offsideAI/macrodork-docs/docs/actuator-selection.md

# Actuator Selection and Parameters

> 🔌 For the servo-bus protocol comparison (including Feetech STS/SCS and HD-1910 specs) see [Hardware Teardown](hardware-teardown.md).

## The Motor: Dynamixel XL330, 15 of Them

| | |
|---|---|
| Model | **Dynamixel XL330-M288-T** (evidence below) |
| Count | **15** - the `xl330` mesh is referenced 15 times in the full MJCF |
| Under policy control | **14**, in the action space: 5 left leg + 4 neck/head + 5 right leg |
| The 15th | Drives the beak/jaw through a `passive_*` linkage - **not in the action space** |
| Mounting | M2 screws (the servo body has 4× Ø2.0 clearance holes + 8× Ø1.6 tapping holes) |
| Supply | ⚠️ **Rated 3.7–6.0 V; the actual bus is 6.6–8.2 V - run over-voltage.** See below |

## ⚠️ The voltage truth: the XL330 is run over-voltage

> **Correction (2026-09-04)**: this document used to call the XL330 a "7.4 V class servo".
> **That was wrong**, and it propagated into the rejection of the Feetech STS3032 and into the
> torque comparison below.

**Robotis official specification**
([XL330-M288-T e-manual](https://emanual.robotis.com/docs/en/dxl/x/xl330-m288/), checked 2026-09-04):

| Item | Official |
|---|---|
| Input voltage | **3.7 – 6.0 V** |
| Recommended | **5.0 V** |
| Stall torque | 0.42 N·m @3.7 V / **0.52 N·m @5.0 V** / 0.60 N·m @6.0 V |
| Gear ratio | 288.4 : 1 |
| Size / weight | 20 × 34 × 26 mm / 18 g |

**The upstream design actually feeds them 6.6 – 8.2 V.** Three independent points in the source agree:

| Source | Value |
|---|---|
| BAM config in `microduck_constants.py` | `vin_range=(6.5, 8.2)`, `vin_min=6.0` |
| `robotd` voltage adaptation | clamped **6.0 – 9.5 V** |
| Battery | NP-F550 is 2S Li-ion: 7.4 V nominal, 8.4 V full |

#### Hard evidence: the official HAT schematic

People reasonably ask: "the XL330 takes 5 V, where's the over-voltage?" 5 V is the
**value recommended in the ROBOTIS datasheet**, not what the upstream design actually wires up.
The official HAT is open source (`pollen-robotics/elec_RPI_Robot_HAT`, Apache-2.0), and
sheet 4/6 `dynamixel.kicad_sch` spells it out:

| Circuit | Actual connection |
|---|---|
| Dynamixel connectors J11 / J13 / J14 | Power pin ties to **`+BATT`** (raw battery), annotated `3A max`, through TH1 100R thermistor |
| Between `+BATT` and the servos | **No regulation at all** - J13/J14 through a TH1 100R thermistor, J3/J11 direct.<br>(U10 LM5050-1 sits *after* the buck on the `+5V` rail, not at the battery input.) |
| The only converter on the board | **U9 AP63205** + **L4 6.8 µH** (Fsw 1.1 MHz, 2 A) → outputs `+5V` |
| Where `+5V` goes | The **Raspberry Pi 40-way header J4**, the PAM8406D audio amp, the EEPROM - the schematic even carries a Pi power table next to it (Pi 5: 9–10 W / Pi 4B: 6–7.6 W / Pi Zero 2W: 1.5 W) |

**The whole 47-line HAT BOM contains exactly one buck and one inductor.** There is no second
rail. The 5 V is *for the Pi*; the servos hang directly off the battery - and a 2 A AP63205
could not feed 15 XL330s anyway (~1.5 A each at stall).

**So upstream runs the XL330 continuously above its 6.0 V rated maximum, up to about 8.2 V.**

### What that means

- ✅ **More torque than the datasheet figure.** Stall torque rises roughly linearly with voltage, so
  at 8 V it is well above 0.52 N·m. This is likely part of how an 18 g servo carries an 800 g robot.
- ⚠️ **Lifetime and heat are the price.** Over-voltage stresses windings and MOSFETs. Upstream has
  published nothing on this, so **the following is inference**: it may relate to the servo heating
  users report, and to upstream starting to consider selling repair kits (see [Community Intelligence](community-intelligence.md)).
- ⚠️ **You have to make this call yourself.** Copy them and you over-volt too. Play safe with a
  regulator down to 5–6 V and you lose torque - **which may mean retraining the policies**, since
  the official ONNX files were trained under the over-volted condition.

> This also explains the firmware's voltage adaptation: `scale × (7.4 / measured EMA)`. As the
> battery falls from 8.4 V to 6.5 V the same PWM produces very different torque; without
> compensation a policy would behave differently at different states of charge.

---

## Joint Travel

| Joint | Travel | Radians |
|---|---|---|
| `hip_yaw` | −25° … +30° | −0.436 … 0.524 |
| `hip_roll` | ±22° | ±0.384 |
| `hip_pitch` / `knee` / `ankle` / `head_pitch` | ±90° | ±1.571 |
| `neck_pitch` | −90° … +60° | −1.571 … 1.047 |
| `head_yaw` | ±170° | ±2.967 |
| `head_roll` | ±25° | ±0.436 |

> The right leg's `hip_yaw` mirrors the left: −30° … +25°.

## The BAM M6 Actuator Config (what ships)

From `robot/microduck_constants.py`:

```python
_BAM_ACTUATOR_KWARGS = dict(
    motor_name="xl330",
    model="m6",
    target_names_expr=(r"^(?!passive_).*",),   # exclude passive joints
    kp_fw=200.0,             # firmware position-loop stiffness (microduck keeps 200, microban uses 125)
    vin_range=(6.5, 8.2),    # per-env battery voltage sampled at startup
    vin_drop_gain_range=(0.0, 0.2),   # load-dependent sag: V_drop = gain * sum(|tau|)
    vin_min=6.0,             # hard floor on the effective voltage after sag
    delay_min_lag=3,         # command delay, in control steps
    delay_max_lag=6,
)
```

BAM M6 is a **voltage-level** model. It is not a simple PD controller - it simulates the
whole chain from firmware PD → PWM → voltage → current → torque, and adds load-dependent
friction (Coulomb + Stribeck + load term) on top. **This is the core of the sim2real
recipe.**

### Three domain randomisations that matter

| Item | Range | What it models |
|---|---|---|
| `vin_range` | 6.5 – 8.2 V | the pack from full charge to flat |
| `vin_drop_gain_range` | 0.0 – 0.2 | **load-dependent sag** - bus voltage dropping when many servos pull at once |
| `delay_min/max_lag` | 3 – 6 steps | communication + firmware latency between command and execution |

`actuator/friction_dr_bam.py` adds a **per-env `friction_scale`** that multiplies only the
**velocity-independent** friction budget (stiction / gearbox), leaving the viscous term at
nominal - because stiction is where the dominant sim2real uncertainty lives.

### Backlash modelling

`BacklashEncoderBamActuator` reproduces a real detail that is easy to miss:

> On the real servo the magnetic encoder sits on the **output side** of the gear play, so
> the firmware position loop closes on `joint angle + backlash angle`. While the servo
> winds through the dead zone, **the measured position does not change, and neither does
> the PD error.**

The implementation feeds `cmd.pos` as `qpos[main] + qpos[backlash]`. Velocity `cmd.vel` is
deliberately left motor-side - it drives back-EMF and friction, which are rotor physics,
not an encoder-derived signal.

The backlash model lives in `robot_allcollisions_backlash.xml`: each servo gets a
`passive_<joint>_backlash` hinge in series.

## Five Calibrated Native-PD Parameter Sets (fallback)

`joints_properties.xml` keeps five sets, all results of BAM bench identification.
**If you use MuJoCo's built-in PD instead of BAM, copy these numbers directly:**

| class | damping | frictionloss | armature | kp | forcerange (N·m) |
|---|---|---|---|---|---|
| `chosen_actuator` ⭐ | 0.053 | 0.0048 | 0.0018 | 0.55 | ±0.96 |
| `chosen_actuator_antoine` | 0.044 | 0.013 | 0.0017 | 0.43 | ±0.75 |
| `chosen_actuator_old` | 0.048 | 0.006 | 0.002 | 0.52 | ±0.91 |
| `chosen_actuator_new` | 0.041 | 0.032 | 0.002 | 0.386 | ±0.67 |
| `perfect_actuator` | 0.15 | 0.1 | 0.001 | 10.0 | ±20.0 |

⭐ = the current default (commented "marc"). `ctrlrange` is ±10.0 throughout.
`perfect_actuator` is an idealised motor for comparison only - **do not train a policy on
it if that policy is going onto real hardware.**

Passive joints: `passive_wheel` / `passive_joint` - damping 0, frictionloss 0,
armature 0.0001.

## Why the XL330: It All Comes Down to the Mass Budget

The XL330 was not chosen because it is strong. It was chosen because **it fits an entire
drive train into 18 g**:

```
motor + 288:1 gearbox + encoder + driver + position loop + bus interface  =  18 g
```

The whole robot is 737 g; the 15 servos alone are 270 g of it (37 %). Nothing else fits in
that box.

### Where the torque comes from: the gearbox, not the motor

### How the model number was pinned down

Upstream has never named the sub-model publicly - the source carries only
`motor_name="xl330"`, **with no suffix**. One independent evidence chain narrows it to
**M288-T**:

1. `microduck_rl` simulates the servos with the **BAM** actuator model, configured as
   `motor_name="xl330"`, `model="m6"` (`microduck_constants.py`), which loads
   `bam/params/xl330/m6.json`
2. BAM is [`Rhoban/bam`](https://github.com/Rhoban/bam), whose README lists its library of
   **identified models**, and the entry for this servo reads
   **`Dynamixel XL330-M288-T`**
3. So the friction model the policies are trained against was **identified on a physical
   XL330-M288-T on a test bench**

Corroboration: on 2026-09-03 the Korean robotics observer
[@Allyakutaku](https://x.com/Allyakutaku/status/2095331280233926948) reported identifying the
motor as XL330-M288-T from official video footage.

> ⚠️ Strictly, this proves the servo **the simulation was calibrated against** is an M288-T.
> That the physical robot uses the same part is a very strong inference, but **not a
> statement from upstream**.

The **288** in the model number is the gear ratio: **288.35:1** (the same family also has
the M077 at 77.9:1).

The coreless motor inside produces only a few **milli**newton-metres on its own; the
288:1 reduction multiplies that to the **±0.96 N·m** (~9.8 kg·cm) calibrated in the MJCF.

**The cost of that is written directly into the model:** the higher the ratio, the more
backlash - which is why `robot_allcollisions_backlash.xml` puts a `passive_*_backlash`
hinge in series with every joint, modelling **±1.0°** of gear play.

---

## Why Closed-Loop Steppers Do Not Work Here

It is a natural idea, and for **static positioning** (CNC, 3D printers) it is the right
one. For a legged robot there are several hard problems:

### 1. Mass - this alone settles it

| | Unit mass | What that includes |
|---|---|---|
| **XL330** | **18 g** | motor + gearbox + encoder + driver + control loop + bus, **all of it** |
| NEMA 8 stepper | ~60 g | **bare motor** - no encoder, no driver, no gearbox |

Fifteen bare NEMA 8s is 900 g - **the motors alone exceed the entire robot's mass (737 g)**,
before anything else is added.

### 2. Holding current

A stepper **must draw rated current to hold position**. A standing biped needs holding
torque at all 15 joints continuously, and the pack is 2600 mAh 2S with about an hour of
runtime.

A servo closes a position loop, so **current approaches zero when the error is small and
the load is light**. Standing still costs almost nothing.

There is a thermal consequence too: fifteen steppers pulling rated current inside a sealed
25 cm plastic body have nowhere to dump the heat.

### 3. ⭐ Backdrivability - the critical one, and the easiest to overlook

A legged robot **has to absorb impacts.** Look at `limp_fall` in the official
`robotd.toml`:

> When a fall is detected, the gain drops from 200 to **`gain_limp = 50`** so the joints
> "give way rather than fight the floor"; after a soft landing the pose is ramped back to
> standing over 600 ms.

**A stepper cannot do this.** It has two states - energised and locked, or unpowered and
free-spinning (and even then it has detent torque). **There is no adjustable impedance in
between.**

A closed-loop stepper corrects lost steps, but that is **recovery after the fact**, not
**compliance in the moment**. What a footfall impact needs is to yield, not a correction
transient.

The entire sim2real recipe - the BAM model, `kp_fw=200`, gain ramping, the soft landing -
rests on the premise that **the servo is a spring with adjustable stiffness**. A stepper is
not a spring. It is a position lock.

### 4. Wiring

15 servos = **one 3-wire daisy chain.**
15 steppers = 15 × 4 phase wires + 15 encoder cables + 15 driver boards.
Inside a 25 cm body, with a neck that has to rotate - it does not fit.

### 5. The part does not exist

18 g, a 288:1 gearbox, integrated encoder and driver, bus daisy chain - **nothing on the
market matches that.**

---

## What Swapping to a Feetech STS3215 Actually Costs

The STS3215 (Feetech, Shenzhen) sells for roughly **¥60–70** - about **a fifth** of the
XL330 (~¥299) - and it is **stronger** (1.86 N·m vs 0.96 N·m). It looks like the obvious
way to cut cost.

**But it is three times heavier (~55–60 g vs 18 g).** Here is what that does, measured.

### Hard data: same architecture, different servo, different robot

Both are 15-rigid-body bipedal robot ducks. Total mass from their MJCFs:

| | Servo | **Total mass** | Height |
|---|---|---|---|
| **Macrodork** | XL330 | **737.2 g** | 25 cm |
| **Open Duck Mini v2** | STS3215 | **2107.1 g** | 42 cm |

**2.86×.**

> 💡 **Open Duck Mini v2 *is* the STS3215 answer.** Same engineer (Antoine Pirrone,
> upstream R&D), same bipedal-duck architecture - swap the servo and the robot can only be
> built at 42 cm and 2.1 kg.

### Actuator parameters: every one differs by an order of magnitude

| Parameter | XL330 (`chosen_actuator`) | STS3215 (`sts3215`) | Ratio |
|---|---|---|---|
| **kp** | 0.55 | **17.8** | **32×** |
| **forcerange** | ±0.96 N·m | **±3.35 N·m** | **3.5×** |
| **damping** | 0.053 | **0.60** | **11×** |
| **frictionloss** | 0.0048 | **0.052** | **11×** |
| **armature** | 0.0018 | **0.028** | **15.5×** |
| modelled backlash | **±1.0°** | ±0.5° | - |

> Sources: `microduck_rl/.../joints_properties.xml` and
> `Open_Duck_Playground/playground/open_duck_mini_v2/xmls/joints_properties.xml`
>
> 📌 A counter-intuitive detail: **the XL330 is modelled with *more* backlash** (±1° vs
> ±0.5°). That may be a difference in how the two projects model it, or it may be the
> price of the 288:1 reduction.

**This is not a re-tune. These are two entirely different actuators.**

### Can you swap without changing the mechanics? No.

| Constraint | Why |
|---|---|
| **Size** | The XL330 measures **29 × 20 × 34 mm** (from `xl330.stl`). The servo cavities in the printed parts are cut to that; the STS3215 is a visibly larger class and does not fit |
| **Mounting** | Horn bolt circle, output-shaft spec and case mounting holes all differ - the M2 pattern this repository reverse-engineered (Ø2.2 clearance + Ø4.4 counterbore) is the XL330's |
| **Mass budget** | 15 × (57−18) ≈ **585 g extra**, before thickening any structure to carry it. Adding 585 g to a 737 g robot invalidates the centre of mass, the joint torque requirements and the structural design |

**This is not "swapping a servo." It is building a different robot.**

### What breaks / what survives

| Breaks | Survives |
|---|---|
| ❌ All nine official ONNX policies | ✅ **The 61-D observation contract and 14-D action space** |
| ❌ The BAM M6 calibration (identified on the XL330) | ✅ The training frameworks (microduck_rl / Playground) |
| ❌ The five `chosen_actuator` sets above | ✅ The sim2real methodology (BAM identification, domain randomisation, backlash modelling) |
| ❌ The backlash model (needs re-measuring) | |
| ❌ MJCF masses and inertias (all recomputed) | |
| ❌ The wire protocol (Feetech SCS/STS, not Dynamixel V2) | |

> **One piece of good news on the protocol:** Open Duck Mini uses
> `rustypot.feetech(port, 1000000)` - **the same `rustypot` crate, just a different
> protocol module**, at the same 1 Mbps. So replacing `Xl330Controller` in the Rust
> runtime is feasible without rewriting the communication layer.

**What changes is the robot model and the actuator model - not the algorithm.**

---

## Same-Class Servos: Why the Gap Is Still Open

"Is there a cheaper XL330?" is the most common question. The answer: **parts in the same
weight class do exist, but none of them satisfies torque and voltage at the same time.**

| Model | Mass | Size (mm) | Stall torque | Voltage | Encoder | Ratio |
|---|---|---|---|---|---|---|
| **Dynamixel XL330-M288-T** ⭐ | **18 g** | **20 × 34 × 26** | **0.52 N·m @5 V**<br>0.60 @6 V / 0.42 @3.7 V | **3.7–6.0 V**<br>5 V recommended | 12-bit | 288.4:1 |
| **Feetech STS3032** | 20 g | **23.2 × 12.1 × 28.5** | 0.44 N·m<br>(4.5 kg·cm @6V) | **4.8–6 V** | 12-bit | - |
| **Feetech SCS0009** | **11 g** | - | 0.23 N·m<br>(2.3 kg·cm) | 6 V | 10-bit | 1:416 metal gears |
| Feetech STS3215 | ~55–60 g | larger class | 1.86 N·m<br>(19 kg·cm) | 7.4 V | 12-bit | - |
| Dynamixel XL330-M077 | 18 g | same as M288 | low (high-speed variant) | same as M288 | 12-bit | 77.9:1 |
| **Unitree S288** ⭐ | **19.5 g** | **34 × 20 × 23** | **unclear (see below)** | **12.6 V** | **15-bit dual<br>+ output-side** | **288.35:1** |
| Unitree J288 | 35 g | 34 × 20 × 23 | unclear (metal-gear version) | 25.2 V | same as S288 | 288.35:1 |

> **This table uses vendor stall-torque figures throughout** (checked against each
> manufacturer's site on 2026-09-04), so the rows are comparable.
>
> The `forcerange = ±0.96` in this repository's MJCF is a **MuJoCo simulation force limit, not a
> vendor figure**, and has been removed from the table - earlier versions compared it directly
> against other vendors' stall torques, which was wrong.
>
> XL330 dimensions are Robotis' official 20 × 34 × 26 mm; the 29 × 20 × 34 measured from
> `xl330.stl` includes the horn and cable socket.
> Everything else is vendor-published data. **Prices vary enormously by region and are not
> listed here** - the same STS3032 retails imported in India at about ₹3,451, and at an
> entirely different price level in China.

### ⭐ Unitree S288: the only part that matches the XL330 across the board

A 2026 arrival. **Its mechanical parameters line up almost item for item** - right down to
the "288" in the model number:

| | XL330-M288 | Unitree S288 | |
|---|---|---|---|
| Mass | 18 g | **19.5 g** | ✅ |
| Size | 20 × 34 × 26 mm | **34 × 20 × 23 mm** | ✅ |
| **Gear ratio** | **288.35:1** | **288.35:1** | ✅ **identical** |
| Mounting screws | M2 | **M2** | ✅ |
| Bus physical layer | single-wire half-duplex TTL | **single-wire half-duplex TTL (1-Wire)** | ✅ |
| Baud rate | 1 Mbps | **6 Mbps** | ⬆️ 6× |
| Motor | brushed coreless | **brushless, FOC** | ⬆️ |
| Encoder | 12-bit, rotor side | **15-bit dual + output-side** | ⬆️⬆️ |
| Control mode | position loop + kp | **torque feedforward + adjustable stiffness/damping** | ⬆️⬆️ |
| **Voltage** | ~7.4 V (2S) in practice - rated 3.7–6.0 V, **run at 6.6–8.2 V** | **12.6 V (3S)** | ⚠️ **incompatible** |
| **Bus capacity** | 253 addresses | **15 (0–14; 15 is broadcast)** | ⚠️ |
| Torque | **0.96 N·m** | **unclear** | ⚠️ |

> Dimensions, connector, protocol and control law come from the official
> [J288/S288 brushless digital servo user manual](https://www.unitree.com/images/%E6%97%A0%E5%88%B7%E6%95%B0%E5%AD%97%E8%88%B5%E6%9C%BAJ288S288%E4%BD%BF%E7%94%A8%E6%89%8B%E5%86%8C.pdf)
> (11 pages, read in full); mass, voltage and encoder resolution from the
> [product page](https://www.unitree.com/cn/DigitalServo/).

#### Two substantive upgrades

**1. Impedance control, not a position servo**

The manual gives the hybrid control law:

```
tau = tau_ff + k_p * (p_des - p) + k_d * (w_des - w)
```

**Torque feedforward plus adjustable stiffness and damping**, over an FOC inner loop.

Upstream's `limp_fall` buys compliance by dropping kp from 200 to 50; with an S288 you
would **command the torque directly** - cleaner, and exactly the joint-level force control
a legged robot actually wants.

**2. An output-side encoder - which eliminates the backlash problem outright**

The return packet carries `uint16_t OutPos : 13` (output-side sensor, 2^13 per revolution).

The XL330's encoder is on the **rotor side** and cannot see gear play - which is precisely
why `microduck_rl` has to add `passive_*_backlash` hinges and simulate the "firmware
position loop reads through the backlash" behaviour (see `BacklashEncoderBamActuator`
above).

**The S288 measures the true joint angle directly, and all of that complexity goes away.**

Its telemetry also includes case temperature, winding temperature, servo-side voltage,
rotor torque/speed/position, and a 22-bit fault code (over-current, over-voltage,
under-voltage, chip/MOSFET/case/winding over-temperature, errors on each of the three
encoders, and so on). Far richer than the XL330's.

#### Three hard constraints

**① Voltage: 12.6 V vs 7.4 V**
This robot is 2S (NP-F550); the S288 wants **3S**. Battery, power distribution and the HAT
all have to be redesigned.

**② The bus holds only 15 servos**
The address space is **0–14** (15 is broadcast). The robot has exactly 15 servos - **the
space is exactly full** - but its bus also carries the **IMU board at ID 200**.
**Under an S288 design the IMU must move to SPI or I²C.**

> This agrees with the recommendation in [Hardware Teardown](hardware-teardown.md):
> moving the IMU off the servo bus onto the host's SPI is better for reliability anyway.

**③ ⚠️ The torque specification is ambiguous - and unresolved**

The product page lists the S288 stall torque as "same direction **0.07 N·m** / reverse
**0.2 N·m**", but the manual states plainly:

> "All parameters in the protocol are **rotor-side** data. The reduction ratio is 288.35;
> to convert rotor-side data to output-side, multiply or divide by that ratio."

Neither reading works:

| Reading | Output torque | Verdict |
|---|---|---|
| Those figures are **rotor-side** | 20 / 58 N·m | ❌ impossible for a 19.5 g servo |
| Those figures are **output-side** | 0.2 N·m | ❌ one fifth of the XL330's (0.96) - not a drop-in |

**This has to be confirmed with Unitree, or measured.** Four questions worth asking:

1. Is the quoted stall torque **rotor-side or output-side**?
2. What exactly do "same direction / reverse" mean - forward vs reverse rotation, or
   driving vs backdriving?
3. What are the **output-side** continuous and peak torques?
4. Is 12.6 V nominal or a maximum? Can it run at 7.4 V, and how much torque is lost?

> For extrapolation: the J288 is the 35 g metal-gear version, listed at 0.5 / 1.5 N·m. If
> 1.5 is output-side, that is plausible for 35 g of brushless at 288:1 and beats the
> XL330. Scaling down suggests the S288 might land near 0.5 N·m output-side - **but this
> is speculation and not a basis for a decision.**

#### Verdict: mechanically a drop-in, electrically and protocol-wise not

| | |
|---|---|
| ✅ **Mechanical** | Size, mass, gear ratio and M2 pattern all correspond; the printed parts may need little or no change |
| ⚠️ **Electrical** | 12.6 V vs 7.4 V - battery and power system must be redesigned |
| ❌ **Protocol** | Unitree's own 20-byte command / 26-byte reply with CRC32 at 6 Mbps, nothing like Dynamixel Protocol V2; `rustypot` does not support it, so the communication layer must be rewritten |
| ❌ **Policies** | All nine official ONNX policies become invalid - both the torque characteristics and the control mode change |
| ✅ **What you gain** | Joint force control, an output-side encoder, a 6 Mbps bus, rich thermal and fault telemetry |

**If the torque question resolves favourably, this is currently the only XL330 alternative
worth evaluating seriously.**

### STS3032: right size, wrong torque and voltage

The closest of the Feetech parts: **smaller than the XL330** (23.2 × 12.1 × 28.5 vs
29 × 20 × 34), nearly the same mass (20 g vs 18 g), the same 12-bit encoder class, the same
half-duplex bus architecture.

**Two problems - and note that this document previously overstated both:**

1. **Torque is about 85 %, not 46 %** - on a same-voltage basis, 0.44 N·m @6 V vs the
   XL330's 0.52 N·m @5 V. The earlier "46 %" compared 0.44 against the simulation force
   limit 0.96; the two are not comparable.
2. **The voltage ceiling is 6 V - but the XL330's ceiling is also 6 V.**
   The difference is not in the servo specs; it is that **upstream chose to run over-voltage**
   (see the section above). To copy the design with an STS3032 you either over-volt it
   the same way (at your own risk) or add a regulator stage down to 5 V.

### Could you mix servo types?

| Joint group | Count | Torque demand | STS3032 enough? |
|---|---|---|---|
| Legs (hip yaw/roll/pitch, knee, ankle) | 10 | High - carries 737 g and absorbs landing impacts | ❌ **no** |
| Neck / head (pitch, yaw, roll) | 4 | Medium - drives a 189 g head assembly | ⚠️ possibly |
| Mouth | 1 | Low | ✅ yes |

**Mixing is theoretically possible; a full swap is not.** But mixing means solving the
7.4 V → 6 V step-down, and the two servo types have different BAM parameters, backlash and
response delay - training would need per-group actuator models, which adds considerable
complexity.

### A telling data point: upstream uses Feetech themselves

**The SCS0009 is used in upstream's own
[Amazing Hand](https://github.com/pollen-robotics/AmazingHand) and HopeJR.**

They are not unaware of the cheap option - **these legs genuinely need that
torque.** 0.23 N·m is enough for a finger joint and not enough for a biped's knee.

### Where the gap is

```
Wanted:  18-20 g  .  >=0.5 N.m at rated voltage  .  tolerates direct 2S supply or carries its own regulator  .  bus daisy chain  .  integrated encoder + driver
Today:   Robotis XL330     meets all of it, but must be over-volted to 6.6-8.2 V to do so
         Unitree S288      meets mass/size/ratio/bus; the 12.6 V (3S) rating is the only obstacle
         Feetech STS3032   meets mass/size, torque ~85 %, shares the XL330's 6 V ceiling
```

**The gap is being squeezed - the Unitree S288 has closed most of it.** What still blocks
it is the voltage class (3S vs 2S) and the unresolved torque labelling. If Unitree ships a
2S variant, or the torque is confirmed at the 0.9 N·m level, the slot is filled.

Feetech's line is heading the same way - **SCS0009 (11 g) → STS3032 (20 g) is a clear
"smaller and bus-connected" trajectory**; the housing is already there, what is missing is
raising the ratio or the voltage class to lift the torque into the 0.9 N·m range.

Two market signals reinforce this:

- The **LeRobot ecosystem** (Hugging Face) has already made the STS3215 a de facto standard for arms
- **The upstream robot passed $1 M in sales within seven hours of launch**, proving real demand at the 18–20 g scale

> ⚠️ **This is a read of the trend, not a prediction.** As of 2026-08-31 no vendor has
> announced such a part. But the gap is well defined, the housings exist, and the demand is
> demonstrated - it is plausible that this slot gets filled.

**If such a part does appear**, this repository becomes more valuable, not less: the
mechanical geometry, the assembly relationships, the electronics design and the actuator
parameters are all already understood, so adapting is a matter of days rather than starting
from zero.

---

## Conclusion: There Is No Middle Path

| Route | Outcome |
|---|---|
| **Keep the XL330** | Use this repository's CAD directly, run the official policies as they are. Servos cost about **¥4,500** |
| **Switch to the STS3215** | Servo cost drops to about **¥1,000**, but every mechanical part is redesigned and every policy retrained - **which is, in effect, building [Open Duck Mini v2](https://github.com/apirrone/Open_Duck_Mini)** (fully open: BOM, Onshape CAD, 36 STLs, assembly guide, working walk policy) |
| **Switch to the Unitree S288** | Mechanically almost a match (19.5 g / 34×20×23 / 288.35:1 / M2), and brings joint force control plus an output-side encoder. Needs a 3S pack, a rewritten communication layer and retrained policies - **and the torque spec is ambiguous and must be confirmed first** - see the dedicated section above |
| **Wait** | The gap is closing. If a 2S variant appears, or the torque is confirmed, this repository's mechanical and electronics work carries straight over |

**Within this weight class, only Robotis currently offers enough torque.** The Feetech
STS3032 is smaller and about the same mass, but delivers about **85 %** of the torque
(0.44 N·m @6 V vs the XL330's 0.52 N·m @5 V, same-voltage basis) with a 6 V ceiling; the
SCS0009 is lighter (11 g) but only 0.23 N·m. See the side-by-side comparison in the
previous section.

## A Note on Cost

The XL330-M288-T varies enormously by channel (checked 2026-09-04): **$23.90** at ROBOTIS
international, **$27.49** at ROBOTIS US, **€40.20** inc-VAT at Generation Robots, **€41.95** at
MyBotShop - that is **$359 / $412 / €603 / €629** for
fifteen - and around ¥299 each domestically in China, about **¥4,500** for fifteen. Either
way that exceeds the **$399** retail price of the finished robot. $399 is a volume price an
individual cannot reach.
