offsideAI/macrodork-docs/assets/hw/macrodork-hardware-diagrams.pdf

M A C R O D O R K · E L E C T R O N I C S

# Macrodork hardware diagrams

### Five modules, two home-made boards, one bus. Every pin, address and register is taken from the official open-source hardware project and the runtime

source code; none of it has been verified on real hardware.

Servo bus · half-duplex TTL 1 Mbps | +BATT 6.6–8.2 V | +5V / +3V3 | I²C · 400 kHz | MIPI CSI | I²S audio

Bus devices
16

15 servos + 1 IMU board

Control cycle

# 20 ms

50 Hz, one read, one write

Home-made boards
2

HAT is open source / IMU board must be drawn

Policy network

# 775 KiB

×9 ONNX files

# Where things live

The easiest thing to get wrong: the main board is not in the trunk, it is in the head. Camera, main board and HAT all belong to the same MJCF body, jaw_soft ; the camera sits about 13 mm from the centre of the main board with no joint in between. The trunk cavity is almost entirely filled by the two hip-yaw servos, and the battery hangs outside, below the rear of the body.

How to read: grey dashed boxes are physical regions, solid boxes are modules, a red dashed box means mounted outside the shell. Orange is the servo bus (top to bottom), red is battery power (bottom to top). The camera is only ~13 mm from the main board and shares its rigid body, so buy the shortest MIPI ribbon you can; what actually has to pass through the 3-DoF neck is the servo bus and the power wiring, and those two bundles are the flex-fatigue points. Source: robot_walk.xml:235 (HAT), :247 (main board), both inside the jaw_soft body.

READ THIS BEFORE BUYING
Because the main board lives in the head and the slot is only 65 × 30 mm, no larger board will fit - the LCSC Taishan Pi is 70 × 45 mm, the same RK3566 but it does not go in, and a HAT still has to sit on top of it.

01

Head · MJCF body jaw_soft

IMX219 camera

### 8 MP · MIPI CSI

Mounted rotated 90°

MIPI CSI

~13 mm · no joint

Radxa Zero 3W main board

RK3566 · 65 × 30 mm · NPU 0.8 TOPS

40-pin header

RPI Robot HAT

65.0 × 30.9 mm · 4-layer · 113 SMD parts

I²S

i2c3 · 0x29

Speaker 5 W + microphone

Wago terminals · on-board MEMS

ToF module

VL53L5CX / L8CX · 8×8

Neck · 3 DoF Only these two bundles cross the neck

Servo bus ↓
3 wires: V+ / GND / DATA

+BATT supply ↑
Battery in the trunk, HAT in the head

Trunk · trunk_base shell 80.9 × 64.0 × 41.8 mm

Hip-yaw servos ×2

XL330 · ID 10 / 20
These two fill most of the cavity No room for a main board

imu_to_dxl

ID 200 · 16th device on the bus

STM32G031 + LSM6DSV16X
The only board drawn from scratch

Remaining servos ×13

ID 11–14 · 21–24
ID 30–34
legs / neck / head / jaw

NP-F550 battery

2S · 6.6–8.2 V
38.6 × 20.6 × 70.8 mm
Hangs outside, rear-bottom of the body ~40 mm hangs outside the shell

Dashed box = mounted outside the shell

The bus is a 3-wire daisy chain (V+ / GND / DATA): power and data share one cable. The solid dots at the three tap points mean they all join the same bus.

# The battery feeds two rails; the servos run on raw battery voltage

This is the most counter-intuitive thing on the whole HAT: the servos are wired to raw battery voltage, with no step-down at all. The XL330 is officially rated 3.7–6.0 V, recommended 5.0 V, yet here it gets 6.6–8.2 V. That is not a typo; it is a deliberate upstream choice - more stall torque, paid for in heat and lifetime.

Key evidence: in the HAT's 47-line BOM there is only one inductor (L4) and one buck (U9); FB1/FB2/FB3 are ferrite beads, not energy-storage inductors. So that 5 V rail can only be for the main board - a 2 A AP63205 could not drive 15 XL330s anyway (about 1.5 A each at stall).

## Supply, charging and over-voltage protection

02

NP-F550

6.6 – 8.2 V
2S Li-ion

+BATT

J13 / J14 TTL 3P
JST EH 2.5 mm · the XL330s use these two

TH1 100R

J3 / J11 RS-485 4P

Direct +BATT · U8 SIT3088E driver

Servos - no step-down anywhere, marked 3 A max

C19
10µF/63V

U9 AP63205 + L4

### 6.8 µH · 2 A · 1.1 MHz

The only switching regulator on the board

Q2 · U10 LM5050
Ideal diode + shutdown detect

+5V

Main-board 40-pin header

PAM8406D amplifier

XC6206 → +1V8
audio codec

+3V3 goes the other way: the main board feeds it to the HAT over the 40-pin header; the HAT does not generate it itself.

How to read: above the axis are the voltages that will actually occur, below it are the voltage ratings of each part. Whenever a line below falls inside a range above, that part is the bottleneck. Common 3.3 V LDOs all land inside the battery range - they simply burn. ⚠ The back-EMF magnitude is illustrative, not measured - it depends on cable inductance and commutation speed; put a scope on it once the parts arrive.

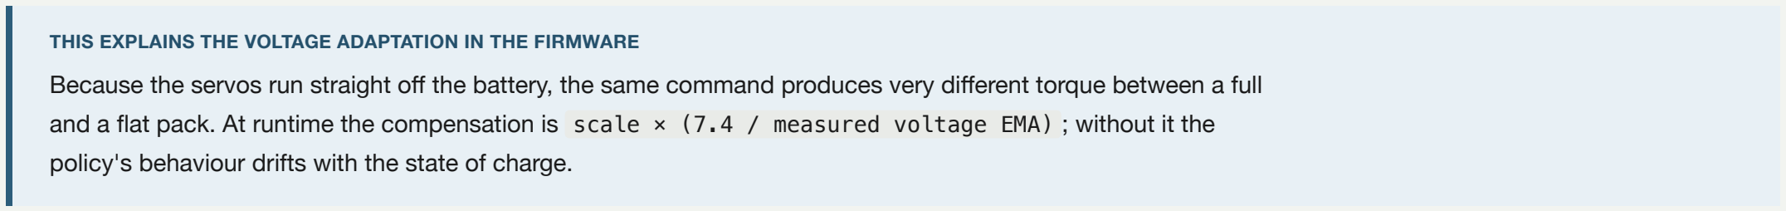
[picture p4: figure]

THIS EXPLAINS THE VOLTAGE ADAPTATION IN THE FIRMWARE
Because the servos run straight off the battery, the same command produces very different torque between a full and a flat pack. At runtime the compensation is scale × (7.4 / measured voltage EMA) ; without it the policy's behaviour drifts with the state of charge.

Charging - there is no charging circuit on the board

External cradle charger
The battery comes off to charge

NP-F550

2S · 6.6 – 8.4 V

⚠ The stock HAT has no charging IC and no USB-C receptacle
Plugging in USB-C will not charge the robot - checked against the full BOM

+BATT

15 × servos

via TH1 100R · 3A max

AP63205 → +5V

Main board → feeds +3V3 back to the HAT

imu_to_dxl
Same rail as the servos ↓

imu_to_dxl input protection chain - it shares the bus with the servos and will see back-EMF

3P connector into the board
6.6 – 8.4 V

PPTC 100 mA
A shorted board does not drag the bus down
(to be added)

TVS SMAJ12A
Clamps at 19.9 V · next to the connector
(to be added)

C6 10µF/25V
+ 100nF at the input pin

HT7533-1
30 V operating / 33 V absolute max → +3V3

Voltage window - the bottleneck at a glance Battery 6.6–8.4 V
Servo back-EMF can lift the bus into this range

Depends on cable inductance and commutation speed - must be measured

0 | 5 | 10 | 15 | 20 | 25 | 30 | 35 V
⚠ XL330 rated max 6.0 V (the stock design runs it over) | C7 10 V (on the 3.3 V output side - sufficient) | C6 25 V ✓

✕ Common 3.3 V LDOs all top out here (shaded band, 5.5–6.5 V)
- inside the battery range, they simply burn
| | | | | TVS clamp 19.9 V ← spikes are held here
⚠ Feetech HD-1910 max 8.4 V - exactly a full charge, zero margin | HT7533-1 operating 30 V ✓ margin 3.5×

Three lines of defence: a wide-input LDO (chosen) blocks sustained over-voltage · a TVS (to be added) clamps transient spikes · a PPTC (to be added) keeps a fault on this board from taking the whole bus down. A series diode guards against reverse polarity; it does nothing for forward over-voltage.

# Sixteen devices on one bus

This is the central argument of the whole design: 15 servos are daisy-chained on one three-wire bus, and the IMU also masquerades as a device on that bus. So the main board issues a single sync_read per cycle and gets body attitude and all 15 joint angles back together - timestamps aligned by construction, with no software juggling of jitter between two separate data paths.

Why not ordinary servos: PWM servos are open-loop and cannot report their real angle, and the policy must know where every joint is right now. Bus servos have a built-in encoder and driver, and one UART handles all 15. Source: JOINT_IDS and IMU_DXL_ID in duck-control/src/model.rs .

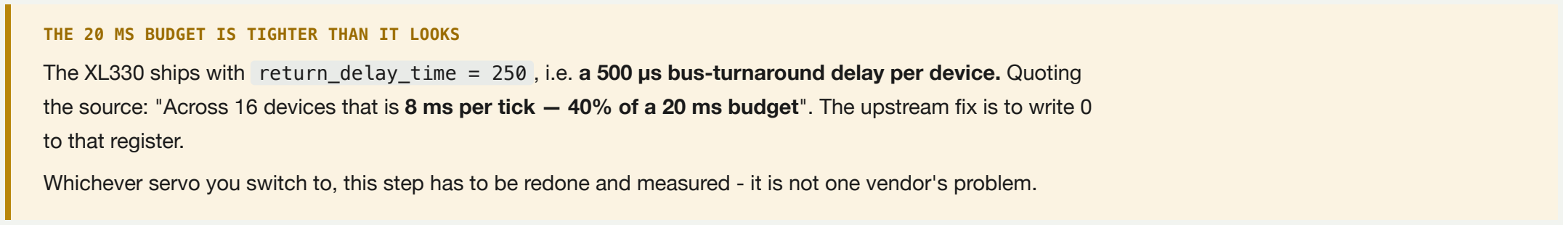
[picture p5: figure]
to that register.

THE 20 MS BUDGET IS TIGHTER THAN IT LOOKS
The XL330 ships with return_delay_time = 250 , i.e. a 500 µs bus-turnaround delay per device. Quoting the source: "Across 16 devices that is 8 ms per tick — 40% of a 20 ms budget". The upstream fix is to write 0

Whichever servo you switch to, this step has to be redone and measured - it is not one vendor's problem.

03

Main-board UART

/dev/ttyS2
GPIO14 Tx · GPIO15 Rx

Tx

Rx

Half-duplex direction switch

U5 74LVC1G08 (AND gate)
U6 1G125 · U7 1G126 (tri-state) Direction derived automatically from Tx

### 1 Mbps

single-wire half-duplex · 3-wire daisy chain

Right leg
ID 10 – 14
hip yaw / hip roll / hip pitch knee / ankle

Left leg
ID 20 – 24

Mirror of the right leg

Neck · head · jaw
ID 30 – 34

The jaw is not in the policy action space

imu_to_dxl
ID 200

Disguised as the 16th "servo" register 124 · 12 bytes

15 servos + 1 IMU board = 16 devices, all read back in a single sync_read.

# One cycle, 20 milliseconds

The control loop has only five steps, and they happen in this order. The numbers here are the real sequence, not typographic decoration.

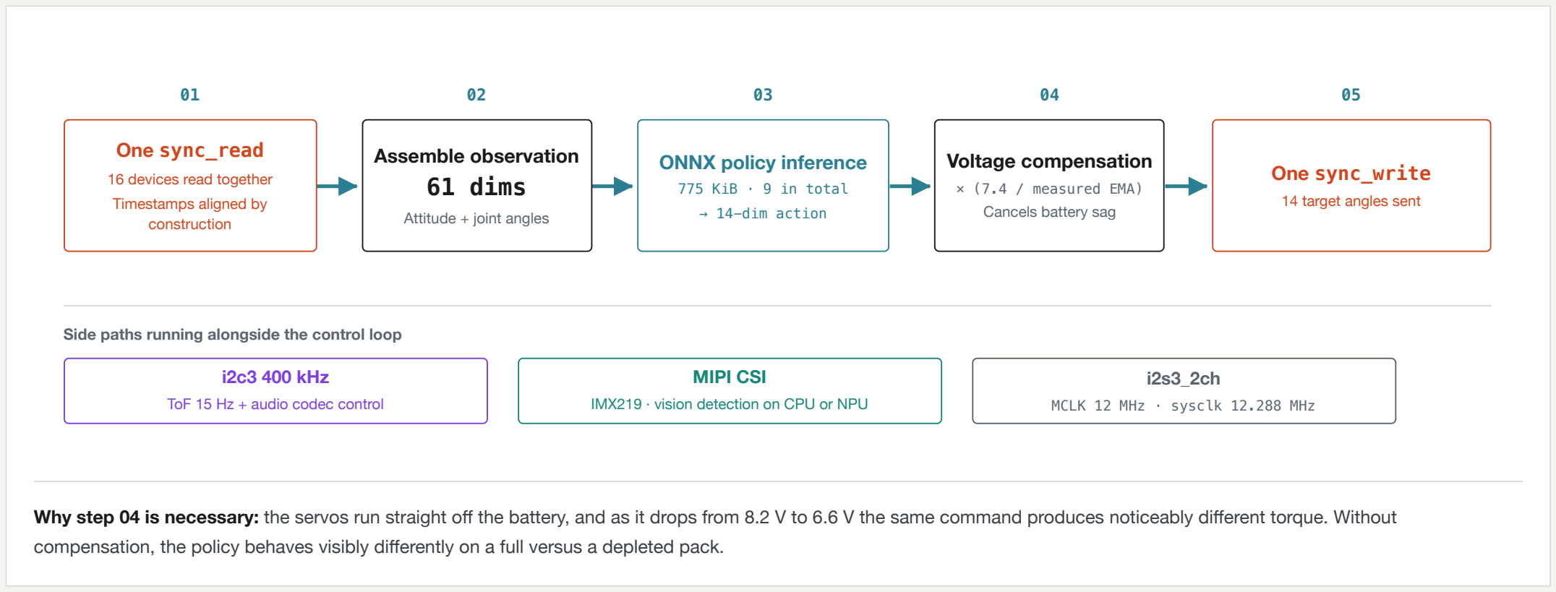
[picture p6: figure]
One sync_read; 16 devices read together Timestamps aligned by construction; Assemble observation 61 dims; Attitude + joint angles; ONNX policy inference; 775 KiB · 9 in total; → 14-dim action; Voltage compensation; × (7.4 / measured EMA) Cancels battery sag; One sync_write; 14 target angles sent; i2c3 400 kHz; ToF 15 Hz + audio codec control; MIPI CSI; IMX219 · vision detection on CPU or NPU; MCLK 12 MHz · sysclk 12.288 MHz

Why step 04 is necessary: the servos run straight off the battery, and as it drops from 8.2 V to 6.6 V the same command produces noticeably different torque. Without compensation, the policy behaves visibly differently on a full versus a depleted pack.

04

Side paths running alongside the control loop

# The board you have to draw yourself

Its entire job is three things: read the IMU, pack the data into 12 bytes, and hand those 12 bytes over when the host issues a sync_read . Upstream has not open-sourced this board, but the protocol and register layout can be reconstructed in full from the runtime source - the code is the spec.

Why the detour is worth it: if the IMU were wired straight to the main board over I²C or SPI, attitude and joint angles would arrive over two different data paths, their sample instants would not line up, and a few milliseconds of jitter would contaminate the 61-dimensional observation directly. As a bus device, the problem does not exist at the hardware level.

WORKS WITH BOTH FEETECH AND THE STOCK SERVOS: NO HARDWARE CHANGE
The physical layers of the two protocols are identical - half-duplex single-wire TTL, 1 Mbps, three wires, 2.5 mm pitch connector. They differ only in packet format: Dynamixel V2 is FF FF FD 00 + CRC-16, Feetech STS/SCS is FF FF + inverted checksum.
So draw the hardware once and give the firmware two parsers; it can even listen on the bus at power-up and check whether the third byte is FD to detect the protocol automatically - plug in and go.

05

LSM6DSV16X
ST 6-axis IMU
SFLP fusion block
Quaternion straight out of the chip

SPI

pins 12/13/14

STM32G031F8P6

Only moves and packs data
It does not compute the quaternion It only frames the reply

Half-duplex buffer

SN74LVC1G125
3-wire connector, 2.5 mm pitch

Servo bus
ID 200 · 1 Mbps

### 12 bytes starting at register 124

gyro X
int16 LE

gyro Y
int16 LE

gyro Z
int16 LE

quat X
fp16

quat Y
fp16

quat Z
fp16
0 | 2 | 4 | 6 | 8 | 10 | 12

Gyro range ±500 dps, 17.5 mdps/LSB.

Only x / y / z of the quaternion are sent - the host recovers w from the unit-quaternion constraint: w = √(1 − x² − y² − z²), saving 2 bytes.

Note: pins 12 / 13 / 14 in the diagram are CS / SCL / SDA, from ST DS13510 Rev 1 Table 1 (page 10).

# 40-pin usage and key addresses

PIN / BUS | PURPOSE | LINUX DEVICE | SOURCE
GPIO14 / GPIO15 | Servo bus Tx / Rx | /dev/ttyS2 @ 1 Mbps | robotd.toml
GPIO02 / GPIO03 | I²C - IMU, audio codec, Stemma | i2c3 @ 400 kHz | i2c3-pihat.dts
GPIO18 / 19 / 20 / 21 | Audio PCM clock / frame sync / in / out | i2s3_2ch | aic3104-i2c3.dts
GPIO06 | Shutdown detect | — | HAT schematic
GPIO22 | Interrupt pin of the BMI088 on the HAT - unused by software | — | i2c3-pihat.dts
MIPI CSI | IMX219 camera, mounted rotated 90° | radxa-zero3-rpi-camera-v2 | setup-board.sh
i2c3 · 0x18 | Audio codec TLV320AIC3104 | — | i2c3-pihat.dts
i2c3 · 0x29 / 0x52 | ToF, both addresses are tried | — | tof/src/main.rs
i2c3 · 0x19 / 0x68 | BMI088 - populated but marked dormant in software | — | i2c3-pihat.dts
Bus ID 200 | imu_to_dxl, register 124, 12 bytes long | — | duck- control/model.rs

THIS TABLE IS THE CHECKLIST
The upstream Microduck software is open source, so every address on the hardware has a counterpart in the code. If they don't match, one side is wrong - that is the cheapest verification step when replicating.

06

# Two routes: stock XL330 versus Feetech STS

The "IMU as the 16th device on the bus" architecture holds on Feetech too - because Feetech STS/SCS has its own bulk-read instruction, SYNC READ ( 0x82 ), used exactly the same way as on Dynamixel.

And the reply mechanism is the same on both sides. Protocol V2 does have a fast sync read ( 0x8A ) that merges every reply into one packet, but the official runtime does not use it - a repo-wide search for
fast_sync_read / 0x8A returns nothing, and duck-control/src/bus.rs:236 calls the plain sync_read_raw_data . This is also consistent with the "500 µs per device × 16 devices = 8 ms" in the source - if the replies were merged into one packet, the per-device delay would not be multiplied by 16.

Source: the Feetech side is read from scservo_sdk/group_sync_read.py (replies split packet by packet on [0xFF, 0xFF, scs_id] ) and register 7 of the STS memory map; the stock side from duck-control/src/bus.rs:236 and model.rs:84-86 . ⚠ Packet counts and spacing in both rows are drawn from the protocol as an illustration, not measured waveforms - measure with an FE-URT-1 once the parts arrive.

UNEXPECTED FINDING: OUT OF THE BOX, FEETECH IS ACTUALLY AHEAD
Register 7 (0x07) of the STS memory map, Return Delay Time: default 0, with the note "Not functional on STS".
The XL330 ships at 250 , i.e. 500 µs per device - quoting the upstream source: "Across 16 devices that is 8 ms per tick — 40% of a 20 ms budget" - and it has to be written to 0 by hand.
Since the reply mechanism is the same on both sides, this becomes the only substantive difference in the factory state - and it favours Feetech. Of course, writing a 0 on the XL330 side erases it, so this is not "Feetech is faster", it is "Feetech has one trap fewer".

07

Stock XL330 · sync_read (factory Return Delay = 250)

Host instruction packet

Dashed block = 500 µs idle wait per device (factory default; write 0 to remove it)

Feetech STS/SCS · sync_read 0x82 (Return Delay default 0)

Host instruction packet

16 independent status packets, back to back

Cumulative idle wait

### 8 ms / cycle

Cumulative idle wait
0

Both rows use the same reply mechanism - the official runtime uses the plain sync_read, not V2's packet-merging fast sync read (a repo-wide search for 0x8A finds nothing). The difference is in the factory defaults.

## Protocol differences at a glance

ITEM | DYNAMIXEL V2 · XL330 | FEETECH STS/SCS
Physical layer | Identical - half-duplex single-wire TTL, 3 wires (V+ / GND / DATA), 1 Mbps
Connector pitch | JST EH 2.5 mm | 5264, also 2.5 mm
Header | FF FF FD 00 | FF FF
Checksum | CRC-16 | ~sum (inverted sum)
Bulk read | sync read (what upstream actually uses) also fast sync read 0x8A, unused | sync read 0x82
Reply scheme | Same - one independent status packet per device
Bus turnarounds / cycle | 17 ⚠ | 17 ⚠

⚠ The turnaround count is inferred from the protocol (1 instruction + 16 replies), not measured

Factory return delay | 250 = 500 µs / device, must be written to 0 | Default 0, and not functional on STS
ID range | 0 – 252 | 0 – 253 (register 5)
Baud-rate setting | register baud_rate = 3 | register 6, 0 = 1M

ONE MORE REGISTER WORTH TUNING ON THE FEETECH SIDE
Register 8 (0x08) of the STS memory map, Response Level, default 1 - "reply to every command". Set it to 0 and only read and ping return a packet; ordinary write instructions no longer take up bus time.
This is the same kind of move as upstream writing 0 to return_delay_time on the XL330: the factory defaults are for general use; a high-rate control loop has to tune them itself.

## What switching to Feetech does to each module

MODULE | IMPACT | NOTES
Main board | Unchanged | Independent of the servo protocol
Camera / ToF | Unchanged | Each uses its own separate interface
HAT | No change at all | Feetech and XL330 have identical physical layers - 3-wire half-duplex TTL, 1 Mbps, 2.5 mm pitch connector. J13 / J14 on the HAT are TTL 3P ports; Feetech servos plug straight in, not a single wire needs to move
imu_to_dxl | Hardware architecture unchanged | Same physical layer, so one hardware revision is enough; the firmware detects the protocol from whether the third header byte is FD , with two parsing branches. Standardise the connector on 2.5 mm pitch and it works with both
Policy | Almost certainly needs retraining
Changing servos changes both the torque curve and the mass; the nine upstream ONNX files cannot be reused as they are. This is the single biggest piece of work on the whole route, and it has nothing to do with the protocol

ANOTHER QUESTION: DOES THIS HAT NEED TO BE BUILT AT ALL?
This is independent of which servo you pick; it is purely a cost call. The HAT is a 4-layer board with SMD assembly - prototyping starts at a few hundred yuan with a minimum order quantity - and roughly half the circuitry on it is audio (codec, amplifier, on-board microphone, speaker terminals).
If you are not doing voice features, that half of the board is wasted - in which case a bus adapter board costing twenty-odd yuan plus a buck module covers the two functions that are actually essential, "servo bus" and "power distribution", with the ToF hanging directly off i2c3. The price is losing on-board audio and Pi HAT+ identification.

DO THIS BEFORE DRAWING THE BOARD
The turnaround counts above are protocol facts, but converting them to milliseconds is an estimate. The real number depends on the tri-state buffer switching speed, the inter-packet gaps and the actual register length being read - only a measurement on real hardware will tell.
First thing once the servos arrive: connect a debug board, run both read methods, and time one full round of 16 devices. Until that number exists, the architectural decisions on the board are spinning in the void.

Derived from the publicly released MJCF model, STL meshes, open-source hardware project ( elec_RPI_Robot_HAT , Apache-2.0) and runtime source; not verified on real hardware. Every pin, address, register and reference designator in these diagrams can be cross-checked against those sources.
