offsideAI/macrodork-docs/_design-inspiration/menlo-asimov-1-desktop.png

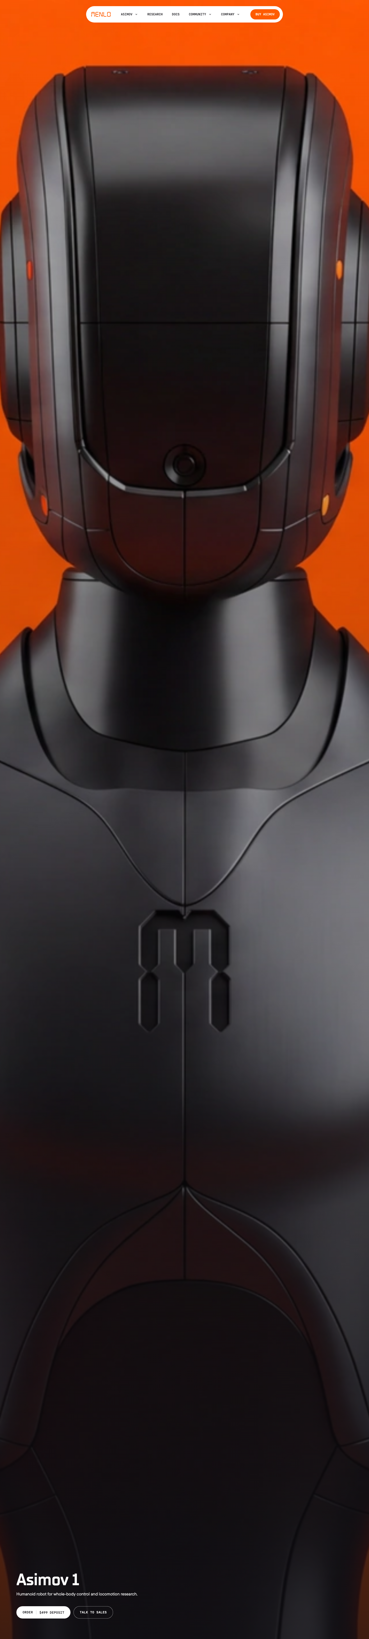
_design-inspiration/menlo-asimov-1-desktop.png
