offsideAI/macrodork-docs/_design-inspiration/menlo-asimov-1-fullpage.png

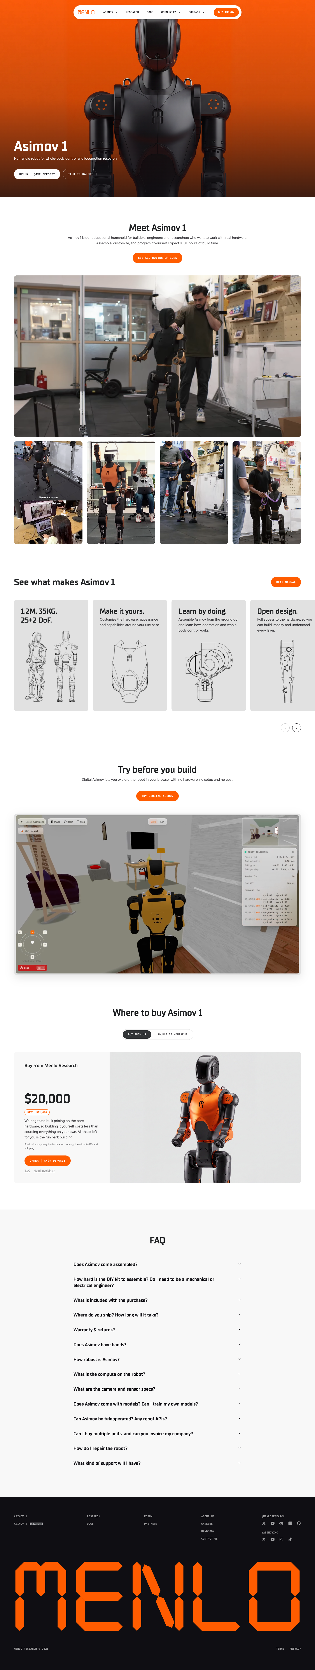
_design-inspiration/menlo-asimov-1-fullpage.png
