offsideAI/macrodork-docs/_design-inspiration/menlo-asimov-1-scroll-00.png

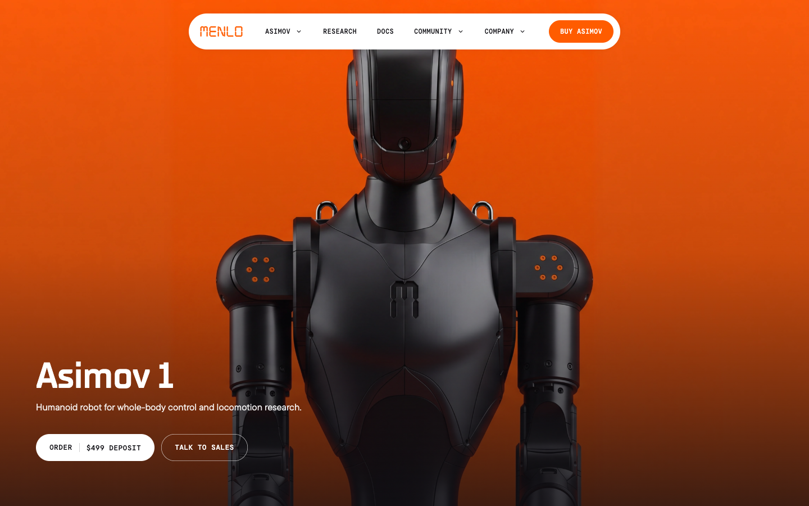
_design-inspiration/menlo-asimov-1-scroll-00.png
