offsideAI/macrodork-docs/_design-inspiration/menlo-asimov-1-scroll-03.png

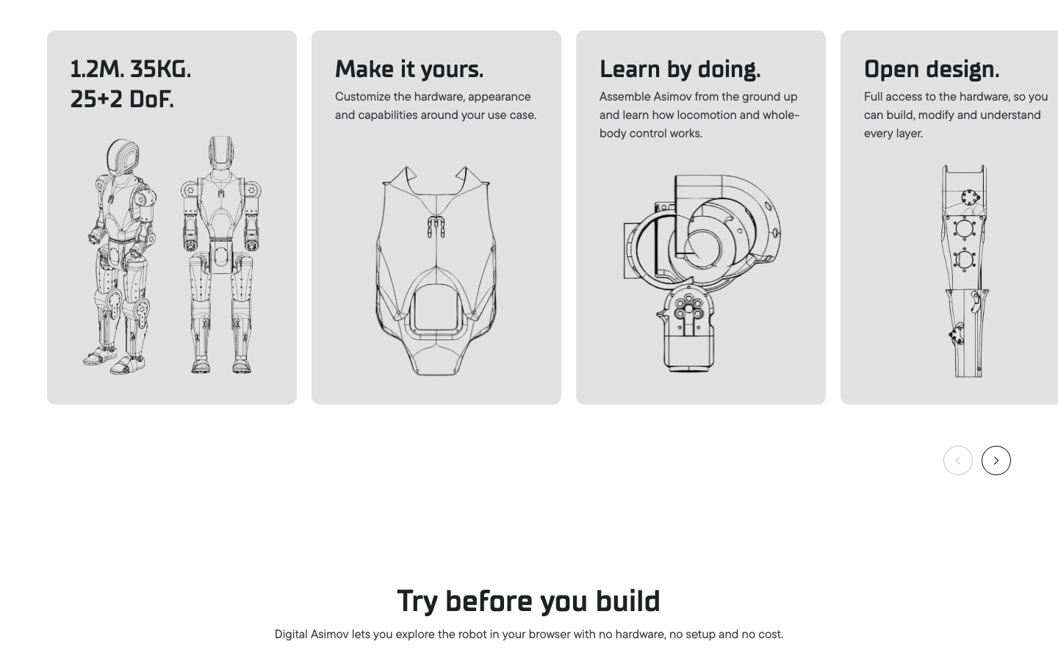
_design-inspiration/menlo-asimov-1-scroll-03.png
