offsideAI/macrodork-docs/_design-inspiration/menlo-asimov-1-scroll-05.png

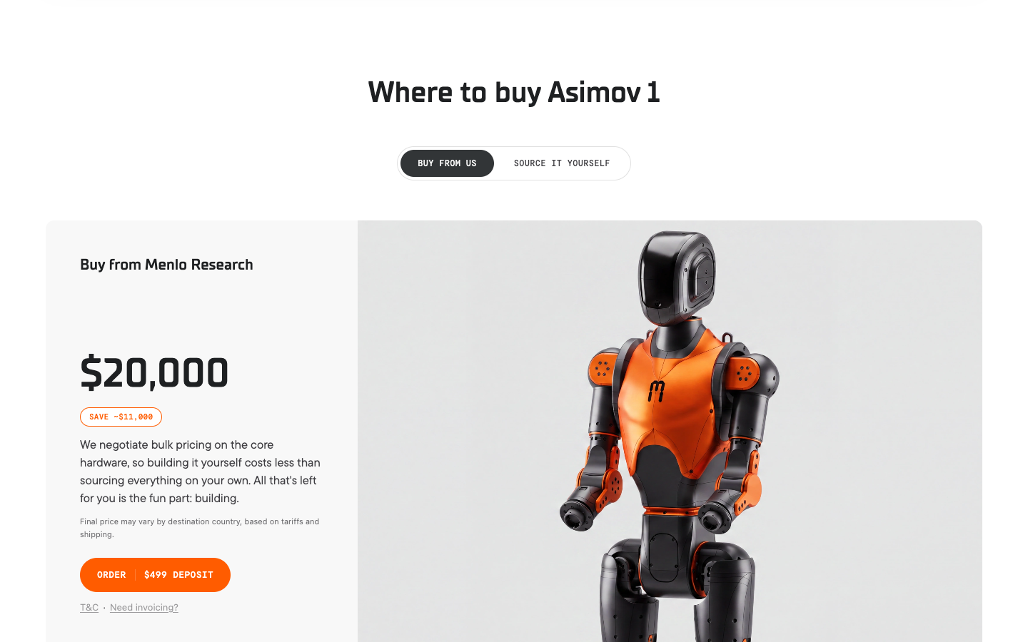
_design-inspiration/menlo-asimov-1-scroll-05.png
