offsideAI/macrodork-docs/_design-inspiration/menlo-asimov-1-scroll-07.png

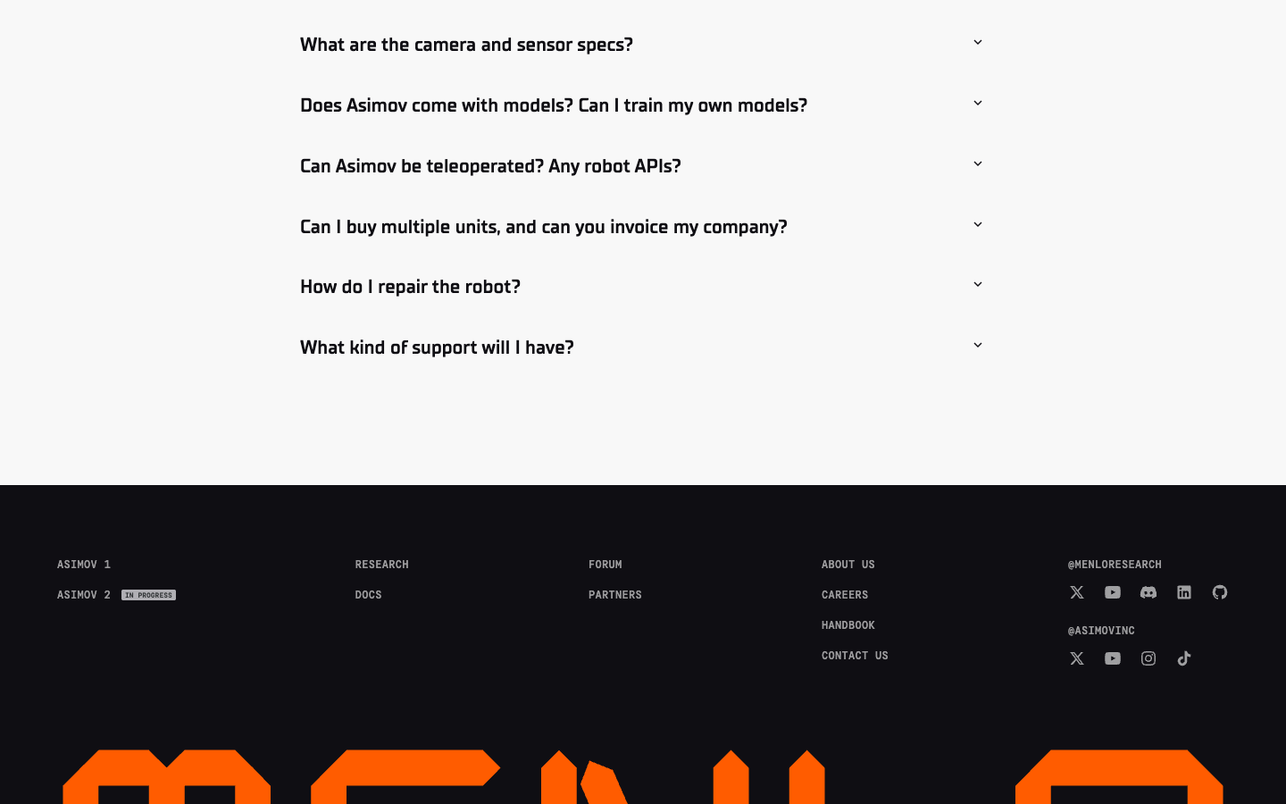
_design-inspiration/menlo-asimov-1-scroll-07.png
