offsideAI/macrodork-docs/_design-inspiration/menlo-company-desktop.png

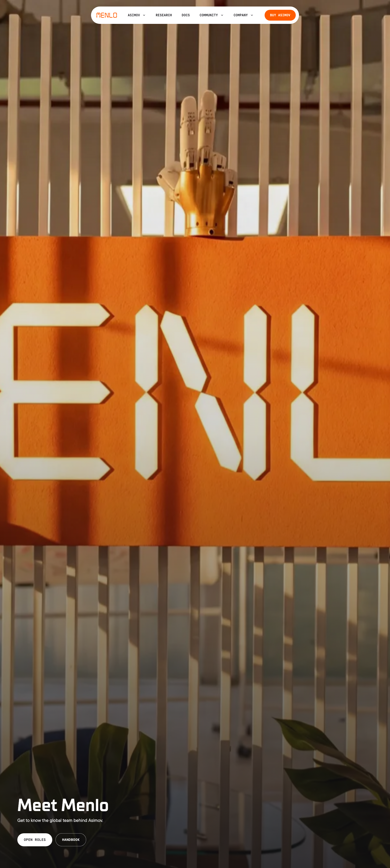
_design-inspiration/menlo-company-desktop.png
