offsideAI/macrodork-docs/_design-inspiration/menlo-docs-desktop.png

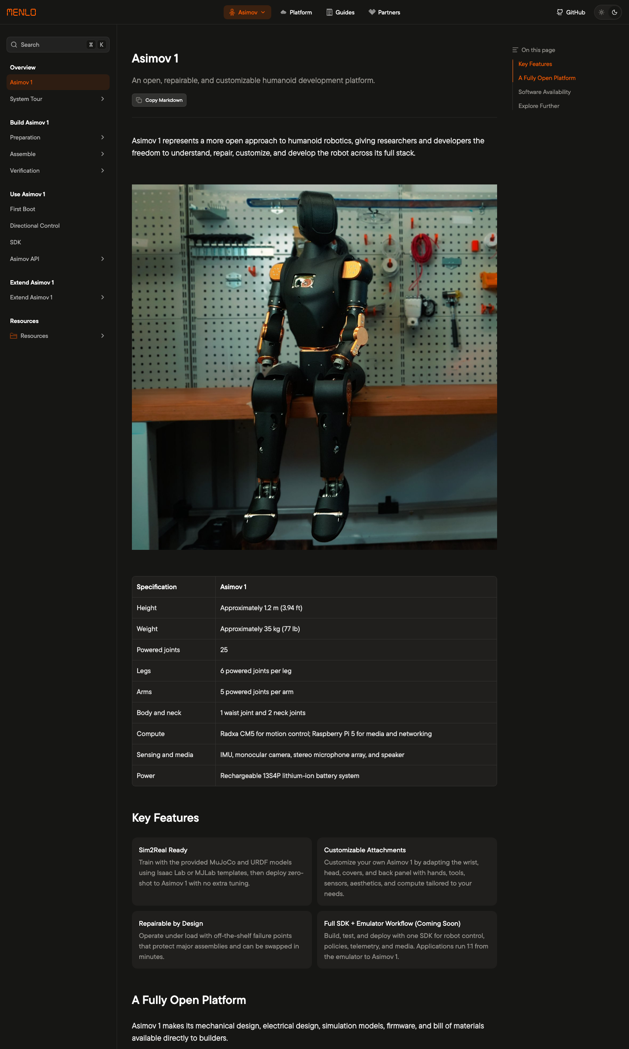
_design-inspiration/menlo-docs-desktop.png
