offsideAI/macrodork-docs/_design-inspiration/menlo-home-desktop-fold.png

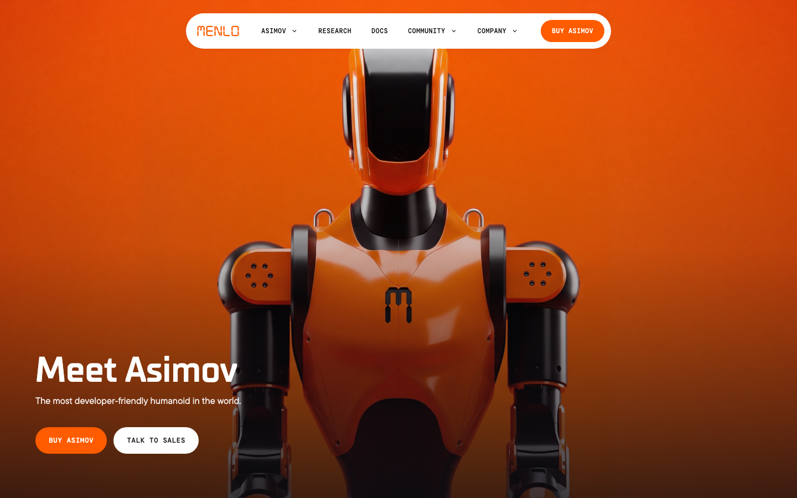
_design-inspiration/menlo-home-desktop-fold.png
