offsideAI/macrodork-docs/_design-inspiration/menlo-home-desktop.png

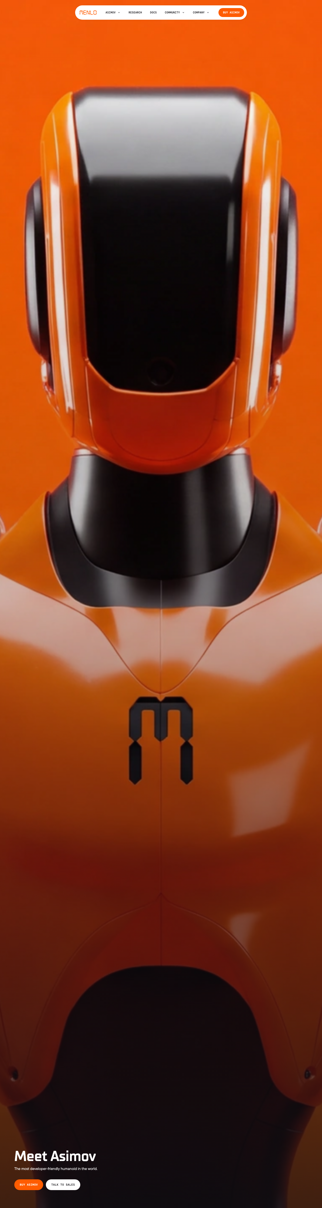
_design-inspiration/menlo-home-desktop.png
