offsideAI/macrodork-docs/_design-inspiration/menlo-home-fullpage.png

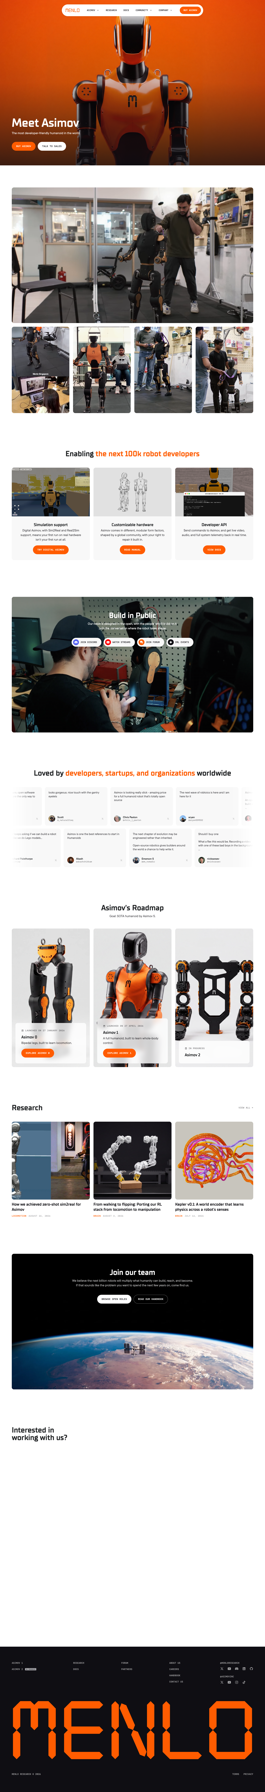
_design-inspiration/menlo-home-fullpage.png
