offsideAI/macrodork-docs/_design-inspiration/menlo-home-mobile.png

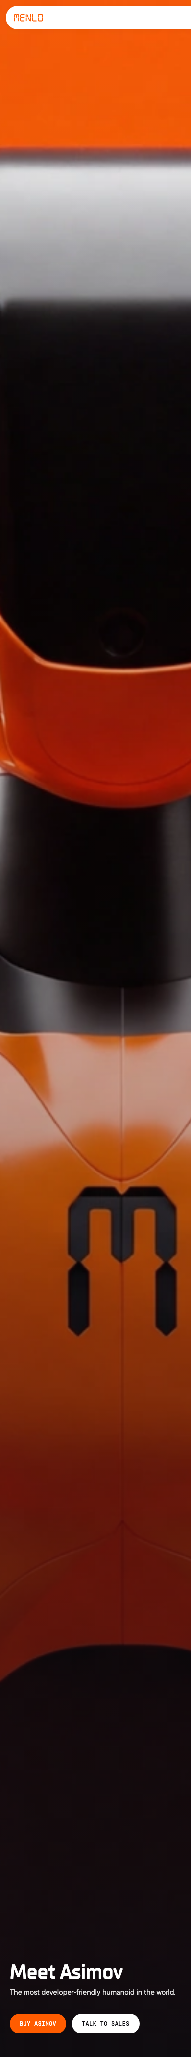
_design-inspiration/menlo-home-mobile.png
