offsideAI/macrodork-docs/_design-inspiration/menlo-home-scroll-01.png

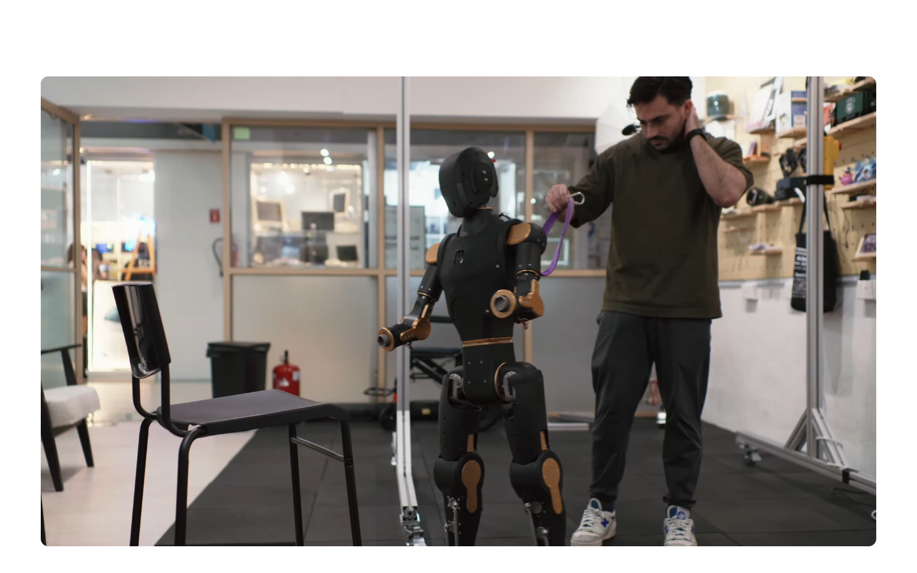
_design-inspiration/menlo-home-scroll-01.png
