offsideAI/macrodork-docs/_design-inspiration/menlo-home-scroll-02.png

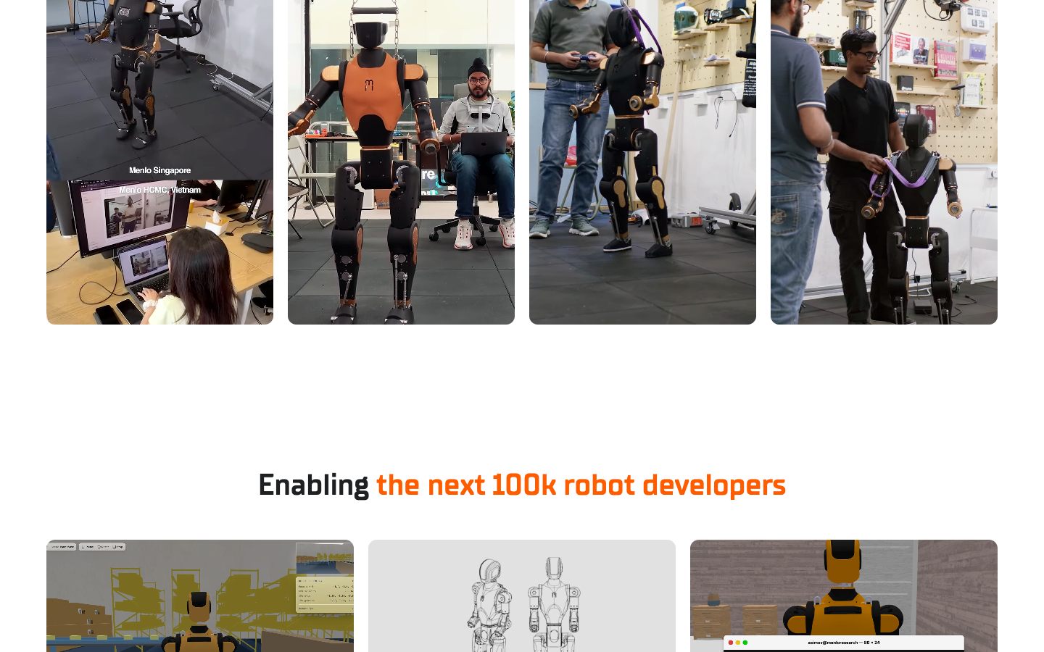
_design-inspiration/menlo-home-scroll-02.png
