offsideAI/macrodork-docs/_design-inspiration/menlo-home-scroll-03.png

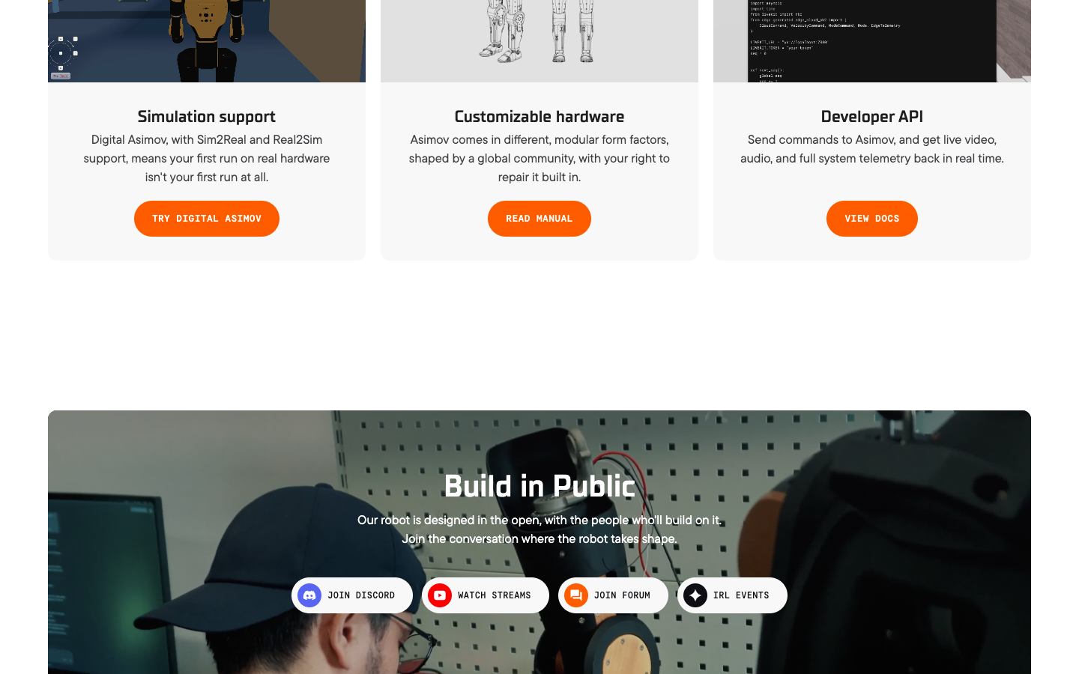
_design-inspiration/menlo-home-scroll-03.png
