offsideAI/macrodork-docs/_design-inspiration/menlo-home-scroll-04.png

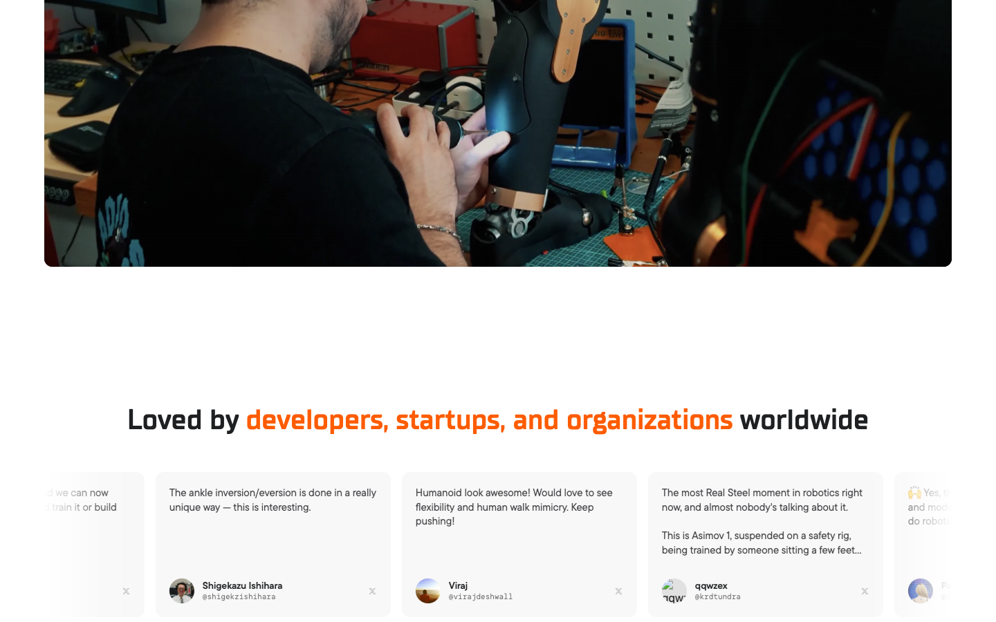
_design-inspiration/menlo-home-scroll-04.png
