offsideAI/macrodork-docs/_design-inspiration/menlo-home-scroll-05.png

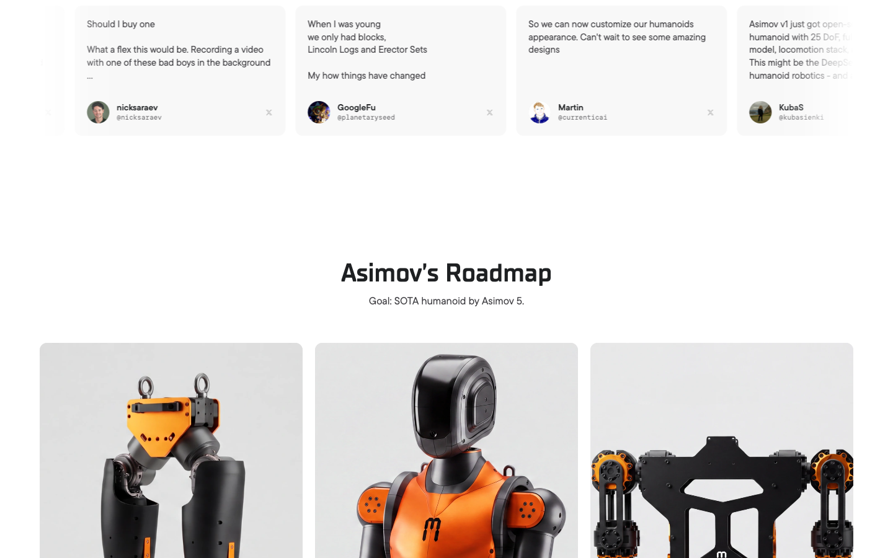
_design-inspiration/menlo-home-scroll-05.png
