offsideAI/macrodork-docs/_design-inspiration/menlo-home-scroll-06.png

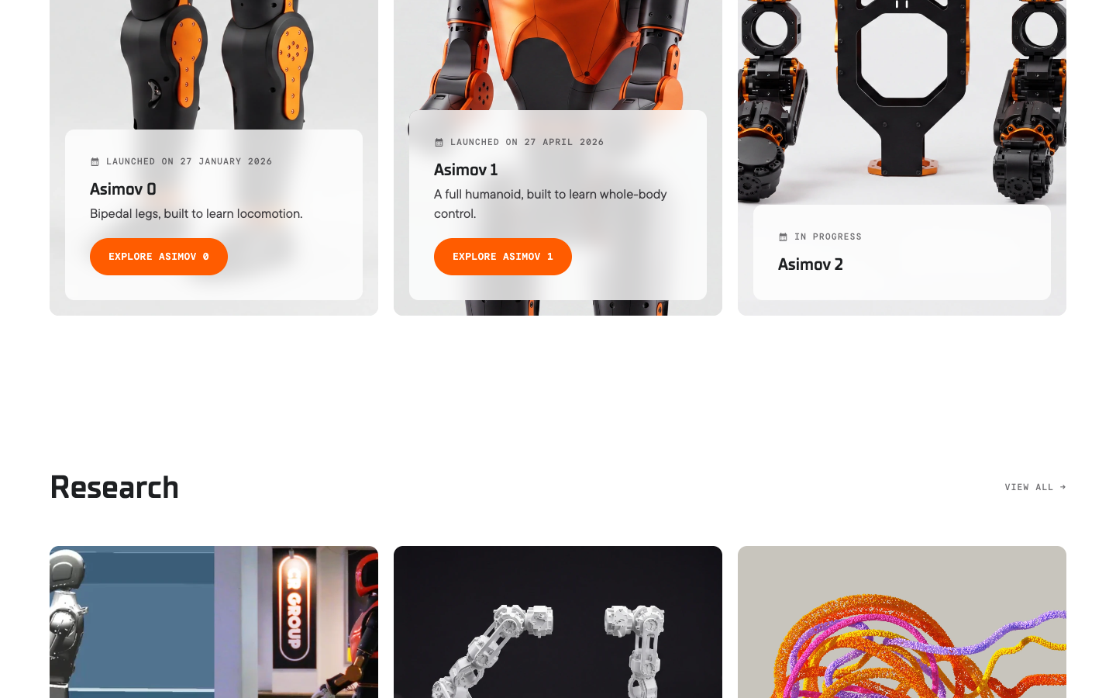
_design-inspiration/menlo-home-scroll-06.png
