offsideAI/macrodork-docs/_design-inspiration/menlo-home-scroll-07.png

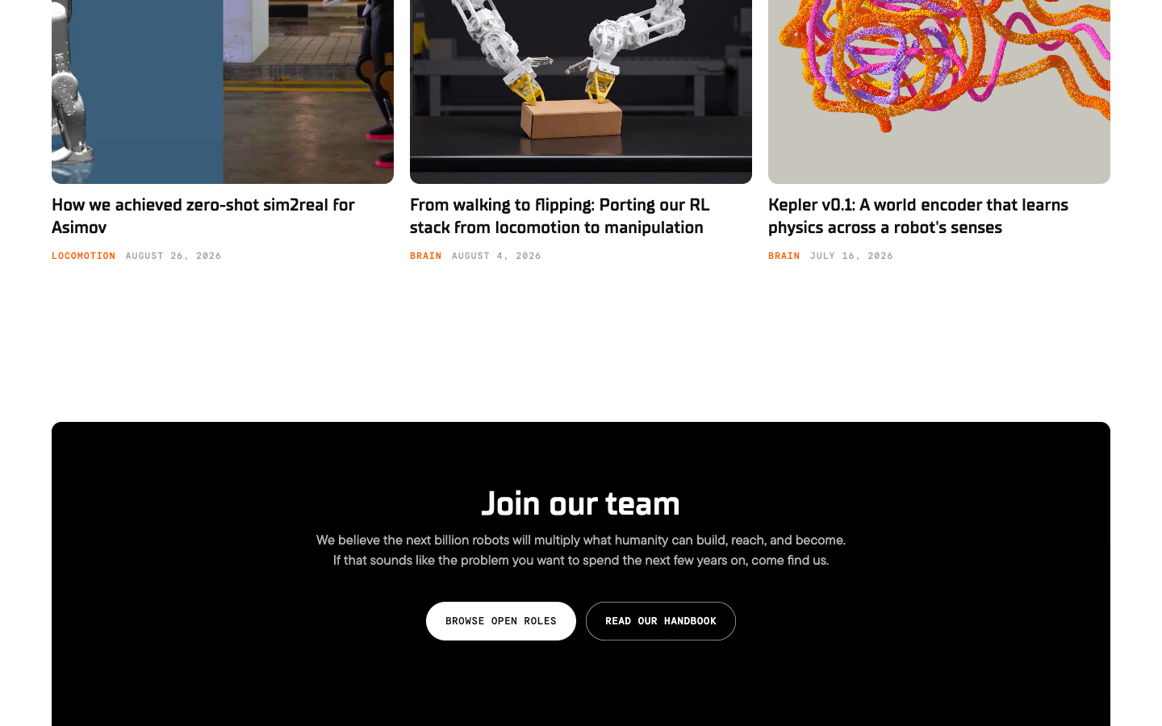
_design-inspiration/menlo-home-scroll-07.png
