offsideAI/macrodork-docs/_design-inspiration/menlo-home-scroll-08.png

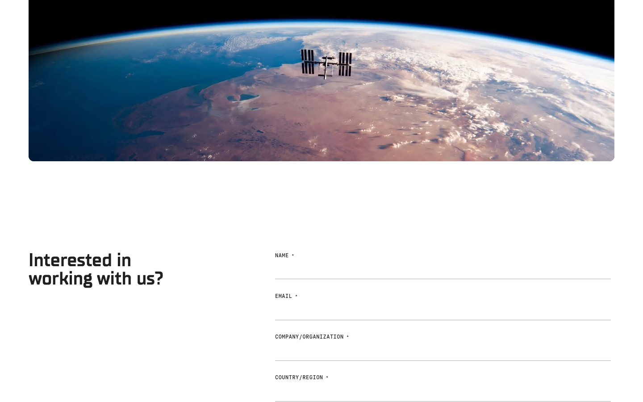
_design-inspiration/menlo-home-scroll-08.png
