offsideAI/macrodork-docs/_design-inspiration/menlo-home-scroll-09.png

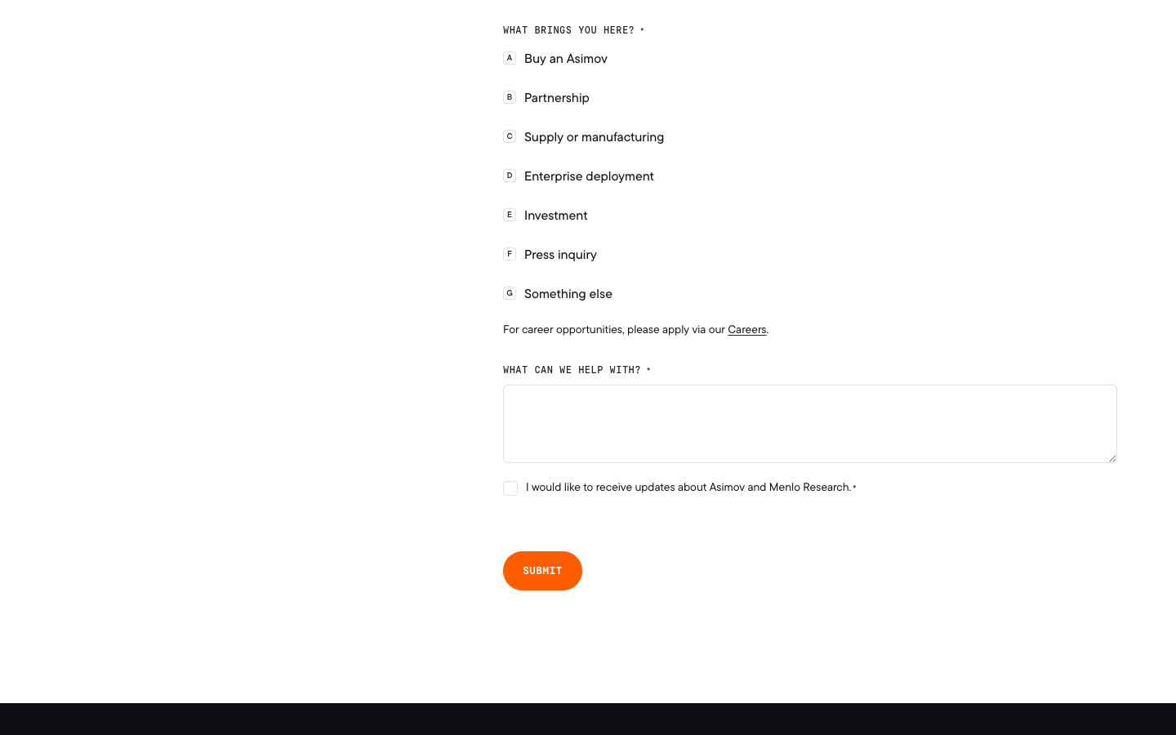
_design-inspiration/menlo-home-scroll-09.png
