offsideAI/macrodork-docs/_design-inspiration/menlo-research-desktop.png

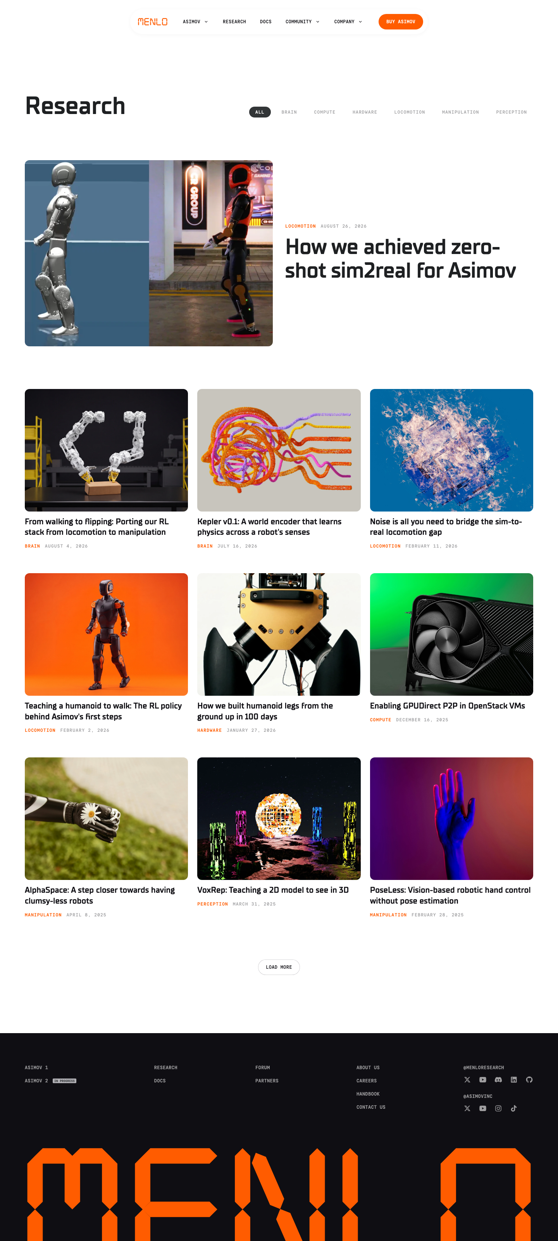
_design-inspiration/menlo-research-desktop.png
