offsideAI/macrodork-docs/Mark-I-Build/renders/mark-i-r001-head-concepts.png

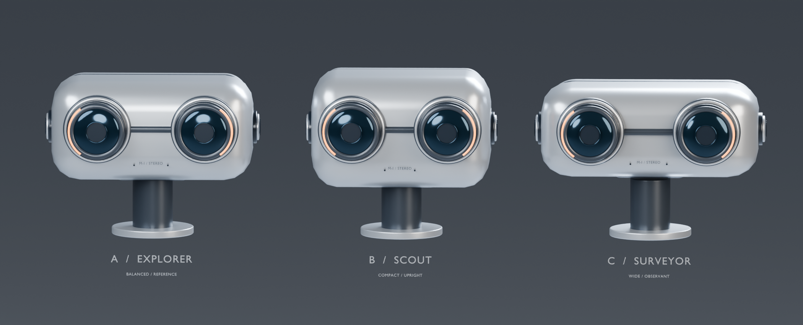
Mark-I-Build/renders/mark-i-r001-head-concepts.png
