offsideAI/macrodork-docs/Mark-I-Build/specification-mocks/mock_1.png

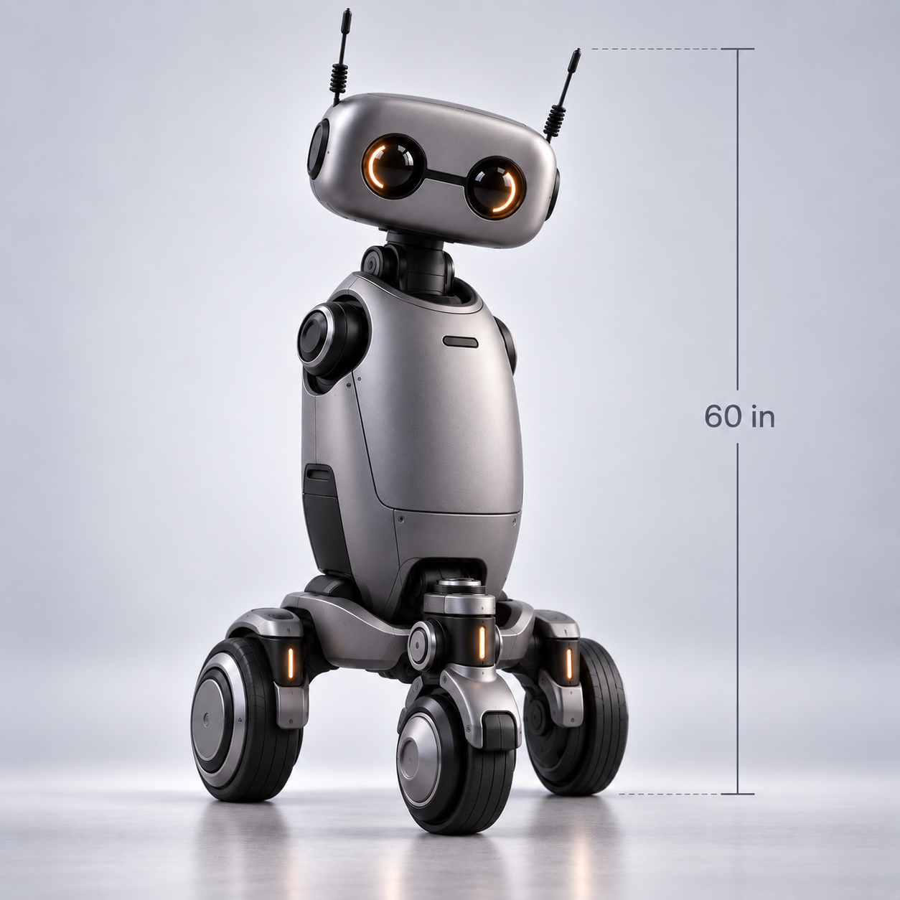
Mark-I-Build/specification-mocks/mock_1.png
