offsideAI/macrodork-docs/Mark-I-Build/specification/spec_1.png

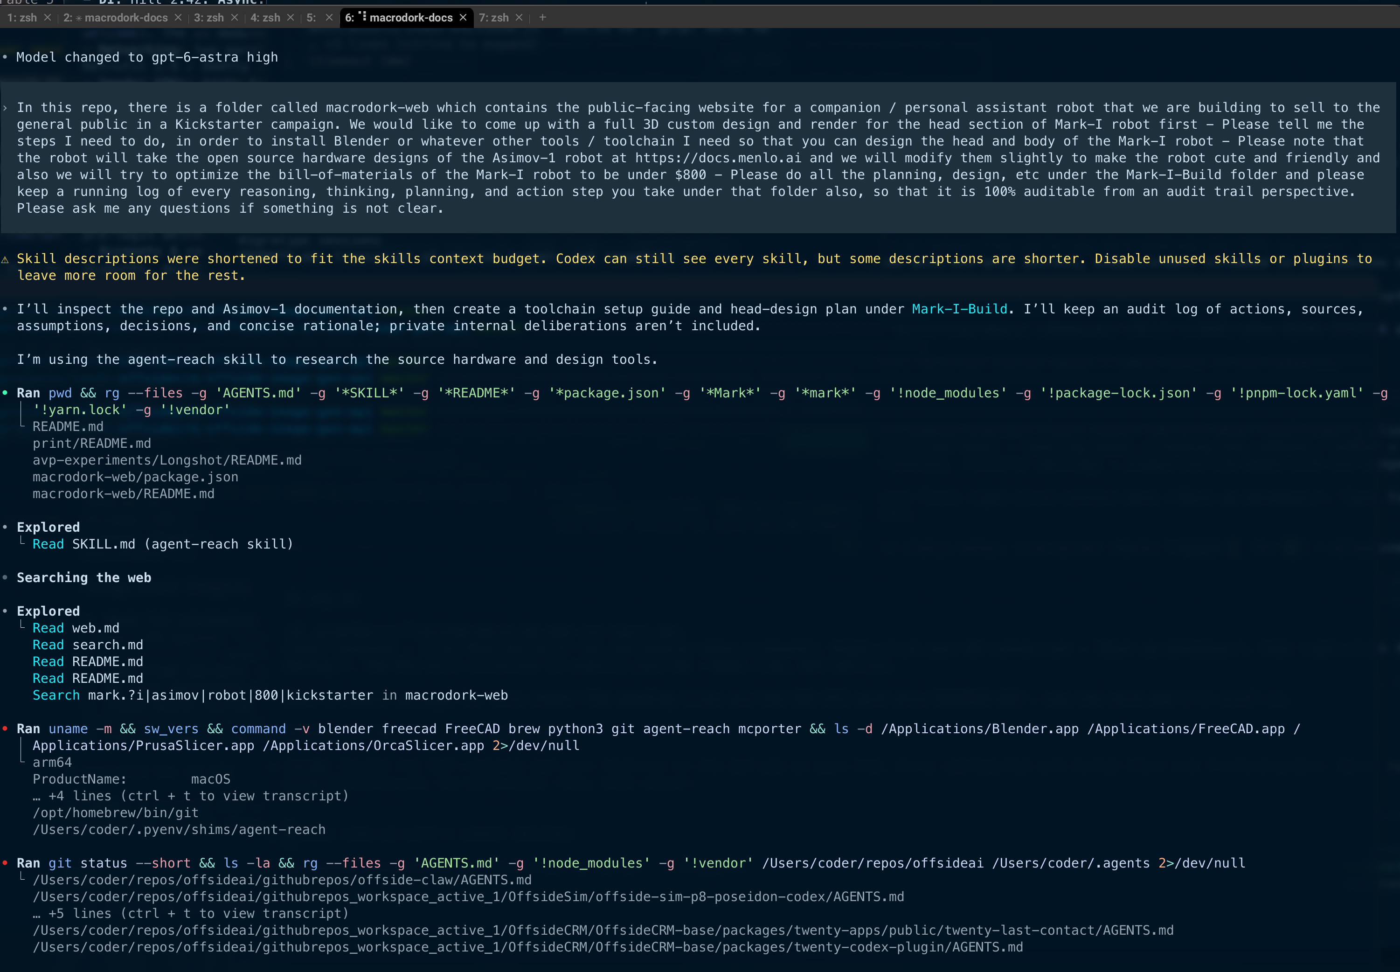
Mark-I-Build/specification/spec_1.png
