offsideAI/macrodork-docs/Mark-I-Build/specification/spec_2.png

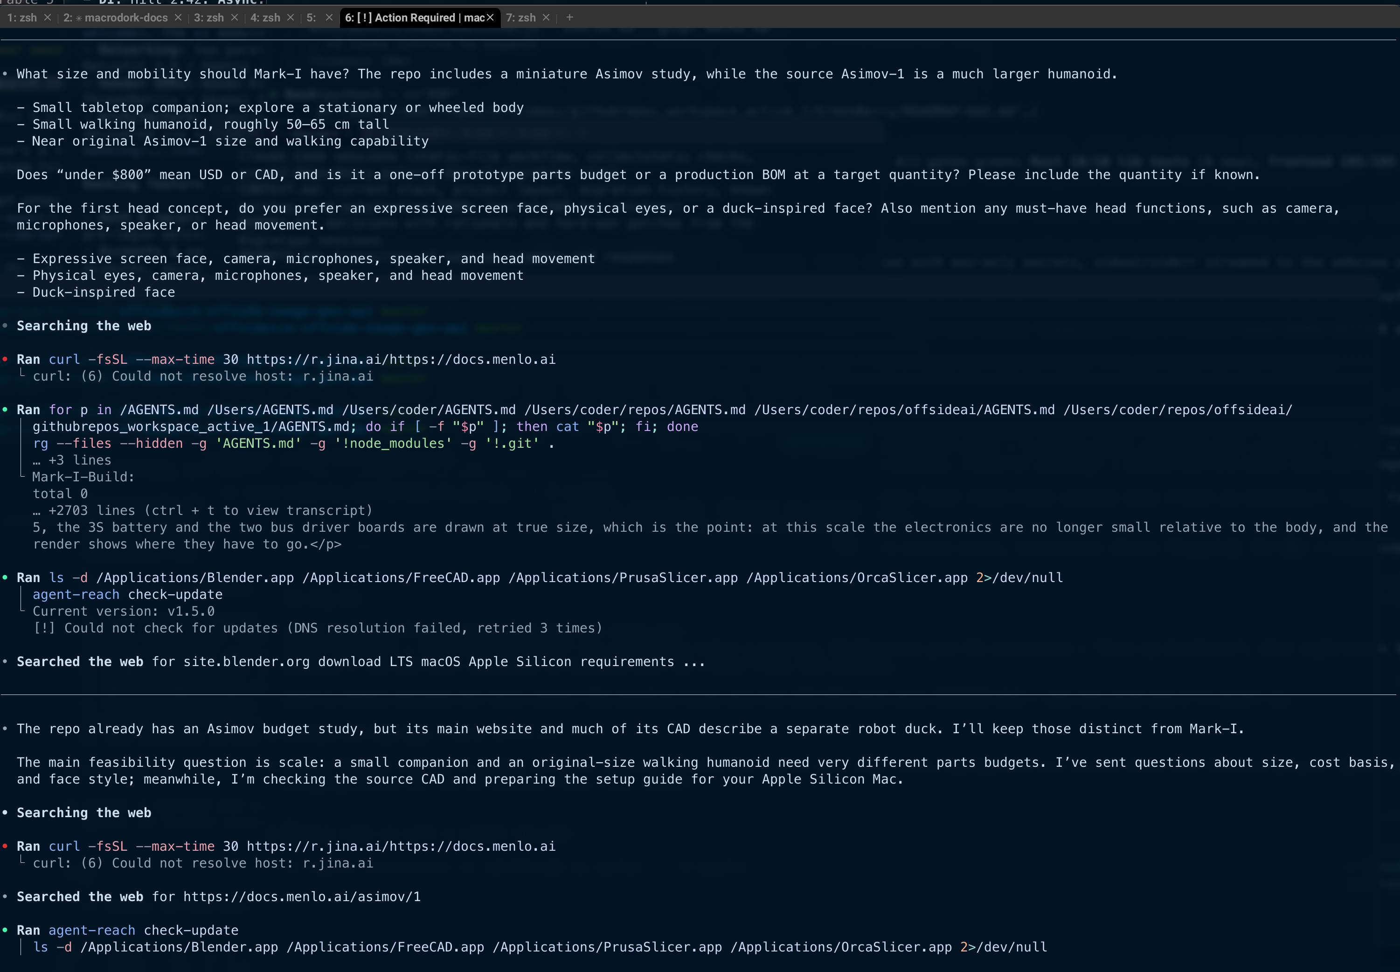
Mark-I-Build/specification/spec_2.png
