offsideAI/macrodork-docs/Mark-I-Build/specification/spec_3.png

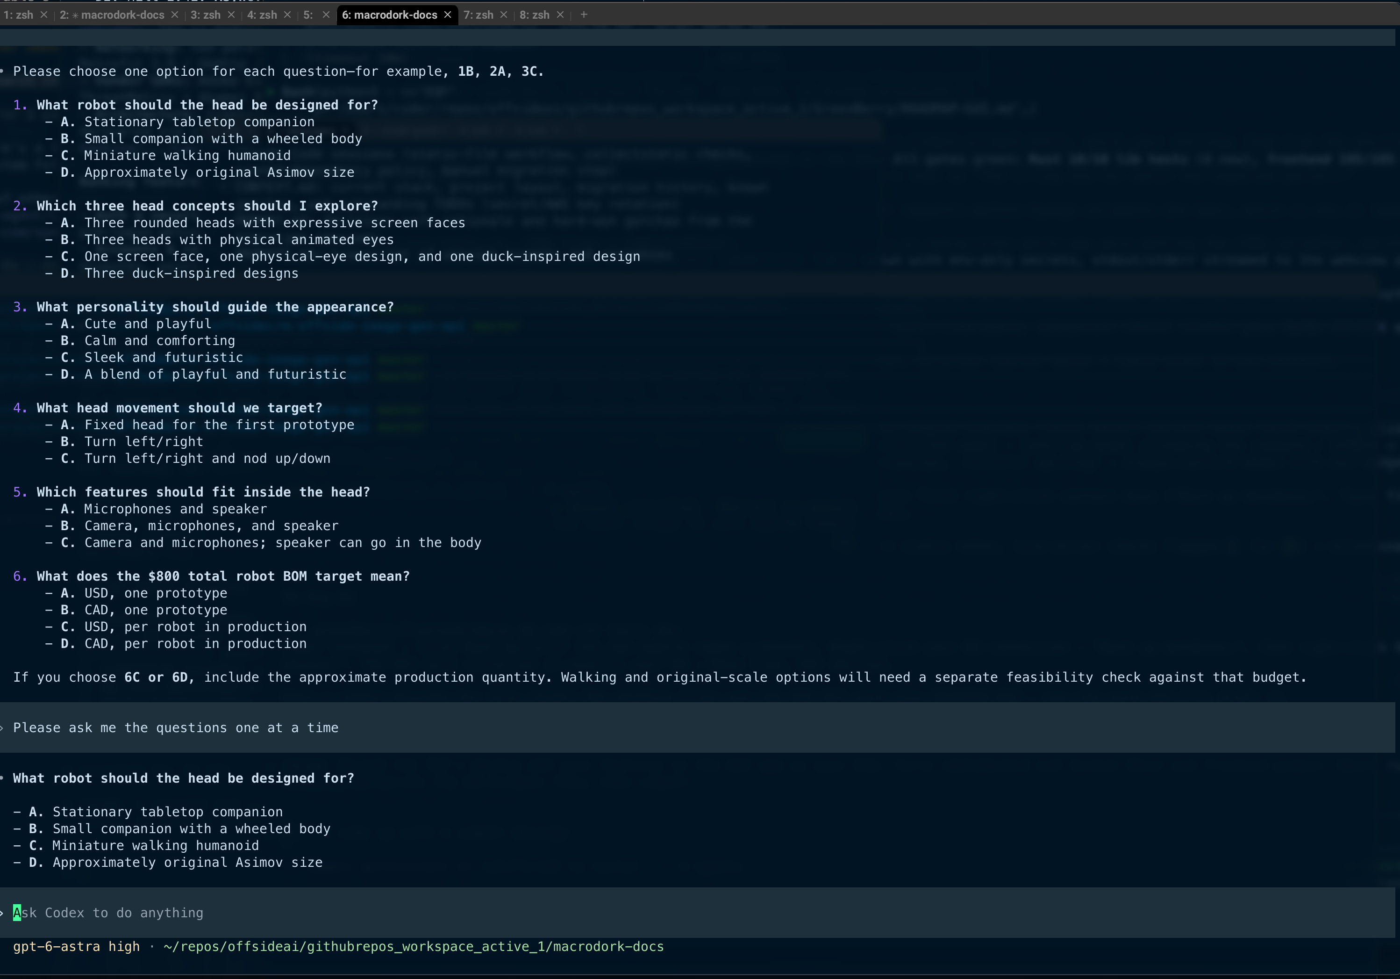
Mark-I-Build/specification/spec_3.png
