offsideAI/macrodork-docs/Mark-I-Build/specification/spec_4.png

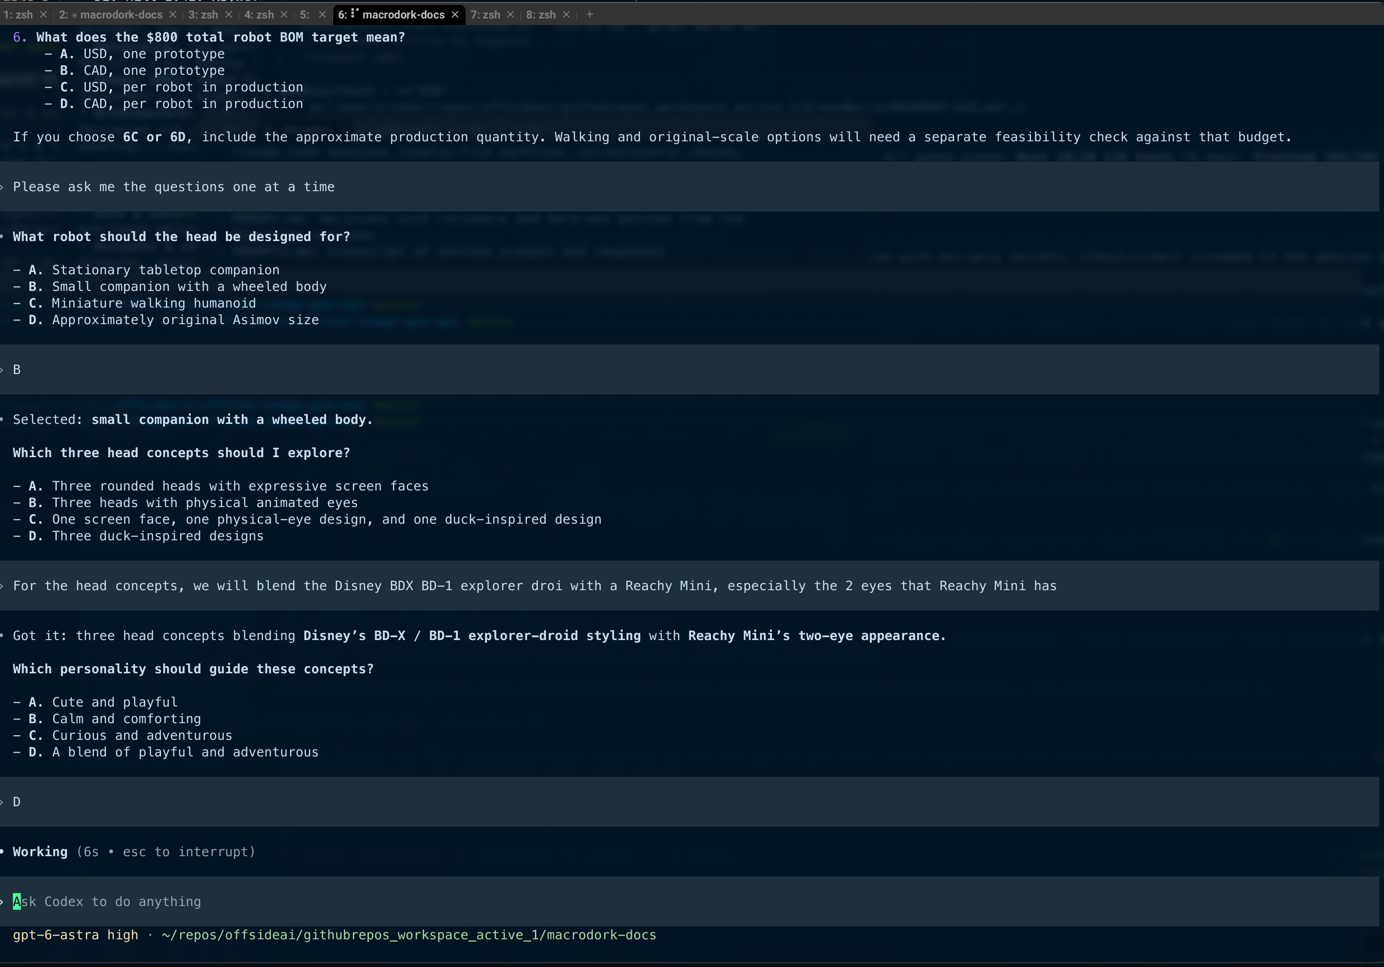
Mark-I-Build/specification/spec_4.png
