offsideAI/macrodork-docs/Mark-I-Build/specification/spec_5.png

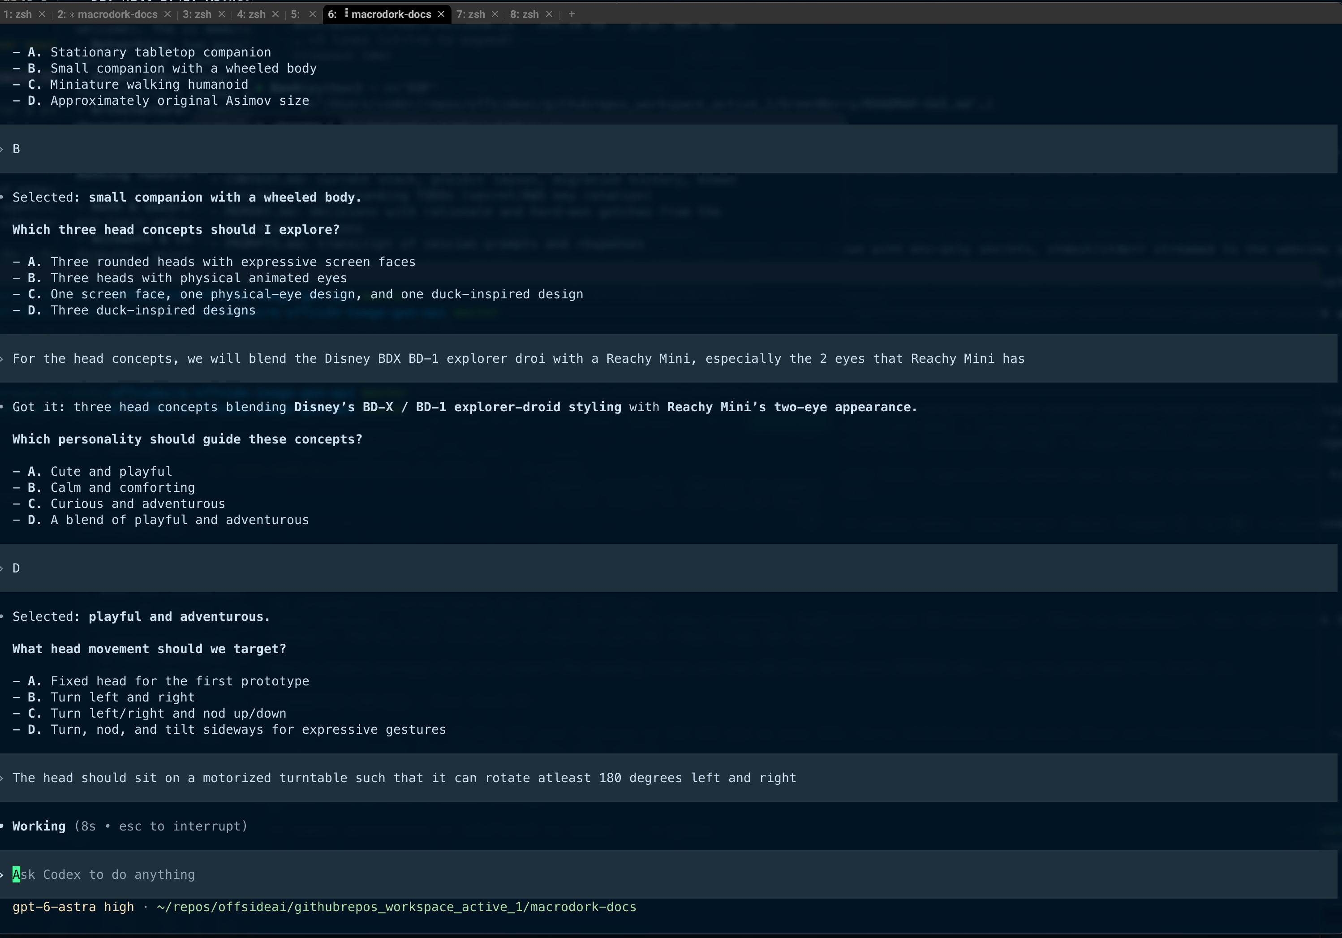
Mark-I-Build/specification/spec_5.png
