offsideAI/macrodork-docs/Mark-I-Build/specification/spec_6.png

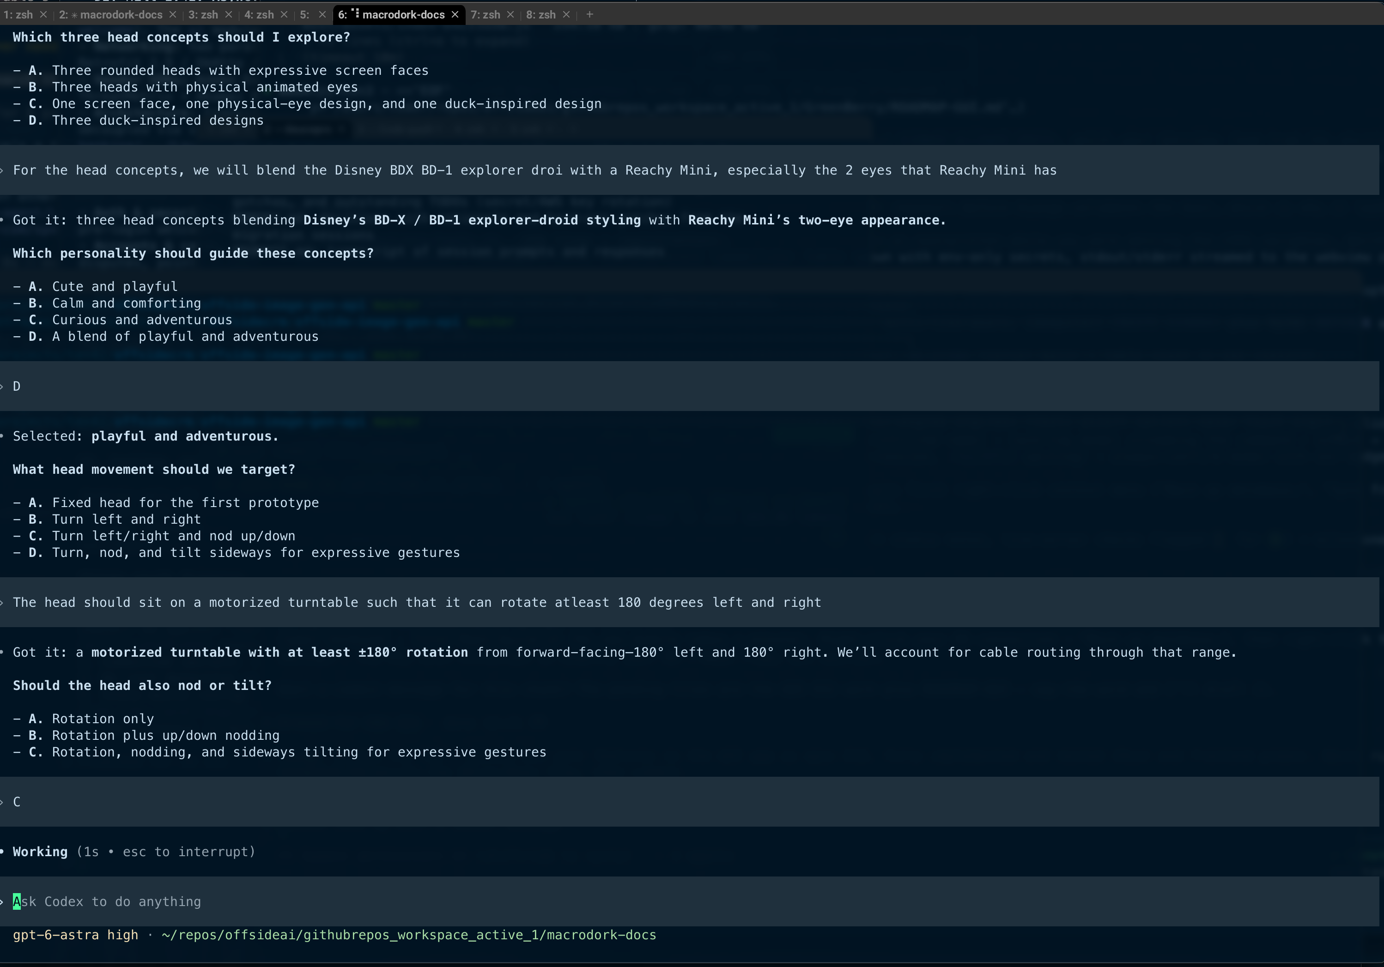
Mark-I-Build/specification/spec_6.png
