offsideAI/macrodork-docs/Mark-I-Build/specification/spec_7.png

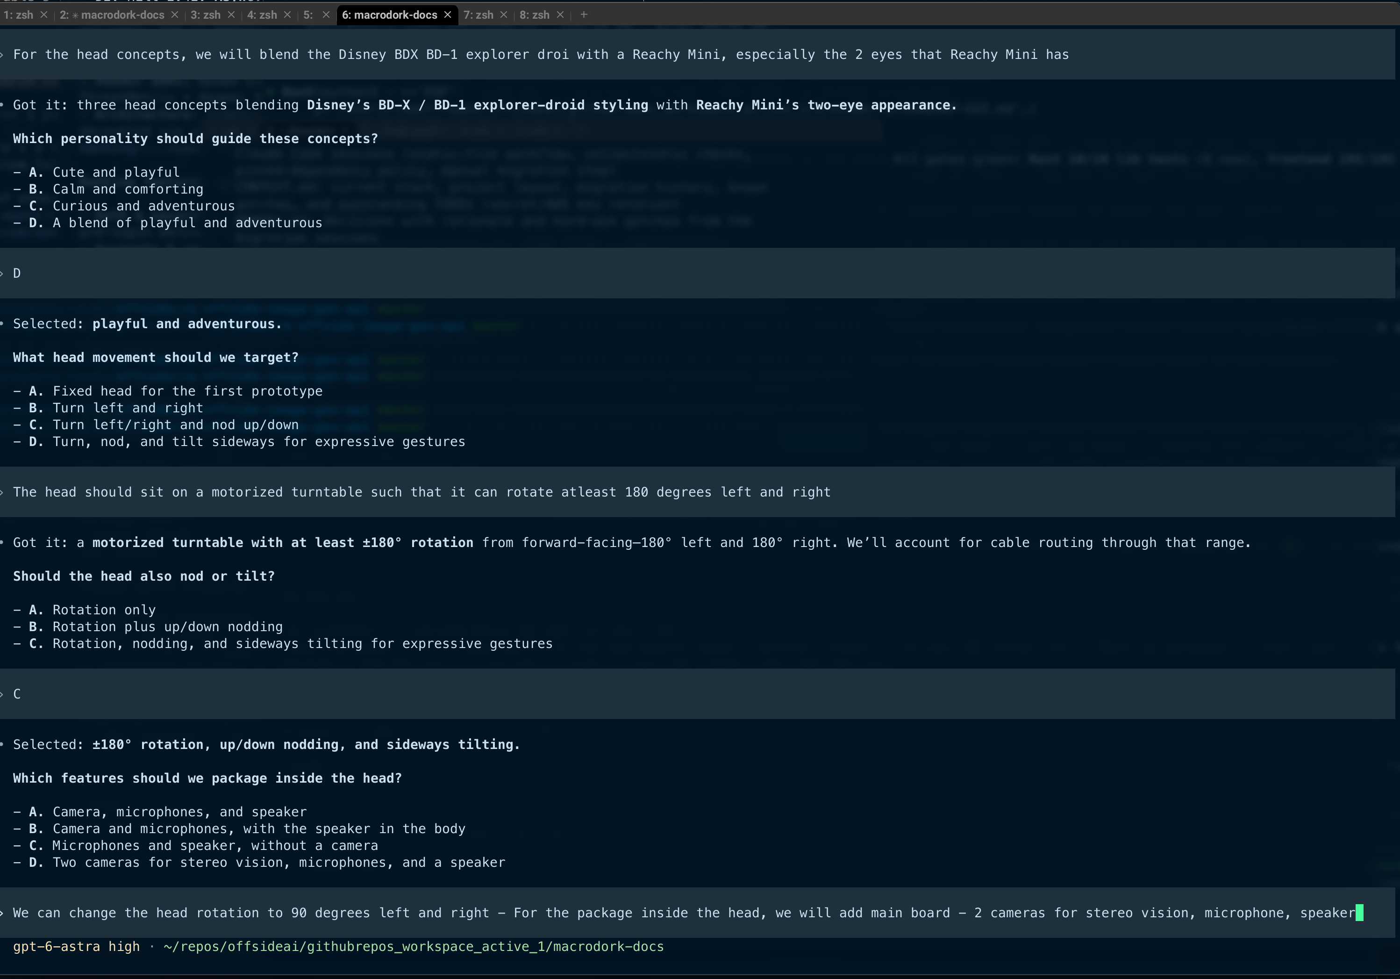
Mark-I-Build/specification/spec_7.png
