offsideAI/macrodork-docs/Mark-I-Build/specification/spec_8.png

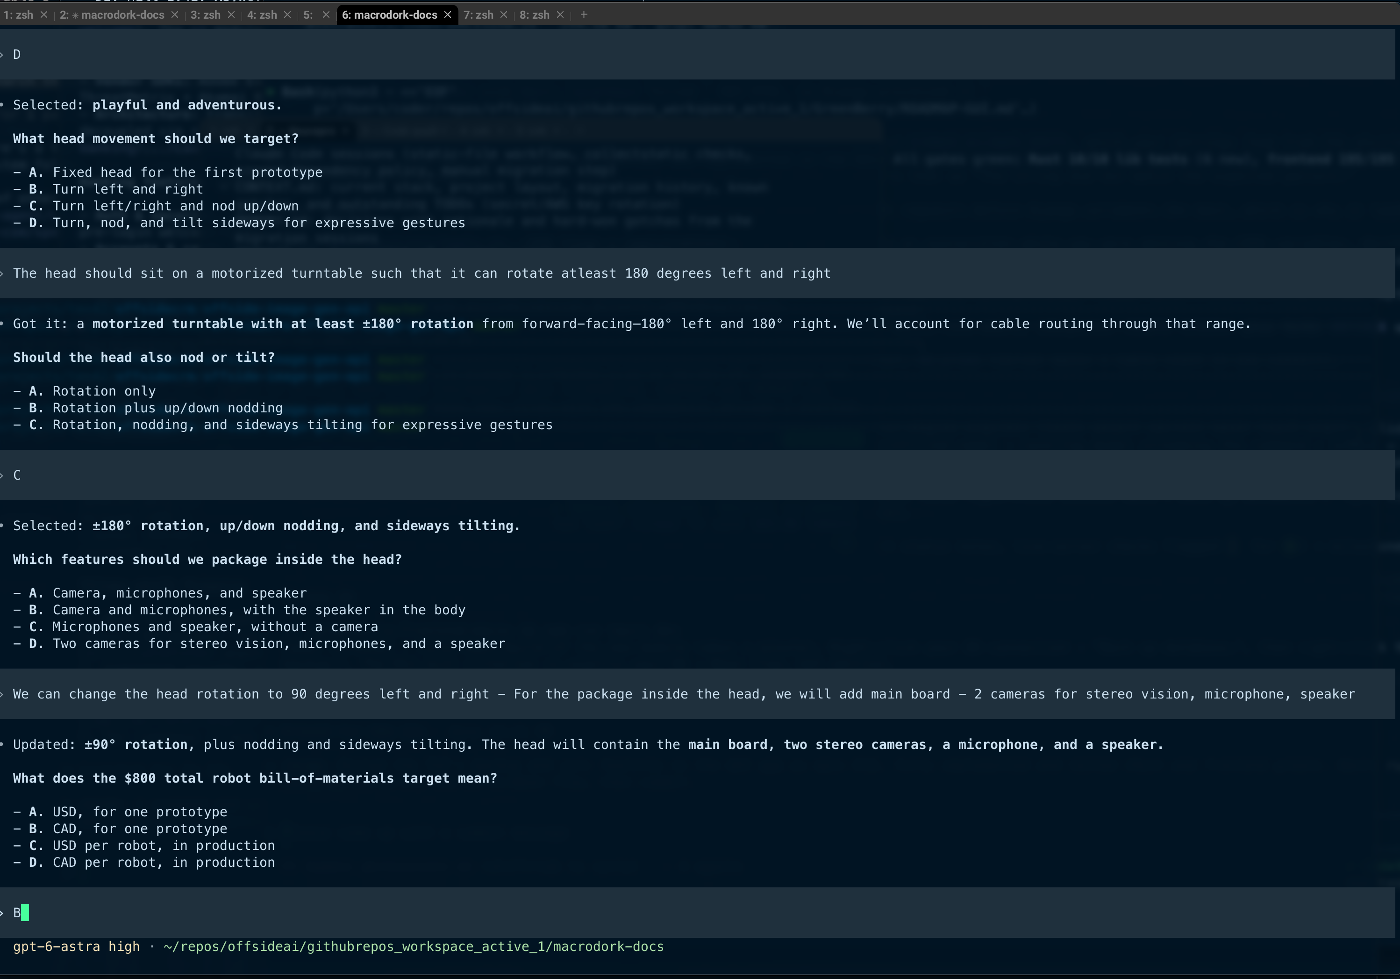
Mark-I-Build/specification/spec_8.png
