offsideAI/macrodork-docs/Mark-I-Build/specification/spec_9.png

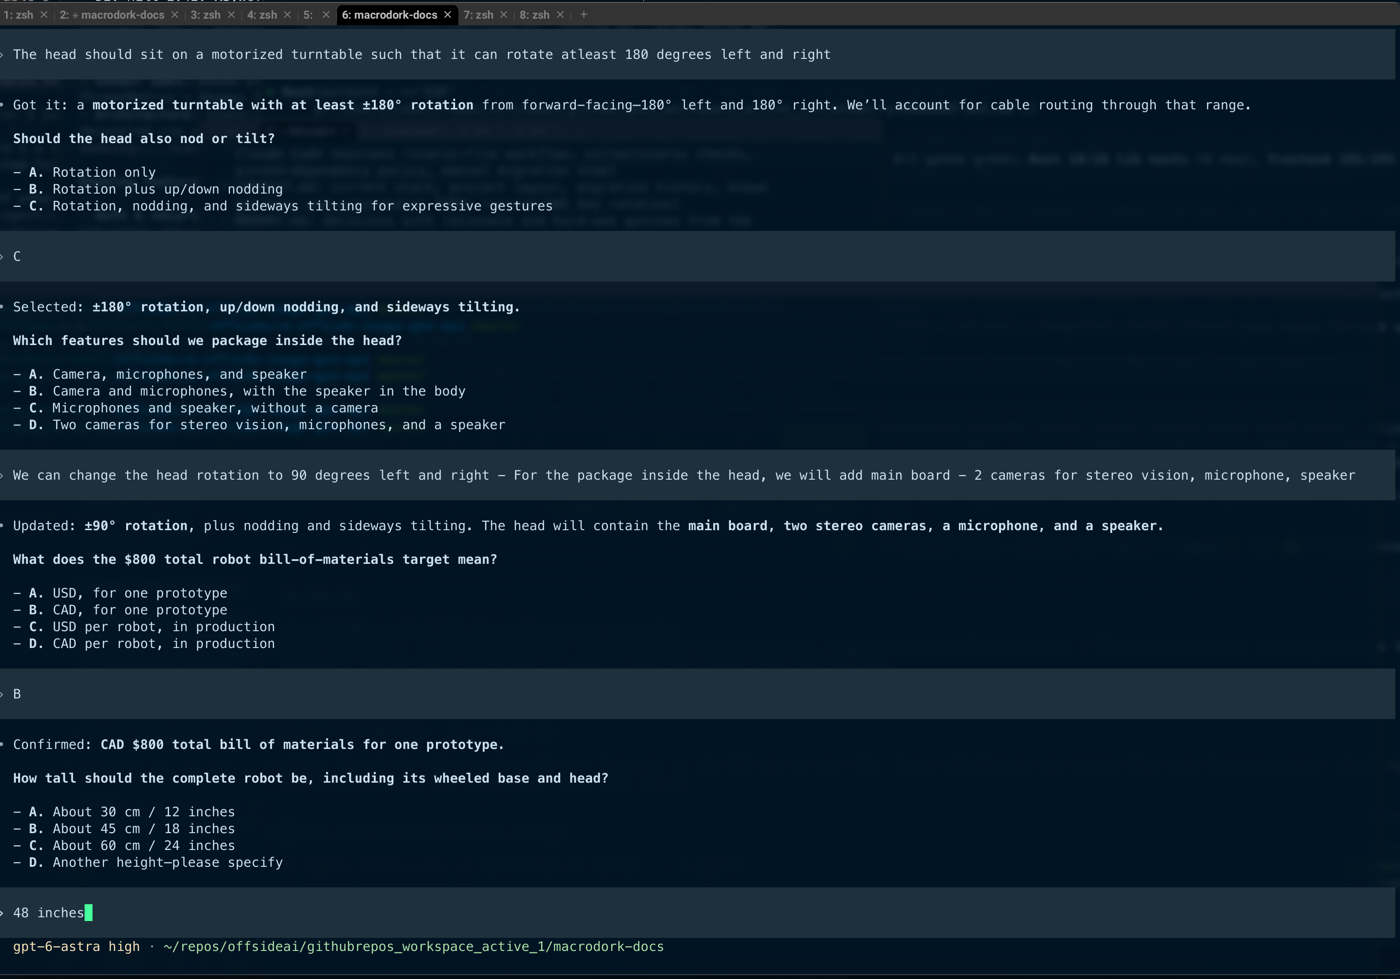
Mark-I-Build/specification/spec_9.png
