offsideAI/macrodork-docs/Mark-I-Build/specification/spec_10.png

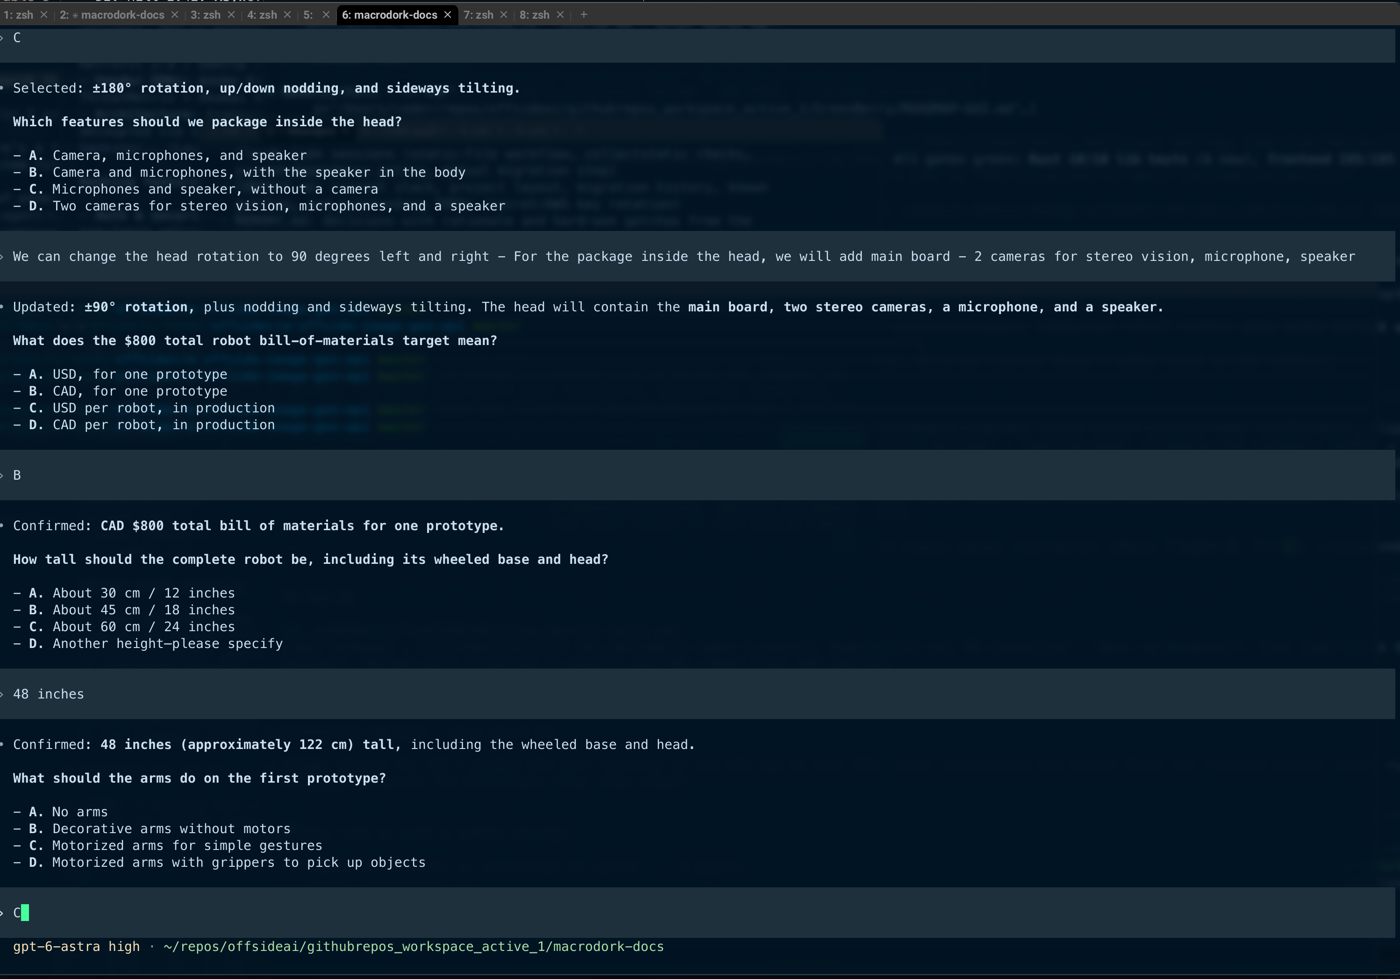
Mark-I-Build/specification/spec_10.png
