offsideAI/macrodork-docs/Mark-I-Build/specification/spec_11.png

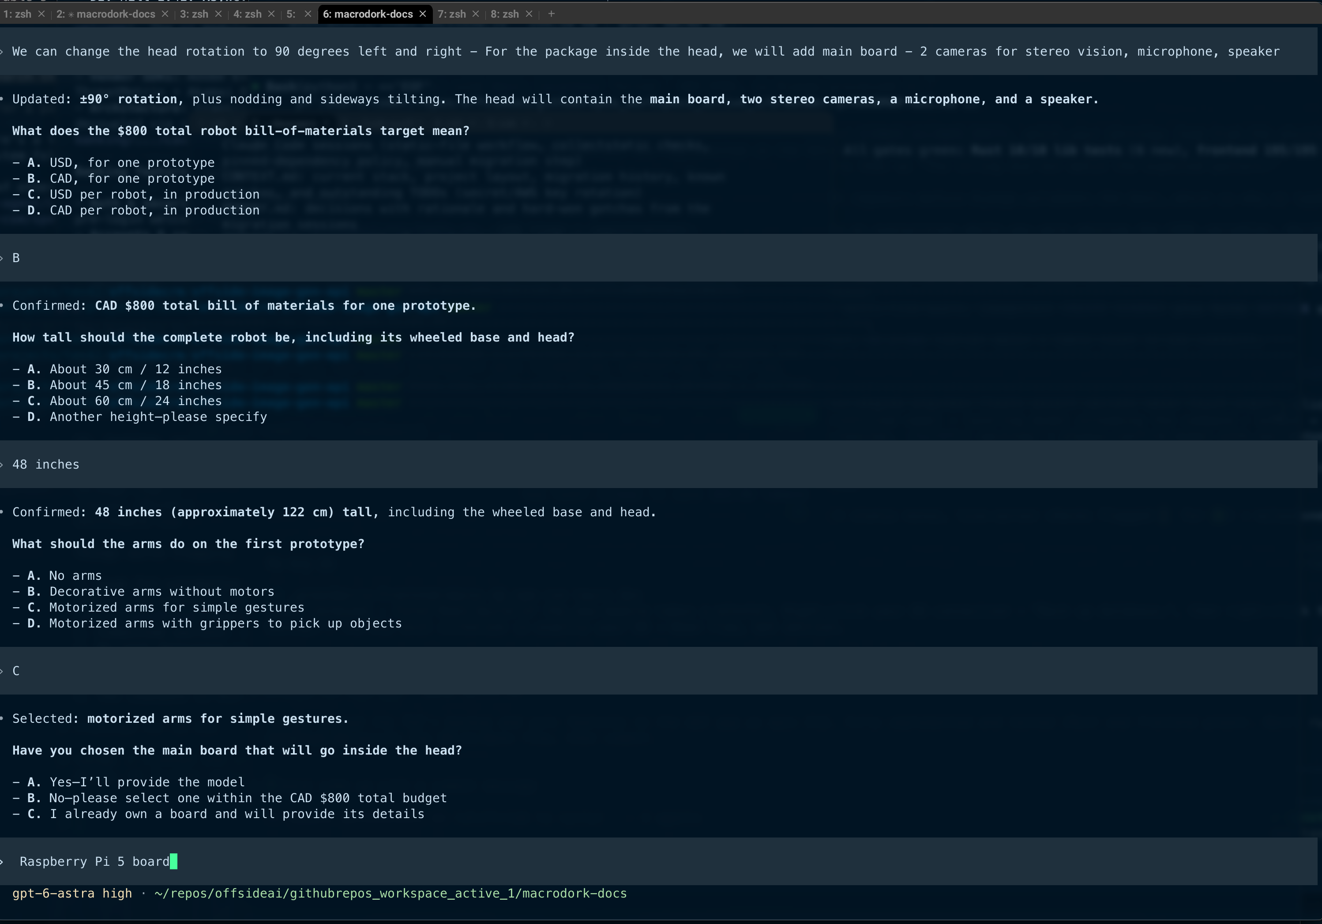
Mark-I-Build/specification/spec_11.png
