offsideAI/macrodork-docs/Mark-I-Build/specification/spec_12.png

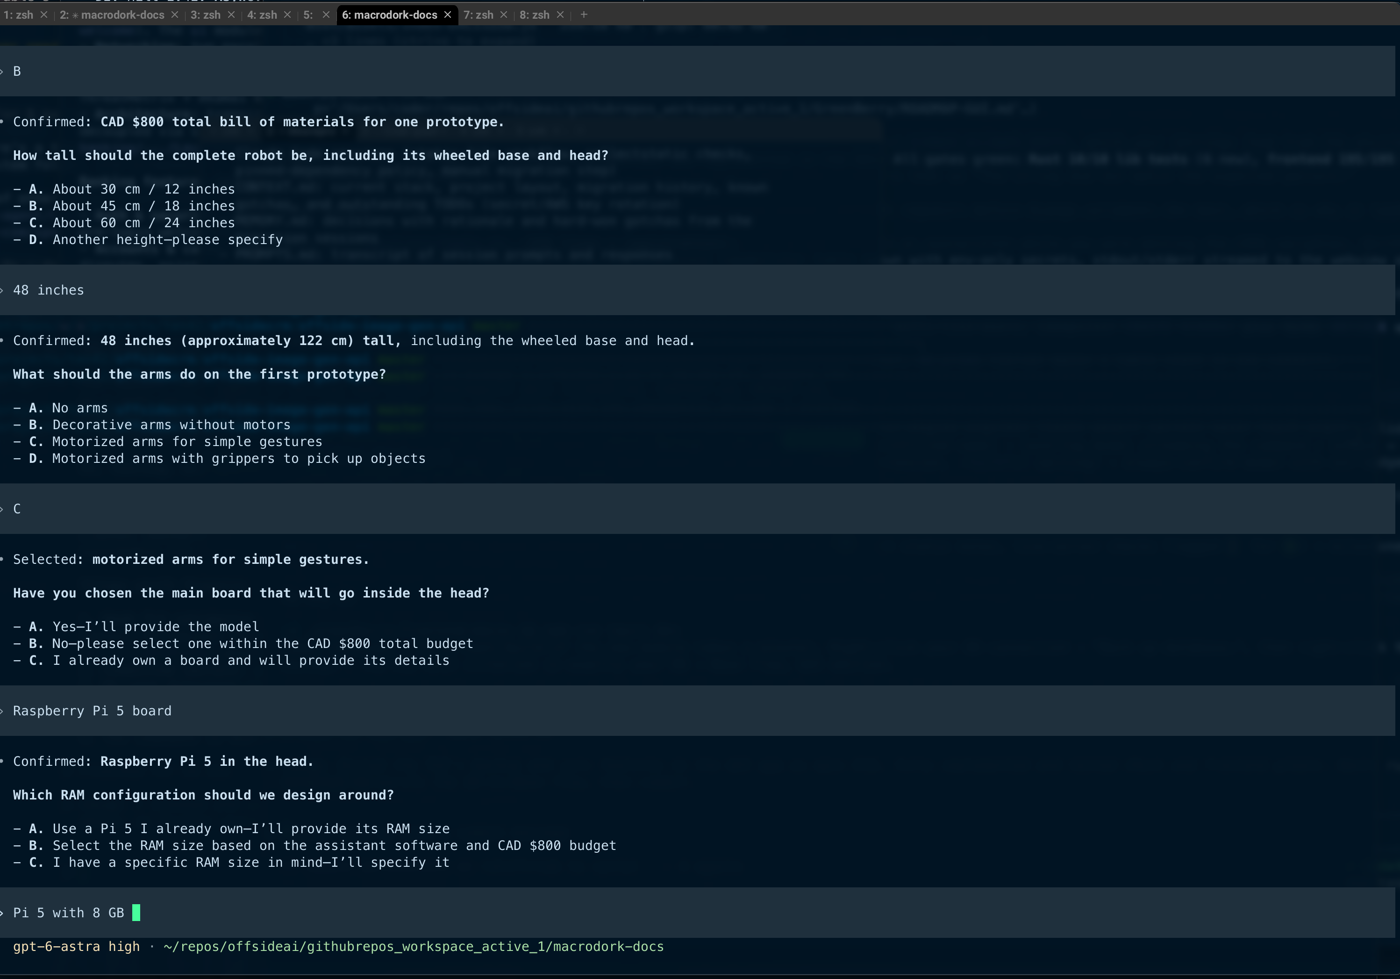
Mark-I-Build/specification/spec_12.png
