offsideAI/macrodork-docs/Mark-I-Build/specification/spec_13.png

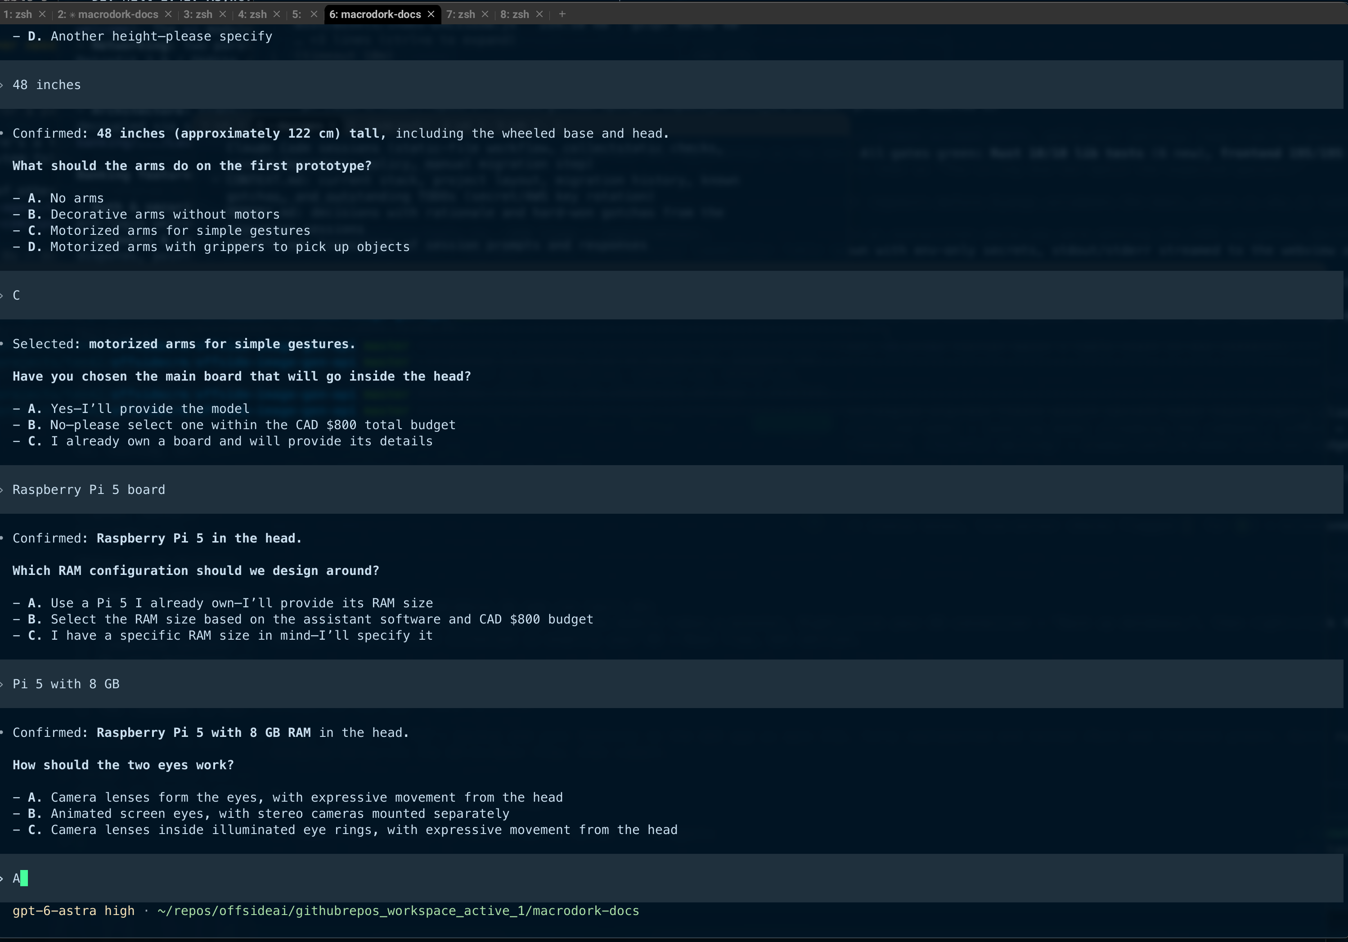
Mark-I-Build/specification/spec_13.png
