offsideAI/macrodork-docs/Mark-I-Build/specification/spec_14.png

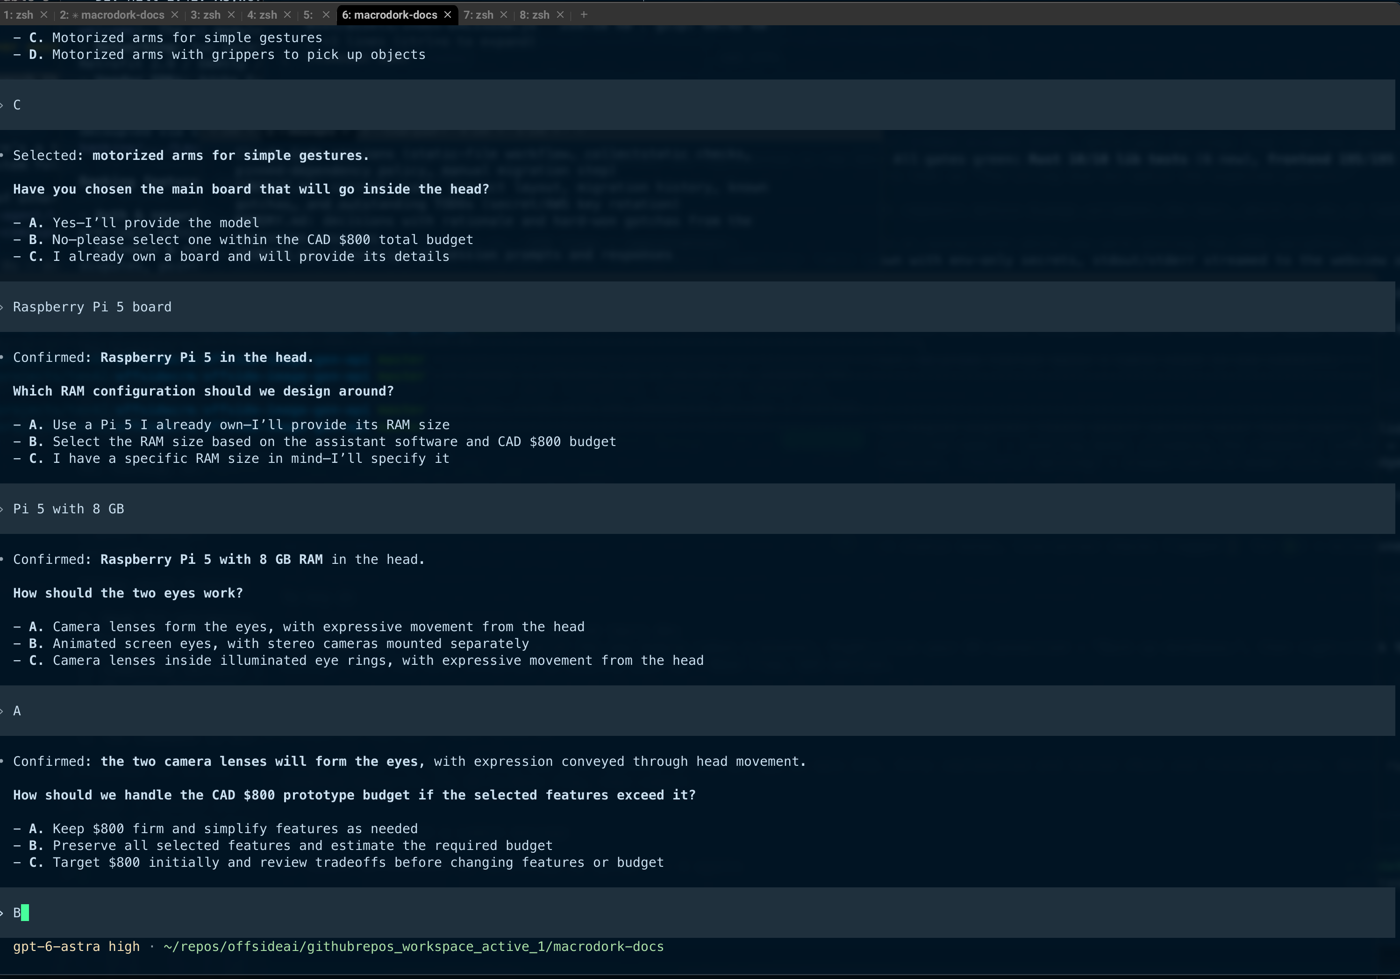
Mark-I-Build/specification/spec_14.png
