offsideAI/macrodork-docs/Mark-I-Build/specification/spec_16.png

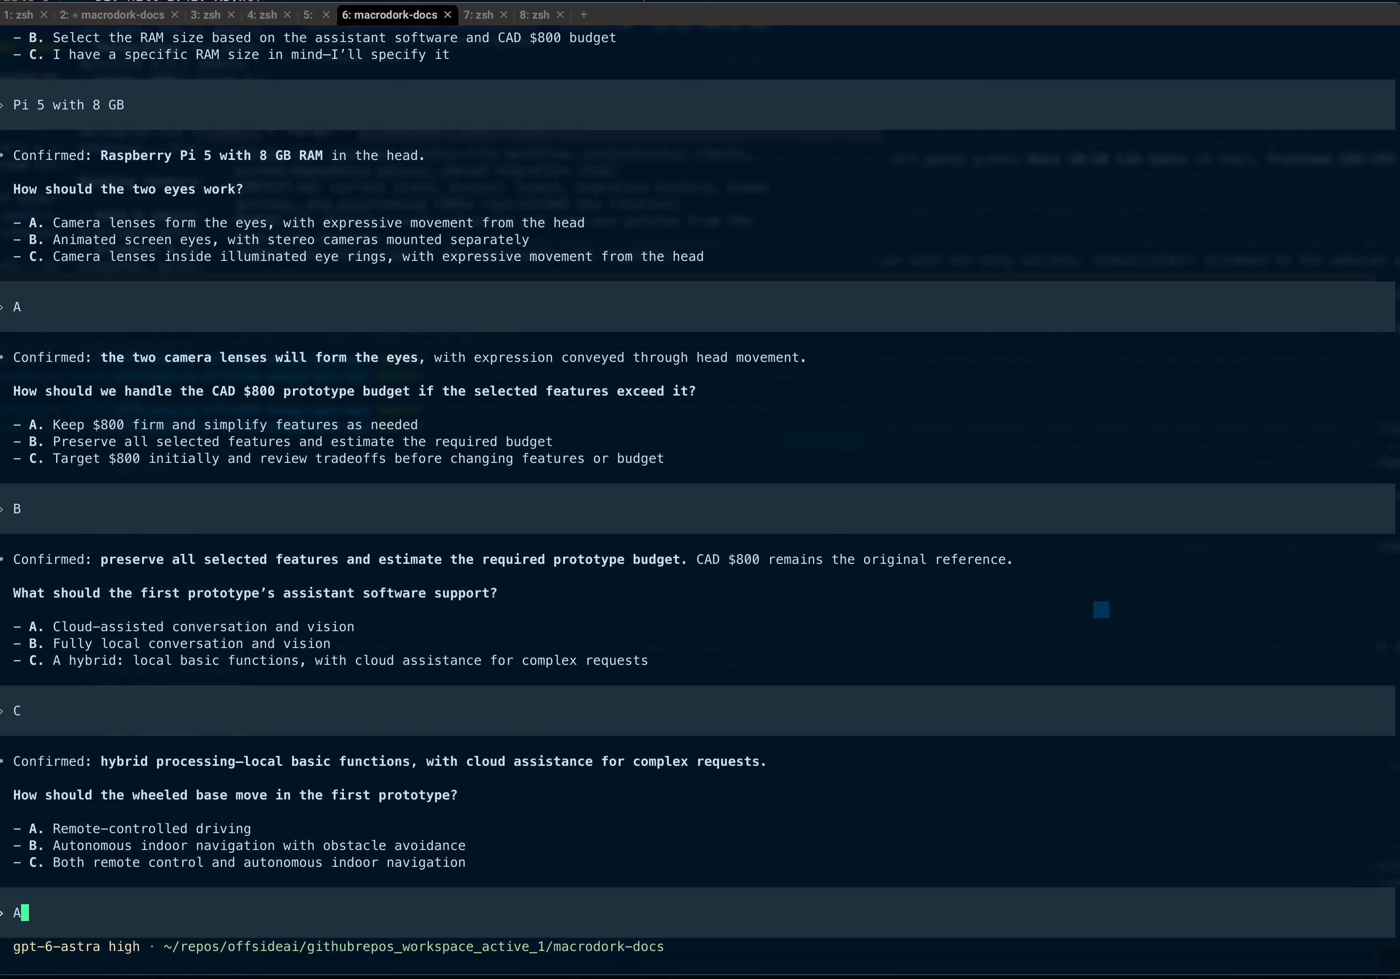
Mark-I-Build/specification/spec_16.png
