offsideAI/macrodork-docs/Mark-I-Build/specification/spec_20.png

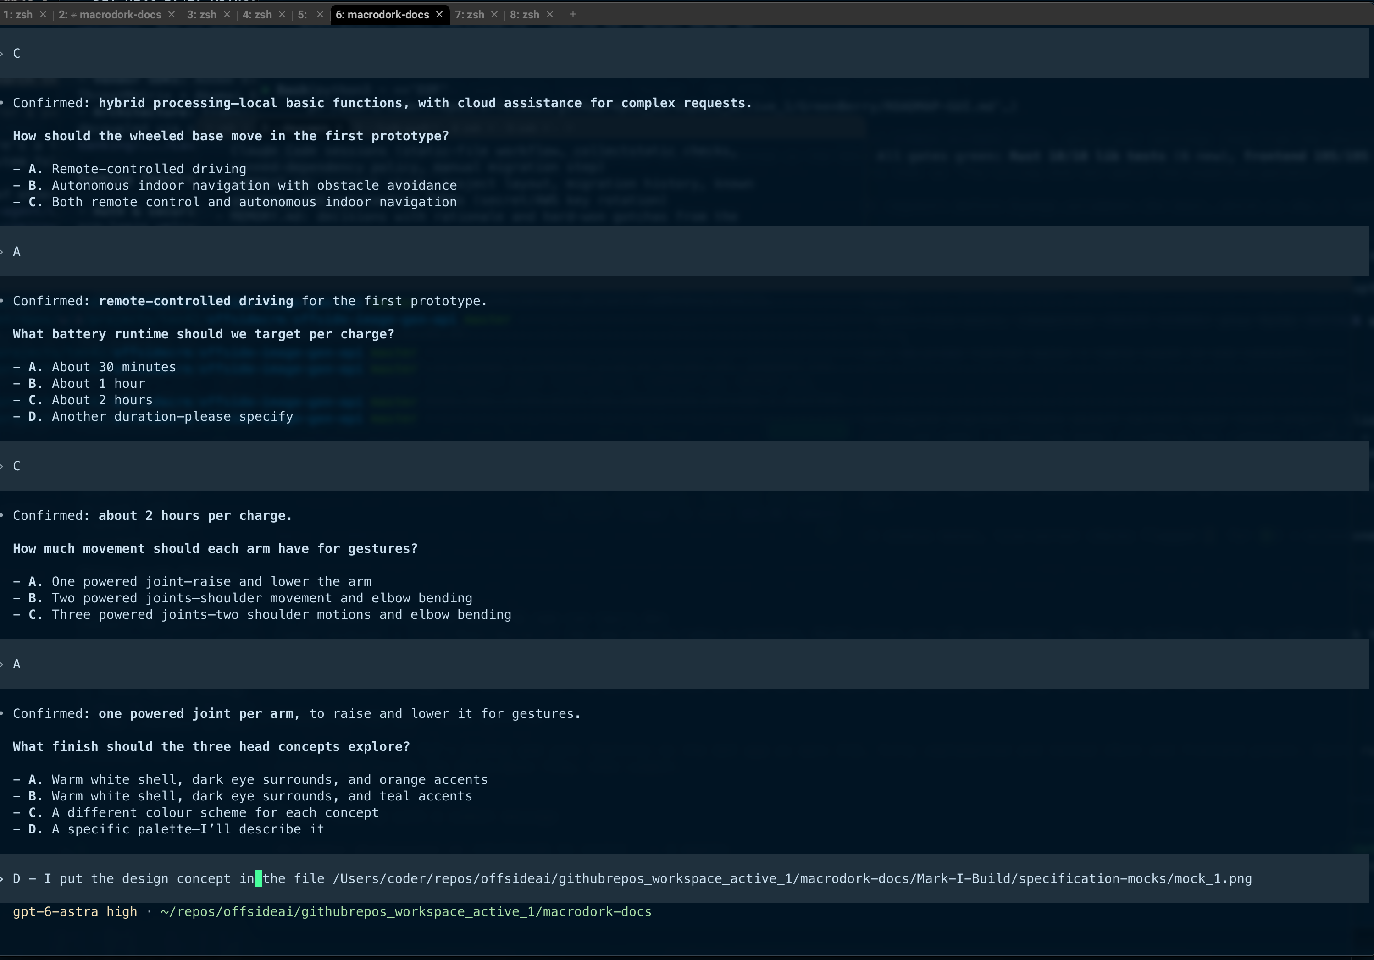
Mark-I-Build/specification/spec_20.png
