offsideAI/macrodork-docs/Mark-I-Build/specification/spec_21.png

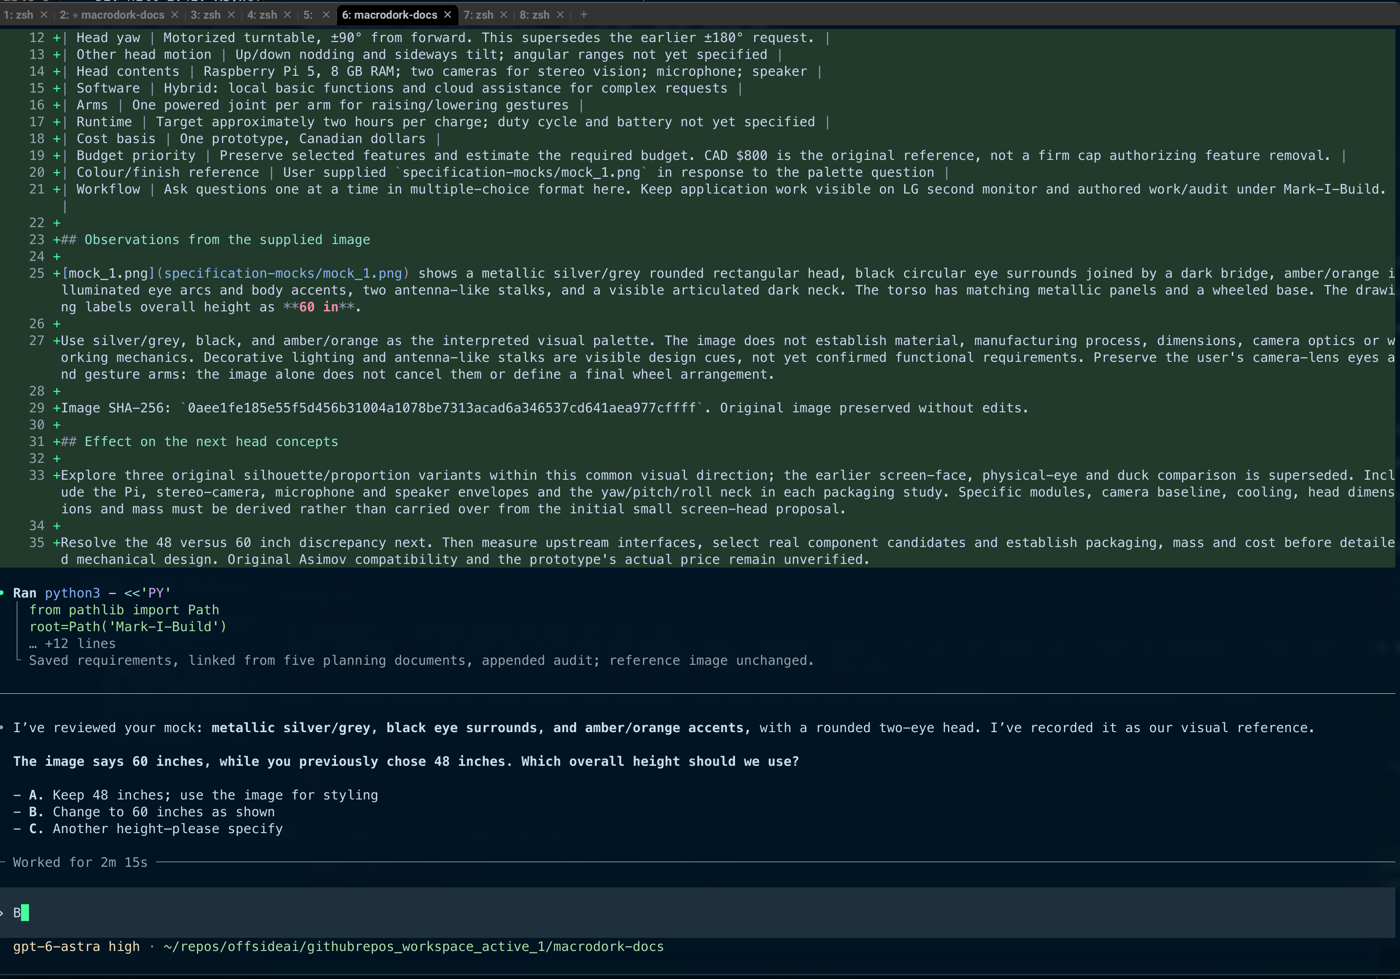
Mark-I-Build/specification/spec_21.png
