offsideAI/macrodork-docs/Mark-I-Build/specification/spec_22.png

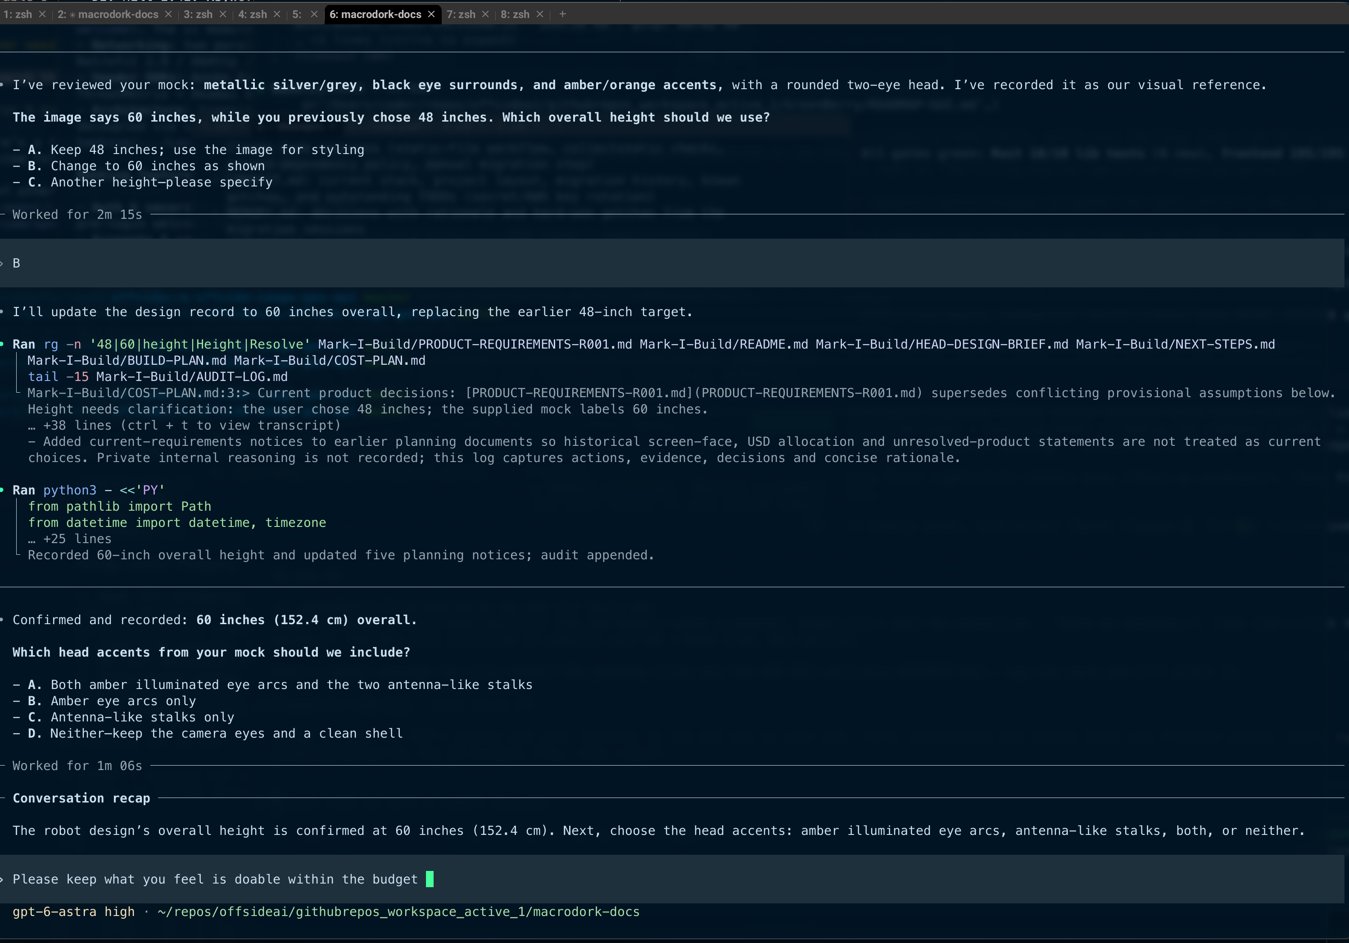
Mark-I-Build/specification/spec_22.png
