offsideAI/macrodork-docs/cad/10_head_assembly.stl

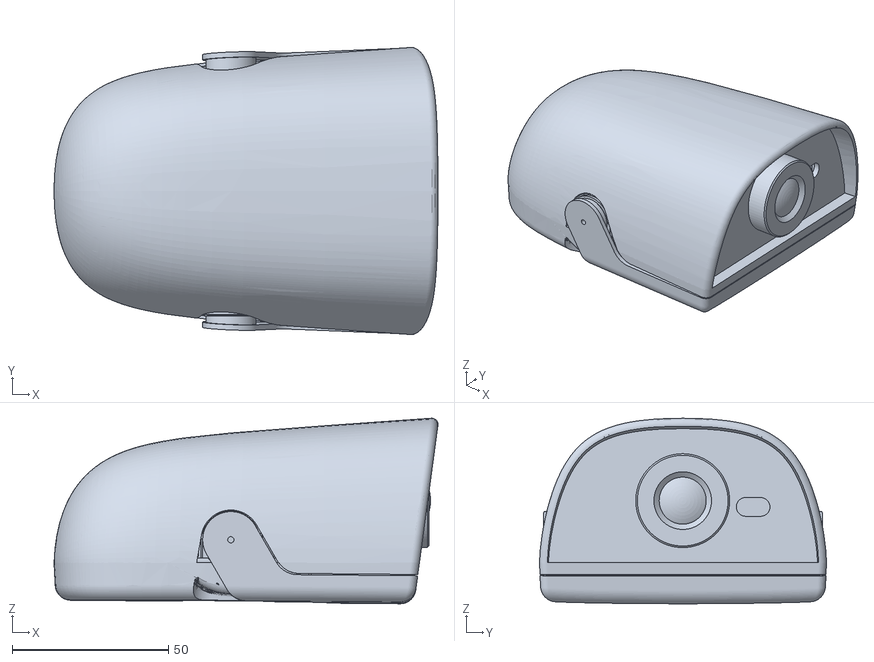
[picture p54: CAD file, 2026-09-04]
cad/10_head_assembly.stl
122.7 x 91.8 x 59.3
