offsideAI/macrodork-docs/cad/06_left_ankle_foot.stl

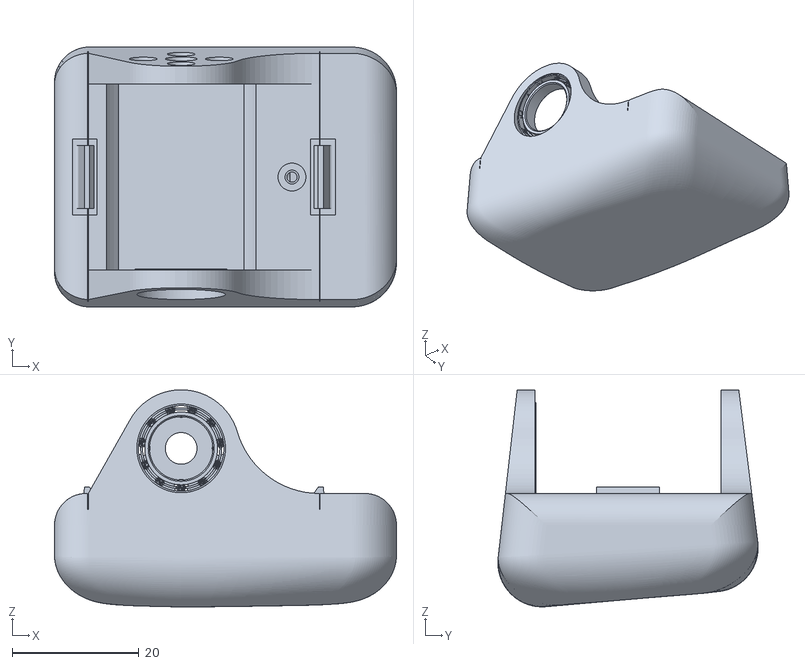
[picture p55: CAD file, 2026-09-04]
cad/06_left_ankle_foot.stl
54.0 x 41.1 x 34.2
