offsideAI/macrodork-docs/cad/07_neck_base.stl

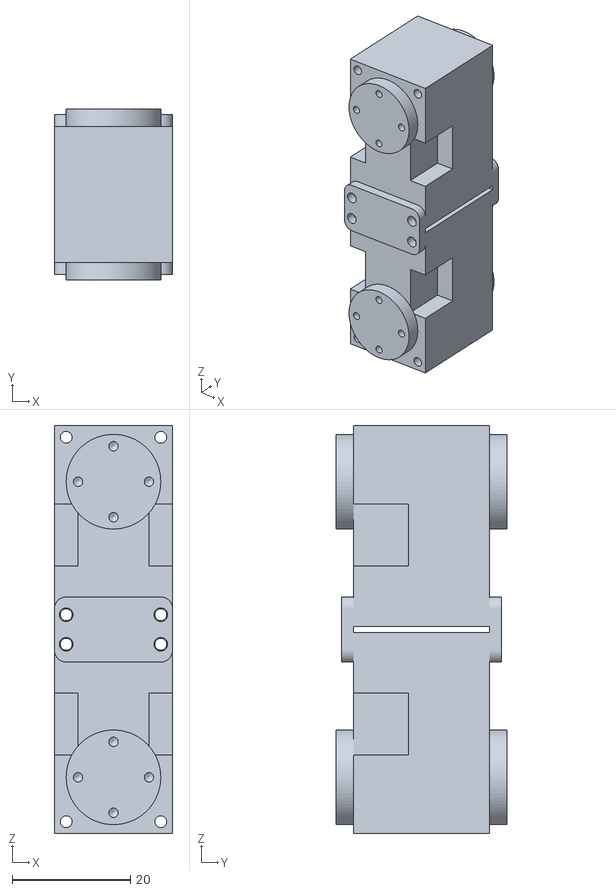
[picture p56: CAD file, 2026-09-04]
cad/07_neck_base.stl
20.0 x 29.0 x 69.0
