offsideAI/macrodork-docs/cad/09_head_yaw-roll.stl

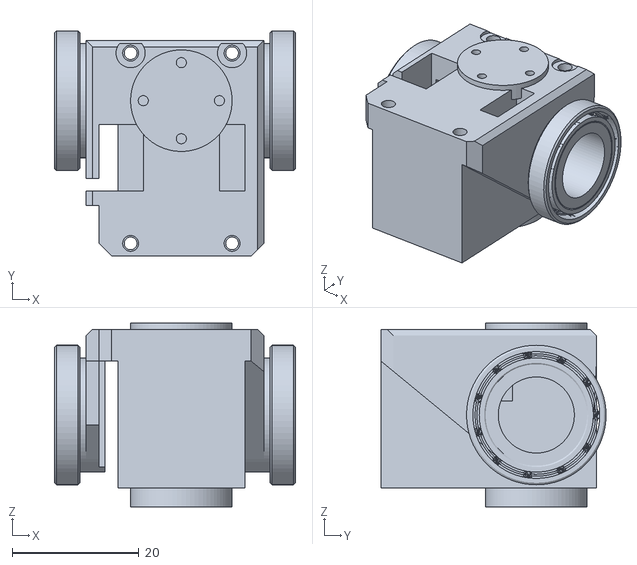
[picture p57: CAD file, 2026-09-04]
cad/09_head_yaw-roll.stl
38.0 x 35.5 x 29.0
