offsideAI/macrodork-docs/cad/02_left_hip_yaw-roll.stl

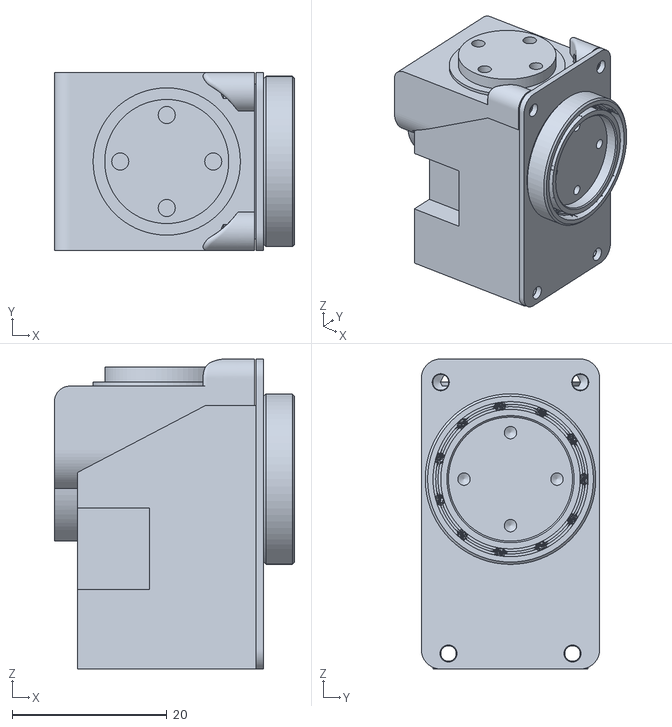
[picture p58: CAD file, 2026-09-04]
cad/02_left_hip_yaw-roll.stl
31.0 x 23.0 x 40.0
