offsideAI/macrodork-docs/cad/03_left_hip_roll.stl

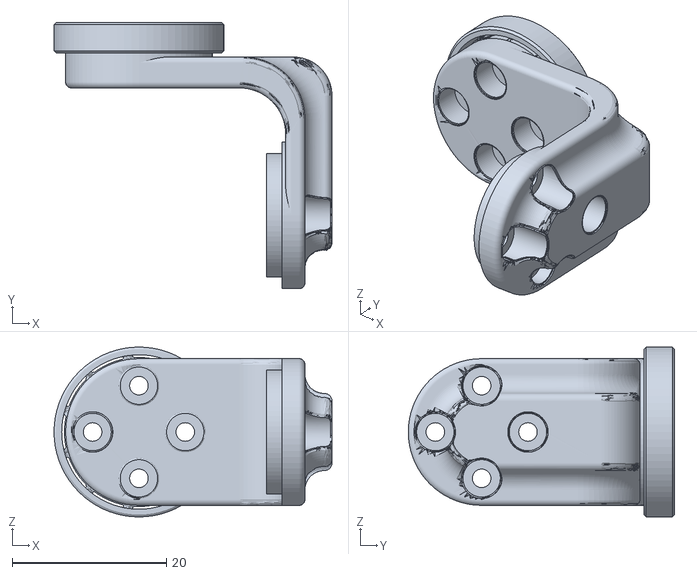
[picture p59: CAD file, 2026-09-04]
cad/03_left_hip_roll.stl
36.0 x 34.5 x 22.0
