offsideAI/macrodork-docs/cad/13_right_upper_leg.stl

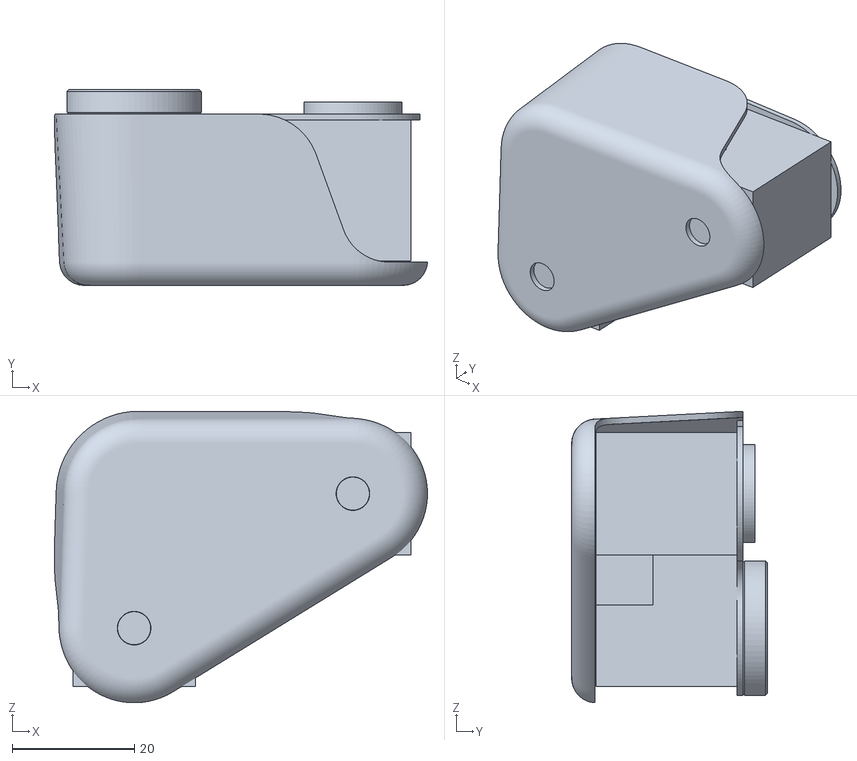
[picture p60: CAD file, 2026-09-04]
cad/13_right_upper_leg.stl
61.0 x 32.0 x 47.7
