offsideAI/macrodork-docs/cad/08_neck_pitch.stl

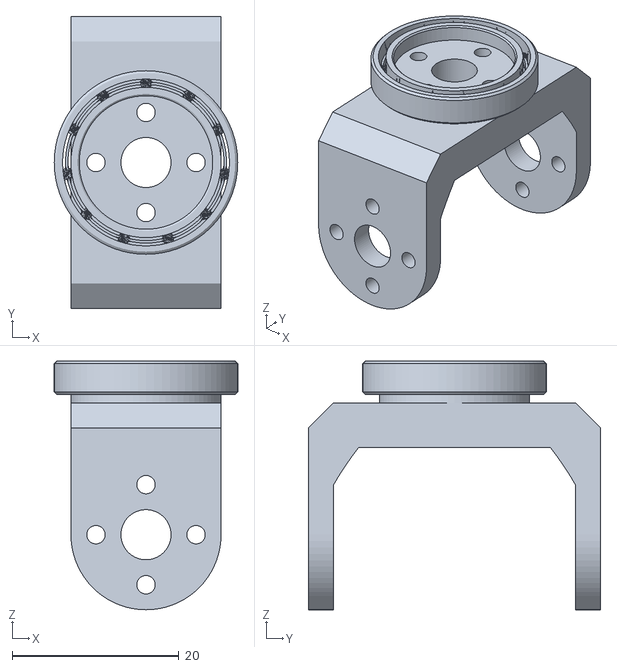
[picture p61: CAD file, 2026-09-04]
cad/08_neck_pitch.stl
22.0 x 35.0 x 29.8
