offsideAI/macrodork-docs/cad/01_trunk_body.stl

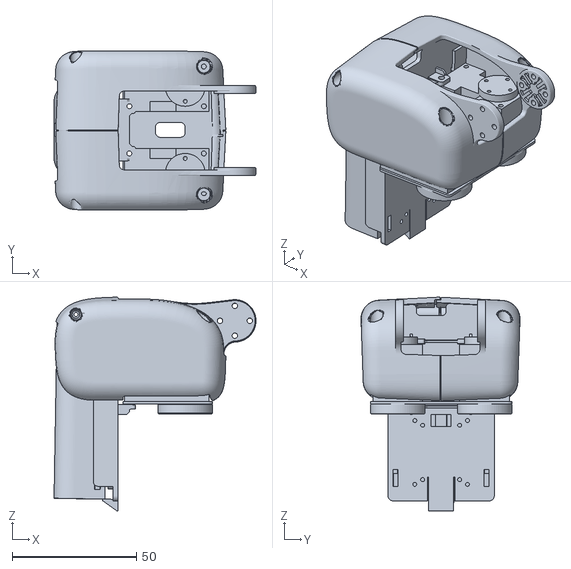
[picture p62: CAD file, 2026-09-04]
cad/01_trunk_body.stl
81.3 x 64.0 x 86.1
