offsideAI/macrodork-docs/cad/14_right_lower_leg.stl

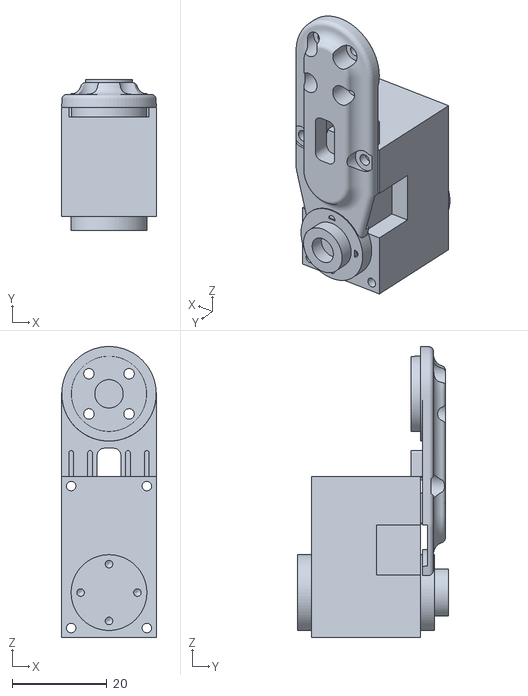
[picture p63: CAD file, 2026-09-04]
cad/14_right_lower_leg.stl
20.0 x 32.0 x 61.5
