offsideAI/macrodork-docs/(list of files, cad)

Other CAD files:
Mark-I-Build/exports/calibration-20mm-r001.step
cad/12_right_hip_roll.stl
cad/15_right_ankle_foot.stl
cad/11_right_hip_yaw-roll.stl
cad/04_left_upper_leg.stl
cad/05_left_lower_leg.stl
Mark-I-Build/blender/calibration-20mm-r001.blend
Mark-I-Build/blender/mark-i-full-body-r001.blend
Mark-I-Build/cad/calibration-20mm-r001.FCStd
Mark-I-Build/exports/calibration-20mm-r001.stl
