offsideAI/macrodork-docs/Mark-I-Build/manufacturing/PRINT-SHOP-RFQ-DRAFT.md

# Mark-I print-shop RFQ — draft, not sent

Purpose: prepare an accurate capability/quotation request. Replace all TBD fields and attach only the reviewed release files before sending. The current Blender concept is visual reference only and is not a print order.

Subject: Prototype quotation — Mark-I [P0 coupons / P1 head], revision [TBD]

We are developing a 60-inch indoor wheeled companion robot. The first planned order is a small coupon/fit set followed by a head-and-neck bench prototype. We need parts made to a revisioned manifest, with material/process and fit requirements agreed before manufacture.

Please confirm:

1. Available printing processes, material grades and usable build dimensions after support/brim allowance.
2. Accepted STL/3MF/STEP formats and how you confirm millimetre scale.
3. Achievable dimensional tolerances for the actual material, orientation and part size; whether critical holes/seats need secondary machining.
4. Proposed orientation/support strategy, cosmetic support marks, support/powder removal and any hollow-volume constraints.
5. Whether you install the specified inserts, source fasteners, assemble segments or offer metal-part fabrication.
6. Separate prices for as-printed parts, insert installation, assembly and silver/black/amber finishing.
7. Itemized price, currency (CAD preferred), setup/minimum charges, shipping/tax, lead time, quote expiry and reprint/nonconformance policy.
8. Proposed design changes before quotation or production. Please return modified/repaired geometry for review before manufacturing it.

Order specification to complete:

| Field | Value |
|---|---|
| Release identifier / checksum manifest | TBD |
| Unique part IDs and quantities | Attach finalized parts.csv |
| Overall reference | 1524 mm robot; head concept approximately 500 mm wide, actual released parts TBD |
| Manufacturing process/material grade | TBD with engineering and shop |
| Critical dimensions / datums | Per part drawings and inspection sheet |
| Finish / visible surfaces | Per part drawings; quote unpainted and finished separately |
| Insert/fastener installation | Part numbers, locations and responsibility TBD |
| Assembly responsibility | TBD; identify shop assembly versus customer assembly |
| Delivery location and required date | TBD |

Planned attachments: parts manifest, one mesh per unique printed part, STEP where accepted, part drawings, assembly reference, inspection sheet and checksums. Mark concept renders REFERENCE ONLY. No Gerbers are expected for this polymer-print order; a custom PCB order, if needed, will go to a PCB/PCBA supplier separately.
