offsideAI/macrodork-docs/artifacts/asimov-1-budget-build.html

Procurement study · September 2026

# Asimov-1 Budget Build

What Menlo's open humanoid actually costs, why an $800 one-to-one copy is impossible, and a fully priced bill of materials and a 3D render for a 40 percent scale derivative that keeps the Asimov-1 joint topology, parallel ankle and control split on hobby bus servos.

Source: docs.menlo.ai/asimov/1 and github.com/menloresearch/asimov-1 Prices: US and China-direct listings, ex shipping and tax

Official DIY kit

$20,000

All parts, unassembled, shipping now

Self-source path

≈$30,000

Menlo's own estimate, about 100 h assembly

This build, tier A

$785

23 powered joints, 50 cm, about 2.3 kg

## 1. What Asimov-1 is

Asimov-1 is a 1.2 m, 35 kg biped with 25 powered joints. Hardware is released under CERN-OHL-S-2.0 and software under GPL-2.0. The repository carries the full mechanical CAD in seven sub-assemblies, KiCad sources for four boards, a MuJoCo MJCF and a URDF, and a fabrication manifest generator.

Subsystem | Specification
Joints | 6 per leg (hip pitch, roll, yaw, knee, ankle pitch, roll), 5 per arm (shoulder pitch, roll, yaw, elbow, wrist yaw), waist yaw, neck yaw and pitch. The locomotion policy runs on 23 joints with the neck locked.
Ankle | Parallel RSU mechanism. Two actuators A and B drive a bar; firmware maps theta_A, theta_B to pitch and roll. Fixed flat feet (v0's passive toe was dropped).
Actuators | Five Encos quasi-direct-drive models, CAN at 1 Mbps, each with two equivalent XT30 (2+2) ports carrying BATT+, BATT−, CAN_H, CAN_L. Six daisy-chain branches enter at both hip pitches, waist yaw, both shoulder pitches and neck yaw.
Motion control | RPU: Radxa CM5 on a custom Motion Control Board with an LSM6DSV IMU and six SPI-CAN ports, plus a stacked Power Distribution Board with an XT90 (2+2) input.
Media | Raspberry Pi 5 in the head on a custom head board (buck converters, audio codec) and a small HAT. 2 MP monocular camera, stereo microphone array, one 10 W 4 Ω speaker. Direct Ethernet to the RPU.
Interface | LiveKit / WebRTC. Protobuf commands (velocity, 25-joint trajectory with per-joint kp and kd, mode), 10 Hz telemetry, H.264 720p30 video, Opus audio. Trajectory sessions stream at about 50 Hz and fall back to DAMP on packet loss.
Power | 13S4P INR18650 pack, 46.8 V nominal, 10.5 Ah, 491 Wh, 30 A discharge limit, about 2 kg.
Structure | 7075 aluminium and MJF PA12 nylon; 43 aluminium, 18 stainless 316L and 37 nylon fabricated parts plus 67 off-the-shelf items in the manifest.
Rated loads | 5 kg squat; 5 kg per arm curl and front raise; 6 kg lateral raise; peaks 15 to 18 kg per arm.

## 2. Why $800 cannot buy a one-to-one copy

The actuators alone are the whole problem. Retail prices for the five Encos models used on the robot, with the count of each on the body:

Actuator | Joints | Qty | Rated / peak | Unit price | Subtotal
EC-A6416-P2-25 | Hip pitch ×2, waist yaw | 3 | 40 / 120 N·m | $925 | $2,775
EC-A5013-H17-100 | Hip roll ×2, shoulder pitch ×2 | 4 | 30 / 90 N·m | $1,500 | $6,000
EC-A3814-H14-107 | Hip yaw ×2, shoulder yaw ×2 | 4 | 20 / 60 N·m | $1,375 | $5,500
EC-A4315-P2-36 | Knee ×2, shoulder roll ×2 | 4 | 25 / 75 N·m | ≈$800 est. | ≈$3,200
EC-A4310-P2-36 | Ankle A/B ×4, elbow ×2, wrist ×2, neck ×2 | 10 | 12 / 36 N·m | $700 | $7,000
Actuators only | | 25 | | | ≈$24,500

That is thirty times the budget before the battery, two compute boards, four custom PCBs, 43 machined 7075 parts and 37 MJF nylon parts. The EC-A4315 price is interpolated between its neighbours; the other four are listed prices at a US reseller. No amount of substitution inside the 1.2 m frame changes this, because a 35 kg biped needs 120 N·m hips and nothing in that class costs less than a few hundred dollars.

The way to $800 is scale, not substitution. Joint torque scales with mass times lever arm. Shrinking the same geometry by a factor s cuts mass by about s³ and torque demand by about s⁴. At s = 0.40, the 120 N·m hip becomes a 3 N·m hip, which is exactly the range of $15 to $45 serial bus servos.

## 3. The derivative: Asimov-1 at 40 percent

Scale factor 0.40 is chosen because it is the largest size at which a 30 kg·cm class bus servo still covers most joints, and because K-Scale's Z-Bot (40 cm, about 2 kg, sixteen STS3215-class servos, roughly $500 BOM) proves a 3D-printed biped walks at this size on these servos.

Dimension | Asimov-1 | At 0.40
Height | 1.25 m to head top | 0.50 m
Mass | 35 kg | ≈2.3 kg
Pelvis height (MJCF) | 630 mm | 252 mm
Thigh, hip yaw to knee | 218 mm | 87 mm
Shin, knee to ankle | 272 mm | 109 mm
Hip spacing | 135 mm | 54 mm
Shoulder span | 193 mm | 77 mm
Upper arm / forearm | 129 / 97 mm | 52 / 39 mm

Joint role | Peak, full size | Peak × 0.40⁴ | Servo
Hip pitch | 120 N·m | 3.1 N·m | STS3250
Knee | 75 N·m | 1.9 N·m | STS3250 continuous stance load
Hip roll | 90 N·m | 2.3 N·m | STS3215 first upgrade candidate
Hip yaw, shoulder yaw | 60 N·m | 1.5 N·m | STS3215
Shoulder pitch / roll | 90 / 75 N·m | 2.3 / 1.9 N·m | STS3215 payload scales to 0.3 kg
Ankle A / B | 36 N·m | 0.9 N·m | STS3215
Elbow, wrist, neck | 36 N·m | 0.9 N·m | STS3215
Waist yaw | 120 N·m | 3.1 N·m | STS3215 no gravity load

STS3215 stall torque 30 kg·cm (2.9 N·m) at 12 V; STS3250 stall 50 kg·cm (4.9 N·m). Bus servos sustain roughly a third of stall continuously, so joints that carry the body in single stance get the larger servo. The scaled peak column uses Asimov-1's own published peaks, which already include its safety margins.

### What is kept from Asimov-1

- Topology. Same 25-joint layout and joint axes, so the published MJCF and URDF can be rescaled rather than remodelled, and the locomotion training guides apply unchanged. Tier A locks the neck exactly as Asimov's policy does.
- Parallel RSU ankle. Two servos on a bar with the same A/B to pitch/roll mapping. At this size the linkages are M3 rod ends on threaded rod.
- Six-branch daisy chain. Feetech's TTL bus carries power and data on one 3-wire cable like the XT30 (2+2) CAN chain, so the six branch entries (both hips, waist, both shoulders, neck) are reproduced with two driver boards and a small distribution board.
- Control split. Asimov keeps the motion loop on the RPU and media on a Pi 5. The budget build runs both on one Pi 5 but keeps the same boundary in software: a real-time servo loop process and a separate LiveKit media process, matching the published protobuf command and telemetry schema.

### What is given up

- Payload. Rated loads scale to about 0.3 kg per arm. This is a locomotion and control research platform, not a lifter.
- Torque control. Feetech STS servos offer position, velocity and current feedback but not the current-mode torque control of the Encos actuators. Policies trained with PD position targets deploy fine; torque-space policies do not.
- Structure. FDM PETG replaces 7075 aluminium and MJF PA12. Print structural parts at 5 or more walls and 40 percent infill.
- Bus bandwidth. One 1 Mbps TTL chain of 12 servos sustains a 50 Hz sync read and write with margin; 25 on one chain does not, hence the split into two chains.

## 4. Render of the tier A build

The link shells are Asimov-1's own published simulation meshes, scaled by 0.40 and placed with the joint positions and axes from the MJCF. The servos, the Raspberry Pi 5, the 3S battery and the two bus driver boards are drawn at true size, which is the point: at this scale the electronics are no longer small relative to the body, and the render shows where they have to go.

Front Side ¾ Photo

Printed shells X-ray Servos Electronics

PETG shells, Asimov-1 geometry × 0.40 STS3250 · hip pitch, knee STS3215 · 19 joints Neck servos, tier B only Pi 5 and driver boards 3S 5200 mAh pack

Drag to orbit, scroll to zoom. Grid squares are 100 mm; the ruler runs to 500 mm. Photo puts the robot on a turntable in a studio: an infinity cove, a polished floor, a softbox key on a stand, an octabox hair light on a boom and a reflector, with soft shadows, ACES filmic tone mapping and clearcoat plastics, all generated in the page.

What is faithful here: proportions, joint placement, joint axes, servo count and every component envelope. What is schematic: the printed brackets. The real tier A parts are re-pocketed around the 45.2 × 24.7 × 35 mm servo case rather than around Encos actuators, so the shells shown are the outer envelope the printed parts must stay inside, not the final print files. The torso envelope at this scale is 85 × 100 × 151 mm; the Pi 5 stands in the chest and the battery in the back with about 40 mm of depth to spare. Head top lands at 0.50 m.

## 5. Bill of materials

Tier A is the $800 build: 23 powered joints with the head fixed. Tier B adds the two neck joints and the same sensor grade Asimov uses. Prices are the lowest widely available listing in September 2026; China-direct servo prices are from Alibaba tiers at quantities of 2 or more.

Item | Part | Qty | Unit | Tier A | Tier B
Actuation
Hip pitch, knee | Feetech STS3250, 12 V, 50 kg·cm, magnetic encoder, TTLChina-direct; US retail listings run $60 to $75 | 4 | $42.00 | $168.00 | $168.00
All other joints | Feetech STS3215, 12 V, 30 kg·cm, magnetic encoder, TTLAlibaba tier price at 2 to 499 pcs; US retail $38 to $40 | 19 / 21 | $16.45 | $312.55 | $345.45
Servo hardware | Metal horn and bracket set for STS3215 ×10, spare 3-pin bus cables ×20 | 1 | $21.00 | $21.00 | $21.00
Compute and bus
Main computer | Raspberry Pi 5, 2 GBPi 5 memory pricing rose through 2026; 1 GB is $45, 4 GB about $65. Radxa Rock 5C Lite at $29.90 keeps the Rockchip lineage if you drop the Pi camera stack | 1 | $60.00 | $60.00 | $60.00
Storage | 32 GB A2 microSD | 1 | $8.00 | $8.00 | $8.00
Bus interface | Waveshare Serial Bus Servo Driver Board (UART TTL, 6 to 12 V servo power in) ×2, one per chain: legs / upper bodyA $7 Feetech FE-URT-1 works for a single USB chain | 2 | $15.00 | $30.00 | $30.00
Power distribution | XT60 input, 5 A blade fuse, six JST-XH branch outputs on perfboard, 20 AWG silicone wire | 1 | $15.00 | $15.00 | $15.00
Sensing and media
IMU | Tier A: ICM-42688-P 6-axis breakout, I²C or SPI Tier B: SparkFun Micro 6DoF LSM6DSV16X, the same sensor family as the Asimov MCB, with on-chip fusion | 1 | $6 / $25 | $6.00 | $25.00
Camera | Tier A: OV5647 5 MP CSI module Tier B: Raspberry Pi Camera Module 3, autofocus | 1 | $8 / $25 | $8.00 | $25.00
Audio | USB mini microphone, 3 W 4 Ω speaker with PAM8403 amplifier | 1 | $10.00 | $10.00 | $10.00
Power
Battery | 3S 11.1 V 5200 mAh LiPo, XT60Sits inside the 6 to 12.6 V window of the 12 V STS servos; about 55 Wh for roughly 35 to 45 minutes of walking | 1 | $30.00 | $30.00 | $30.00
Charger | Balance charger, 3S, 2 A | 1 | $15.00 | $15.00 | $15.00
5 V rail | 5 V 5 A buck converter for the Pi and sensors | 1 | $8.00 | $8.00 | $8.00
Switching | Main power switch, XT60 pigtails, low-voltage buzzer | 1 | $5.00 | $5.00 | $5.00
Structure
Printed parts | PETG filament, 2 kg, printed on a 220 mm bedReplaces 43 aluminium, 18 stainless and 37 MJF nylon parts; all parts fit a desktop printer at 0.40 scale | 2 kg | $18.00 | $36.00 | $36.00
Fasteners | M2 and M3 socket screw assortment, nyloc nuts | 1 | $12.00 | $12.00 | $12.00
Inserts | M2 and M3 heat-set inserts, 100 each | 1 | $10.00 | $10.00 | $10.00
Bearings | Idler-side bearings for each joint (6700ZZ or servo-matched), 25 | 1 | $10.00 | $10.00 | $10.00
Ankle linkage | M3 rod ends ×8, M3 threaded rod, jam nuts, for the two RSU ankles | 1 | $12.00 | $12.00 | $12.00
Sundries | Heat-shrink, Wago 221, zip ties, thread locker | 1 | $8.00 | $8.00 | $8.00
Total, ex shipping and tax | | | | $784.55 | $853.45

Actuation $502 (64%) Compute and bus $113 (14%) Sensing $24 (3%) Power $58 (7%) Structure $88 (11%)

Where the budget breaks. Buying the 23 servos at US retail instead of China-direct adds about $520 and puts Tier A at roughly $1,300. Shipping from China on a 23-servo order is typically $30 to $60. Import duty depends on destination. The $785 figure holds only if the servos come from Alibaba or AliExpress.

## 6. Upgrades in order of value

1. Hip roll to STS3250 (+$51). The 2.3 N·m scaled peak is the closest call in the table.
2. Neck joints (+$33). Restores the full 25-joint topology so the head can track.
3. LSM6DSV16X IMU (+$19). On-chip sensor fusion frees the Pi from the orientation filter and matches the Asimov MCB sensor.
4. Pi Camera Module 3 (+$17). Autofocus and a sensor Raspberry Pi OS supports out of the box.
5. Second battery (+$30). Training-data collection sessions outlast a single 3S pack.

## 7. How this compares

Platform | Height | Joints | Actuators | Cost
Asimov-1 (Menlo) | 1.20 m | 25 | Encos QDD, CAN | $20,000 kit / ≈$30,000 self-source
ToddlerBot (Stanford) | 0.56 m | 30 | Dynamixel | ≈$6,000
Berkeley Humanoid Lite | 0.80 m | 22 | Printed cycloidal on BLDC | $3,236 to $4,312
K-Scale Z-Bot | 0.40 m | 12 to 16 | Feetech STS3215 | ≈$500 BOM, $999 kit
Asimov-1 at 0.40, tier A | 0.50 m | 23 | Feetech STS3215 / STS3250 | $785

The budget build sits between Z-Bot and ToddlerBot in size and joint count at a Z-Bot price, which is what the Asimov topology on bus servos should cost.

## 8. Build notes

- CAD. Rescale the Asimov-1 STEP tree by 0.40, then replace each Encos envelope with the 45.2 × 24.7 × 35 mm case shared by the STS3215 and STS3250 and re-pocket the mounts. Keep the joint axes where the MJCF puts them.
- Simulation. Scale link lengths by 0.40, masses by the printed-part estimates, and set actuator limits from the servo stall curves. The Asimov locomotion-training guides on docs.menlo.ai apply directly; retrain, do not reuse the shipped policy.
- Servo IDs. Assign the same 1 to 25 map Asimov uses (left leg 1 to 6, right leg 7 to 12, arms 13 to 22, waist 23, neck 24 and 25) so the firmware joint order and the trajectory message layout carry over.
- Voltage. Run everything from the 3S pack. Do not mix 7.4 V and 12 V servo variants on one bus; the STS3250 is 12 V only.
- Falls. Print the head and hand shells in TPU or add foam. At 2.3 kg a fall is survivable; at 35 kg Asimov relies on serviceable "off-the-shelf failure points", which the small build gets for free from cheap servos and reprintable parts.

## Sources

- Asimov 1 overview (https://docs.menlo.ai/asimov/1), mechanical (https://docs.menlo.ai/asimov/1/overview/system-tour/mechanical), electrical (https://docs.menlo.ai/asimov/1/overview/system-tour/electrical) and software (https://docs.menlo.ai/asimov/1/overview/system-tour/software) system tours; self-source path (https://docs.menlo.ai/asimov/1/assembly-preparations/self-source) ($30,000 estimate); API protocols (https://docs.menlo.ai/asimov/1/api/protocols)
- menloresearch/asimov-1 (https://github.com/menloresearch/asimov-1) (CAD, KiCad, MJCF, $20,000 kit) and asimov-v0 (https://github.com/menloresearch/asimov-v0) (Encos motor list)
- Encos prices: EC-A4310 $700 (https://aifitlab.com/products/encos-ec-a4310-p2-36-motor), EC-A6416 $925, EC-A3814 $1,375 (https://aifitlab.com/collections/encos-motor), EC-A5013 $1,500 (https://aifitlab.com/products/encos-ec-a5013-h17-100-motor)
- Feetech: STS3215 12 V $16.45 on Alibaba (https://www.alibaba.com/product-detail/Feetech-STS3215-SO-ARM100-Servo-12V_1601292634404.html), $38.94 on eBay (https://www.ebay.com/itm/277573408603); STS3250 on eBay (https://www.ebay.com/itm/277294695337); FE-URT-1 $6.98 (https://www.alibaba.com/product-detail/Feetech-FE-URT-1-Multi-function-1601003839109.html)
- Compute: Raspberry Pi 5 pricing, 2026 (https://www.raspberrypi.com/news/1gb-raspberry-pi-5-now-available-at-45-and-memory-driven-price-rises/), 2 GB launch price (https://m.gsmarena.com/cheaper_2gb_raspberry_pi_5_launches_at_50-news-64188.php), Radxa Rock 5C Lite $29.90 (https://shop.allnetchina.cn/)
- Sensors: SparkFun LSM6DSV16X (https://thepihut.com/products/sparkfun-micro-6dof-imu-breakout-lsm6dsv16x)
- Comparables: K-Scale Z-Bot (https://www.awesomerobots.xyz/robots/kscale-zbot), Zeroth bot, 16 STS3215 (https://circuitdigest.com/news/zeroth-bot-an-opensource-risc-v-powered-humanoid-robot), Berkeley Humanoid Lite (https://www.rdworldonline.com/berkeley-debuts-5000-open-source-humanoid-built-with-desktop-3d-printers/), ToddlerBot (https://www.roboticgizmos.com/toddlerbot-6k/)

Prices are the lowest widely available listing on 4 September 2026 and exclude shipping, duty and tax. Items priced without a linked source (brackets, wiring, fasteners, filament, ankle linkage) are typical AliExpress and Amazon assortment prices and are the least certain part of the total.
