offsideAI/macrodork-docs/Mark-I-Build/website/foreground-lg-review.png

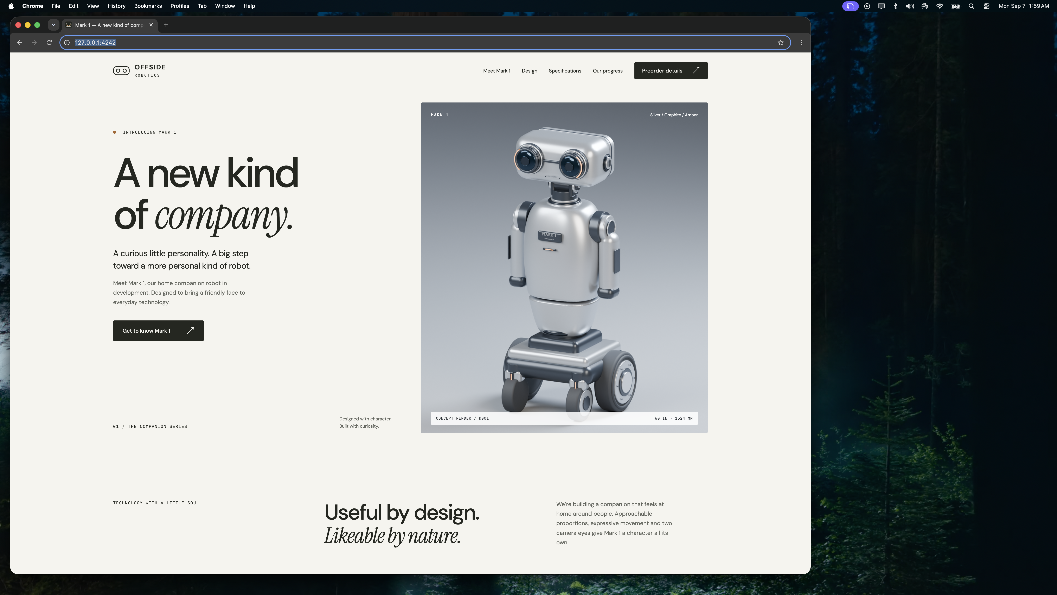
Mark-I-Build/website/foreground-lg-review.png
