offsideAI/macrodork-docs/Mark-I-Build/website/mark-1-dark-desktop.png

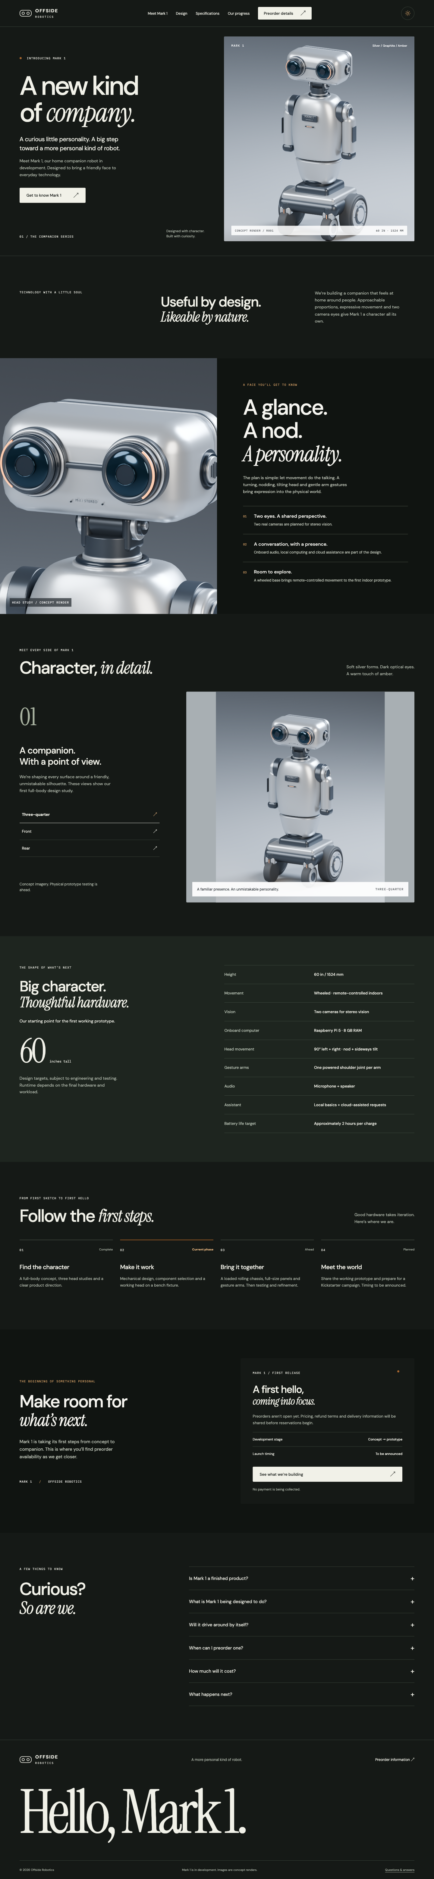
Mark-I-Build/website/mark-1-dark-desktop.png
