offsideAI/macrodork-docs/Mark-I-Build/website/mark-1-website-320.png

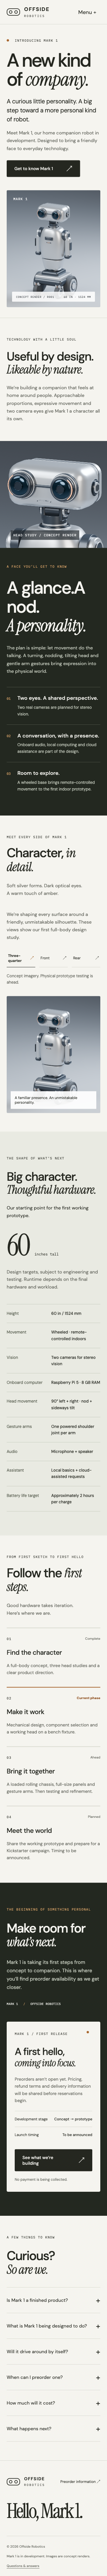
Mark-I-Build/website/mark-1-website-320.png
