offsideAI/macrodork-docs/Mark-I-Build/website/mark-1-website-1440.png

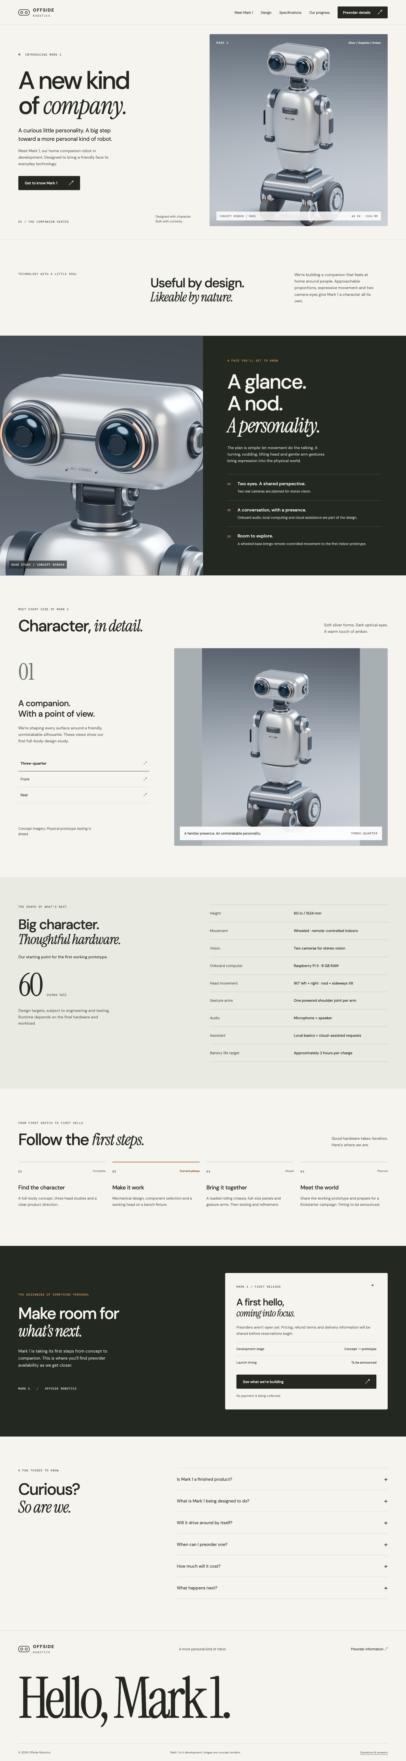
Mark-I-Build/website/mark-1-website-1440.png
