offsideAI/macrodork-docs/Mark-I-Build/renders/calibration-20mm-r001.png

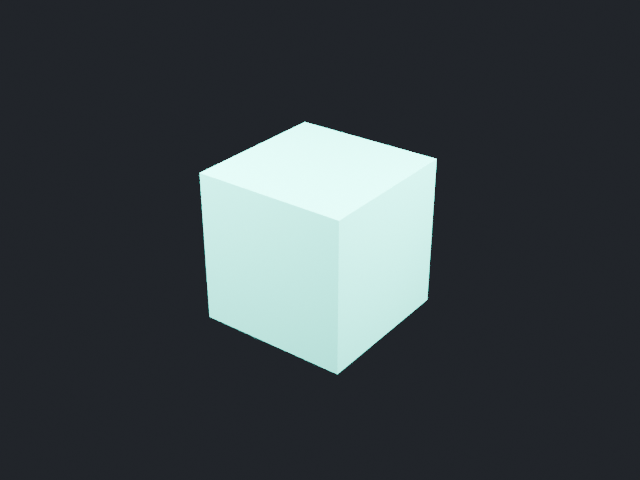
Mark-I-Build/renders/calibration-20mm-r001.png
