offsideAI/macrodork-docs/Mark-I-Build/website/mark-1-test-preorder.png

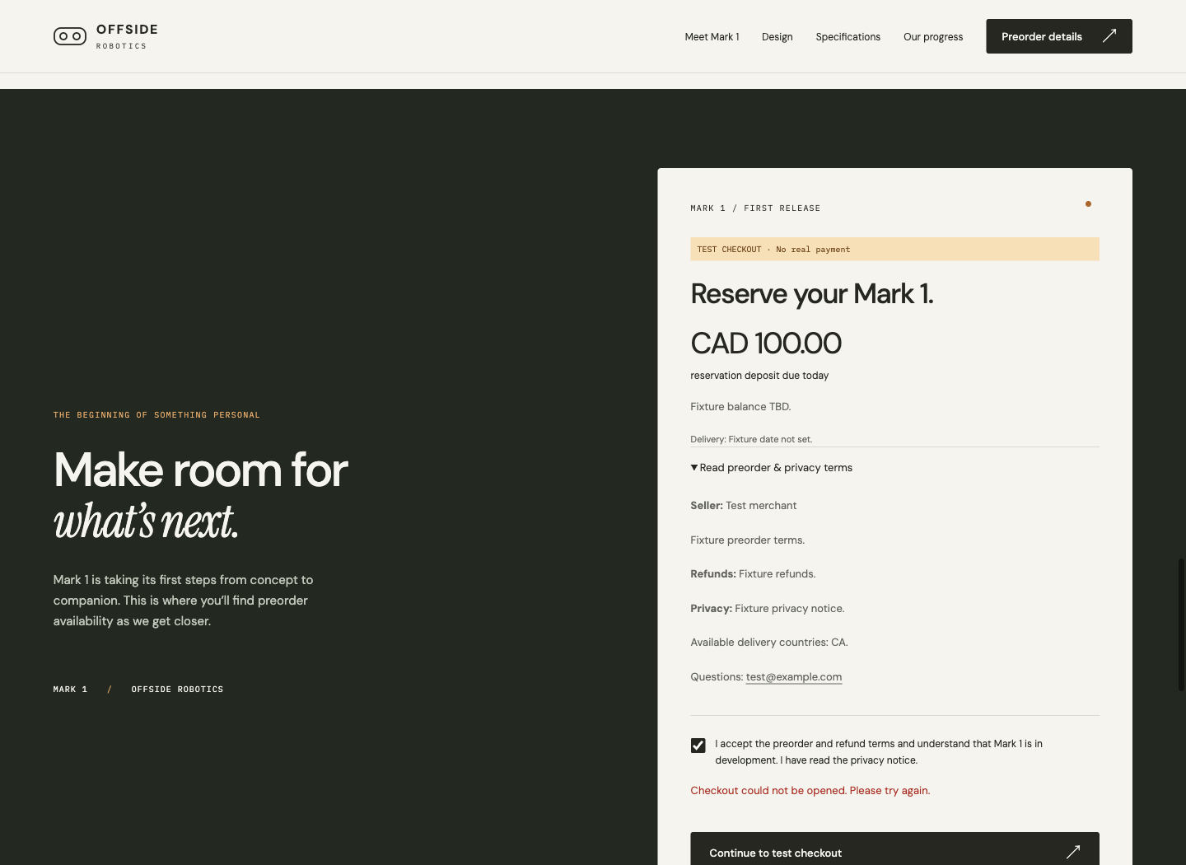
Mark-I-Build/website/mark-1-test-preorder.png
