offsideAI/macrodork-docs/(commit log)

2026-09-04 Initial import of Macrodork documentation and tooling
    Assembly drawings, CAD-importable assemblies, bill of materials, fastener
    reconstruction, electronics teardown and sourcing lists for an open,
    buildable bipedal robot duck, recovered from publicly released simulation
    files and runtime source.
    Project identity:
    - README leads with what this project adds; the open-hardware discussion
    and its dated correction move to docs/upstream/provenance.md.
    Printable parts:
    - Upstream STLs are no longer stored. scripts/build_print_tree.py
    generates print/ from upstream commit d424a0c (2026-08-27), the baseline
    every count in the docs was taken from, and print/**/*.stl is ig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
    [01_trunk_body.stl, 02_left_hip_yaw-roll.stl, 03_left_hip_roll.stl, 04_left_upper_leg.stl, 05_left_lower_leg.stl, 06_left_ankle_foot.stl, 07_neck_base.stl, 08_neck_pitch.stl]
2026-09-06 Add OffsideRobotics site, Asimov-1 study, Longshot visionOS game
    Three new work areas on top of the initial documentation import, plus a
    gitignore fix that was hiding two committed-looking pages.
    OffsideRobotics website (macrodork-web/):
    - React 19 + Vite 6 marketing site for MacroDork, one page, eleven
    components, no UI framework. Design language modelled on menlo.ai:
    full-viewport brand-colour hero with the robot standing on it, floating
    white pill nav with uppercase mono labels, rounded media tiles, frosted
    product cards, mono-labelled contact form, FAQ band, dark footer with a
    giant wordmark. Manrope, IBM Plex Mono and Michroma from Google Fonts.
    - Light an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
2026-09-09 Add Mark-I build workspace and rework the site around Mark 1
    Mark-I-Build/: the working folder for the first full-body companion
    robot prototype.
    - Product requirements R001 (60 in / 1524 mm wheeled body, camera-eye
    head, gesture arms), design notes, build plan, cost plan, head design
    brief, toolchain and Blender MCP setup, verification results, audit log.
    - Blender sources for the full-body concept and a 20 mm calibration cube,
    the matching FreeCAD file, STEP/STL/GLB exports with checksums, renders
    and head-proportion studies.
    - Manufacturing: print-shop RFQ draft, prototype release plan and
    checklist, part register P001, budget targets.
    - logs/: screenshots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
    [budget-targets.csv, calibration-20mm-r001.FCStd, calibration-20mm-r001.blend, calibration-20mm-r001.step, calibration-20mm-r001.stl, mark-i-full-body-r001.blend, part-register-P001.csv]
