offsideAI/macrodork-docs/(notices)

Notices in the files:
artifacts/asimov-1-budget-build.html:
the 3D model data is embedded. Mesh geometry derives from menloresearch/asimov-1 (CERN-OHL-S-2.0); see ../NOTICE.md.
